plauer03/T3_3200/README.md

# T3_3200
Studienarbeit II - Entwicklung eines BLDC-Motorcontrollers

STRG + SHIFT + P
Settings.json
```json
{
    "workbench.colorTheme": "Ayu Mirage Bordered",
    "vs-kubernetes": {
        "vscode-kubernetes.helm-path-windows": "C:\\Users\\Pascal Lauer\\.vs-kubernetes\\tools\\helm\\windows-amd64\\helm.exe",
        "vscode-kubernetes.kubectl-path-windows": "C:\\Users\\Pascal Lauer\\.vs-kubernetes\\tools\\kubectl\\kubectl.exe",
        "vscode-kubernetes.minikube-path-windows": "C:\\Users\\Pascal Lauer\\.vs-kubernetes\\tools\\minikube\\windows-amd64\\minikube.exe"
    },
    "workbench.editor.enablePreview": false,
    "editor.wordWrap": "on",
    "files.exclude": {
        "**/*.aux": true,
        "**/*.bbl": true,
        "**/*.bcf": true,
        "**/*.blg": true,
        "**/*.fdb_latexmk": true,
        "**/*.fls": true,
        "**/*.gz": true,
        "**/*.lof": true,
        "**/*.log": true,
        "**/*.lot": true,
        "**/*.out": true,
        "**/*.run.xml": true,
        "**/*.toc": true,
        "**/*.synctex.gz": true,
        "**/*.tdo":true,
        "**/*.nlo":true,
        "**/.gitignore":true,
        "**/*.md":true
    }
}
```
