plauer03/T3_3200/chapters/02_grundlagen.tex

\chapter{Theoretische Grundlagen}
\label{chap:grundlagen}

Dieses Kapitel legt das theoretische Fundament für die Dimensionierung des Motorcontrollers. Im Fokus stehen das elektromechanische Modell des BLDC-Motors, die sensorbasierte Kommutierung sowie die leistungselektronischen Verlust- und Temperaturmodelle, welche die hardwareseitigen Grenzen des Systems definieren. Die hier hergeleiteten Zusammenhänge bilden die Basis für die Bauteilauswahl in Kapitel \ref{chap:entwurf_leistung}.

% ============================================================
% 2.1 Der BLDC Motor
% ============================================================
\section{Grundlagen des BLDC-Motors}
\label{sec:bldc_motor}

Der BLDC-Motor stellt eine technologische Weiterentwicklung der konventionellen Gleichstrommaschine dar, bei der die mechanische Kommutierung durch eine elektronische Steuerung ersetzt wird. Im Gegensatz zu bürstenbehafteten Motoren, bei denen Kohlebürsten und ein Kollektor für die Stromwendung sorgen, erfolgt die Ansteuerung der Statorwicklungen hier in Abhängigkeit von der Rotorlage. Dies eliminiert den mechanischen Verschleiß und die Funkenbildung, was zu einer höheren Zuverlässigkeit, geringerem Wartungsaufwand und einer verbesserten thermischen Charakteristik führt, da die Verlustwärme primär im außenliegenden Stator entsteht und effektiv abgeführt werden kann \cite[S.~9]{MPS_BLDC_AN}.

\subsection{Aufbau und physikalisches Wirkprinzip}
Der mechanische Aufbau gliedert sich primär in den feststehenden Stator und den rotierenden Rotor, wie der Querschnitt in Abbildung \ref{fig:bldc_aufbau} schematisch veranschaulicht.

\subsubsection{Stator}
Der Stator besteht aus geschichteten Stahlblechen (Lamellen), um Wirbelstromverluste zu minimieren. In den Nuten des Stators sind die Wicklungen untergebracht, die meist in drei Phasen ($U, V, W$) angeordnet sind. Diese Wicklungen sind im Stern verschaltet, wobei der Sternpunkt im Motor isoliert ist und nicht nach außen herausgeführt wird.

\subsubsection{Rotor}
Der Rotor trägt die Permanentmagnete. Je nach Anordnung unterscheidet man zwischen Innenläufern, bei denen der Rotor innerhalb des Stators dreht, und Außenläufern. Die Anzahl der magnetischen Pole ($N$ und $S$) variiert je nach Applikation, ist jedoch stets geradzahlig. Eine höhere Polpaarzahl führt bei gleicher elektrischer Frequenz zu einer geringeren mechanischen Drehzahl, erhöht jedoch gleichzeitig das verfügbare Drehmoment.

Das Drehmoment entsteht durch die Lorentzkraft, die auf die bestromten Leiter im Magnetfeld wirkt. Damit eine kontinuierliche Rotation gewährleistet ist, muss das magnetische Feld des Stators dem des Rotors stets um $90^\circ$ vorauseilen.

\begin{figure}[htbp]
    \centering
    \begin{tikzpicture}
        % Bild
        \node[inner sep=0] (img) {};
        
    \end{tikzpicture}
    \caption{Querschnitt und prinzipieller Aufbau eines BLDC-Motors \cite[Abb.~5b]{MPS_BLDC_AN}.}
    \label{fig:bldc_aufbau}
\end{figure}

\subsection{Elektrisches Ersatzmodell und BEMF}
Für die steuerungstechnische Betrachtung und die Dimensionierung der Endstufe wird jede Phase des Motors durch ein elektrisches Ersatzschaltbild (ESB) modelliert (siehe Abbildung \ref{fig:bldc_phase}). Dieses besteht aus einer Reihenschaltung des ohmschen Wicklungswiderstands $R$, der Wicklungsinduktivität $L$ und einer induzierten Spannungsquelle, der sogenannten Gegen-Elektromotorischen Kraft (Back Electromotive Force, BEMF).

\begin{figure}[htbp]
    \centering
    \begin{tikzpicture}
        % Paths, nodes and wires:
        \node[ocirc](N1) at (1, 4.941){} node[anchor=west] at (N1.east){$+$};
        \node[ocirc](N2) at (6, 4.941){} node[anchor=east] at (N2.west){$-$};
        \draw (1, 7) to[european resistor, /tikz/circuitikz/bipoles/length=0.840cm, l_={$R$}] (3, 7);
        \draw (2.375, 7) to[american inductor, /tikz/circuitikz/bipoles/length=0.840cm, l_={$L$}, label distance=0.14cm] (4.625, 7);
        \draw (4.5, 7) to[european voltage source, /tikz/circuitikz/bipoles/length=0.700cm, l_={$e_U$}] (5.75, 7);
        \draw (5.5, 7) -- (6, 7) -| (6, 5);
        \draw (1, 5) -| (1, 7);
        \node[shape=rectangle, minimum width=0.965cm, minimum height=0.465cm] at (0.75, 6.5){} node[anchor=north west, align=left, text width=0.577cm, inner sep=6pt] at (0.25, 6.75){\textcolor{rgb,255:red,227;green,36;blue,0}{\small $i_U$}};
        \path[draw={rgb,255:red,227;green,36;blue,0}, line width=1pt, -stealth] (1, 6.436) -| (1, 6.5);
        \node[shape=rectangle, minimum width=1cm, minimum height=0.5cm] at (3.75, 5.25){} node[anchor=north west, align=left, text width=0.647cm, inner sep=5pt] at (3.25, 5.5){\textcolor{rgb,255:red,0;green,97;blue,255}{\small $v_U$}};
        \path[draw={rgb,255:red,0;green,97;blue,255}, line width=1pt, -stealth] (1.743, 4.944) -- (5.243, 4.944);
    \end{tikzpicture}
    \caption{Einphasiges ESB des BLDC-Motors.}
    \label{fig:bldc_phase}
\end{figure}

Unter Anwendung des Maschensatzes ergibt sich die Spannungsgleichung für eine einzelne Phase (z.\,B. Phase $U$) gemäß Gleichung \ref{eq:phase_voltage}:

\begin{equation}
    v_U(t) = R \cdot i_U(t) + L \cdot \frac{d i_U(t)}{dt} + e_U(t)
    \label{eq:phase_voltage}
\end{equation}

Hierbei ist $v_U$ die anliegende Klemmenspannung, $i_U$ der Phasenstrom und $e_U$ die induzierte Gegenspannung. Die motor-spezifischen Parameter definieren dabei maßgeblich das elektrische Verhalten: Der Wicklungswiderstand $R$ determiniert die ohmschen Verluste, während die Induktivität $L$ die Stromanstiegsgeschwindigkeit begrenzt und den hochfrequenten PWM-Ripple glättet. Die BEMF $e_U$ begrenzt hingegen die erreichbare Maximaldrehzahl, da bei einem Erreichen der Versorgungsspannung kein Strom mehr in den Motor eingeprägt werden kann.

Die BEMF entsteht durch die Rotation des magnetischen Rotorfeldes relativ zu den Statorwicklungen (Induktionsgesetz). In Anlehnung an \cite{Pillay1991} kann die Gegenspannung allgemein beschrieben werden durch:

\begin{equation}
    e_U(t) = k_e \cdot \omega_m \cdot f(\theta_e)
    \label{eq:bemf}
\end{equation}

Dabei ist $k_e$ die spezifische BEMF-Konstante des Motors. Charakteristisch für BLDC-Motoren ist der trapezförmige Verlauf der Funktion $f(\theta_e)$, resultierend aus der Form des magnetischen Flusses im Luftspalt. Um ein konstantes Drehmoment zu erzeugen, sollte der Phasenstrom idealerweise als $120^\circ$-Block eingeprägt werden, sodass er exakt mit dem flachen Dach der trapezförmigen BEMF korrespondiert (vgl. Abbildung \ref{fig:bemf_trapez}).

\begin{figure}[htbp]
    \centering
    \begin{tikzpicture}
        % Bild
        \node[inner sep=0] (img) {};
        
        % Entwurf-Banner

    \end{tikzpicture}
    \caption{Verlauf der BEMF und der korrespondierenden Blockströme \cite[Abb.~15]{MPS_BLDC_AN}.}
    \label{fig:bemf_trapez}
\end{figure}

% ============================================================
% 2.2 Kommutierung
% ============================================================
\section{Kommutierung und Ansteuerung}
\label{sec:kommutierung}

Damit der Motor ein kontinuierliches Drehmoment erzeugt, müssen die Statorwicklungen synchron zur aktuellen Rotorposition bestromt werden. Ziel der Kommutierung ist es, den Winkel zwischen dem Erregerfeld des Rotors und dem Statorfeld im Bereich von $90^\circ$ elektrisch zu halten, da hierbei die maximale Lorentzkraft wirkt.

\subsection{Brückentopologie und Bootstrap-Prinzip}
\label{subsec:topologie}
Die leistungselektronische Umsetzung der Kommutierung erfolgt über eine dreiphasige Wechselrichterbrücke (B6-Brücke). Das Prinzipschaltbild ist in Abbildung \ref{fig:three_phase_bridge} dargestellt. Die Schaltung besteht aus drei parallel am Gleichspannungszwischenkreis ($V_{\mathrm{DC}}$) liegenden Halbbrücken, welche die Phasen an die Versorgungsspannung (High-Side) oder an das Bezugspotential (Low-Side) schalten können.

\begin{figure}[htbp]
    \centering
    \begin{tikzpicture}
        % Paths, nodes and wires:
        \node[nigfete, bodydiode] at (3, 7.008){};
        \node[nigfete, bodydiode] at (3, 5){};
        \node[nigfete, bodydiode] at (5, 7.008){};
        \node[nigfete, bodydiode] at (5, 5){};
        \node[nigfete, bodydiode] at (7, 7){};
        \node[nigfete, bodydiode] at (7, 4.992){};

        \draw (3, 7.778) -- (3, 8.25) -- (5, 8.25) -| (5, 7.778);
        \draw (7, 7.75) -| (7, 8.25) -- (5, 8.25);
        \draw (3, 4.25) -| (3, 3.75) -- (5, 3.75) -| (5, 4.23);
        \draw (7, 4.222) -| (7, 3.75) |- (5, 3.75);

        \draw (3, 6.238) -- (3, 5.75);
        \draw (5, 6.238) -| (5, 5.77);
        \draw (7, 6.25) -| (7, 5.75);

        \node[circ](N1) at (3, 6){} node[anchor=west] at ([xshift=0.04cm]N1.east){$U$};
        \node[circ](N2) at (5, 6){} node[anchor=west] at (N2.east){$V$};
        \node[circ](N3) at (7, 6){} node[anchor=west] at (N3.east){$W$};

        \draw (1, 7) to[european voltage source, 
              /tikz/circuitikz/bipoles/length=0.910cm, 
              l={$36\,\mathrm{V}$}] (1, 5);

        \draw (1, 7) -| (1, 8.25) -- (3, 8.25);
        \draw (1, 5) -| (1, 3.75) -- (3, 3.75);
    \end{tikzpicture}
    \caption{Prinzipschaltbild einer B6-Brücke zur Ansteuerung des Motors.}
    \label{fig:three_phase_bridge}
\end{figure}

In der vorliegenden Niederspannungsanwendung werden aus Effizienzgründen ausschließlich N-Kanal-MOSFETs eingesetzt. Da der High-Side-Transistor zum vollständigen Durchsteuern jedoch eine Gate-Spannung oberhalb der Zwischenkreisspannung benötigt, wird eine Bootstrap-Schaltung implementiert. Ein Kondensator lädt sich dabei während der Leitphase des Low-Side-Schalters auf. Schaltet die Halbbrücke um, „schwimmt“ das Potential des Kondensators mit der Source-Spannung nach oben und stellt dem Treiber die notwendige Überspannung bereit \cite[S.~1]{AN6076}.

\subsection{Sensorbasierte Blockkommutierung}
Zur Erfassung der absoluten Rotorlage verfügt der Motor über drei im Stator integrierte Hall-Sensoren, welche räumlich um $120^\circ$ elektrisch versetzt angeordnet sind. Dieser Versatz teilt eine elektrische Umdrehung in sechs eindeutig identifizierbare, $60^\circ$ breite Sektoren.

Die hardwarenahe und robusteste Methode zur Ansteuerung ist die sogenannte Blockkommutierung (Six-Step-Commutation). Hierbei werden dem jeweiligen Hall-Zustand feste Schaltmuster zugeordnet. Zu jedem Zeitpunkt sind exakt zwei Phasen aktiv bestromt, während die dritte Phase hochohmig verbleibt. Die Zustandslogik für das Invertersystem ist in Tabelle \ref{tab:kommutierung} zusammengefasst.

\begin{table}[htbp]
    \centering
    \caption{Zustandstabelle der Blockkommutierungslogik in Abhängigkeit der Hall-Sensoren}
    \label{tab:kommutierung}
    \begin{tabular}{ccc ccc c}
        \toprule
        \multicolumn{3}{c}{\textbf{Hall-Sensoren}} & 
        \multicolumn{3}{c}{\textbf{Phasenzustand}} & 
        \textbf{Sektor} \\
        \cmidrule(lr){1-3} \cmidrule(lr){4-6}
        $\mathbf{H_1}$ & $\mathbf{H_2}$ & $\mathbf{H_3}$ & $\mathbf{U}$ & $\mathbf{V}$ & $\mathbf{W}$ & \\
        \midrule
        1 & 0 & 1 & $\mathrm{V_{DC}}$ & GND & NC & I \\
        1 & 0 & 0 & $\mathrm{V_{DC}}$ & NC & GND & II \\
        1 & 1 & 0 & NC & $\mathrm{V_{DC}}$ & GND & III \\
        0 & 1 & 0 & GND & $\mathrm{V_{DC}}$ & NC & IV \\
        0 & 1 & 1 & GND & NC & $\mathrm{V_{DC}}$ & V \\
        0 & 0 & 1 & NC & GND & $\mathrm{V_{DC}}$ & VI \\
        \bottomrule
    \end{tabular}
\end{table}

In der hier verwendeten Blockkommutierung sind die Phasenströme nicht sinusförmig, sondern werden idealerweise als 120° breite Stromblöcke eingeprägt, die mit den flachen Dächern der trapezförmigen BEMF überlappen. Der Effektivwert \(I\text{RMS}\) eines Stroms ist allgemein über eine elektrische Periode als quadratischer Mittelwert definiert und gilt unabhängig von der Stromform. Für einen idealen 120°-Blockstrom ergibt sich daraus $I_\mathrm{RMS}=\sqrt{2/3}$. In dieser Arbeit wird der Nennstrom des Motors jedoch zunächst als äquivalenter sinusförmiger Phasenstrom angegeben und anschließend in einen zugehörigen Block-Spitzenstrom umgerechnet, der für die elektrische und thermische Auslegung maßgeblich ist. Um das erzeugte Drehmoment regeln zu können, werden die MOSFETs der aktiven Phasen mit einem pulsweitenmodulierten Signal (PWM) hochfrequent getaktet. Das sich ergebende Tastverhältnis $d$ moduliert die anliegende effektive Phasenspannung gemäß der Relation $\bar{v}_{\mathrm{ph}} = d \cdot V_{\mathrm{DC}}$ und bestimmt somit den mittleren Motorstrom.

\subsection{Begründung der Verfahrenswahl}
\label{subsec:verfahrenswahl}
In der modernen Antriebstechnik hat sich neben der Blockkommutierung die Raumzeigermodulation (SVPWM) als Standard etabliert. Dabei wird ein kontinuierlich rotierender Spannungsraumzeiger durch eine präzise Überlagerung aller drei Halbbrücken generiert. Theoretisch bietet die SVPWM eine um den Faktor $2\cdot\sqrt{3}^{-1} \approx 1{,}15$ bessere Ausnutzung der Zwischenkreisspannung sowie eine Reduktion der Drehmomentwelligkeit wie in \cite{Xia2012} beschrieben.

Für den im Rahmen dieser Arbeit konzipierten Motorcontroller wird jedoch bewusst auf eine SVPWM zugunsten der robusten Blockkommutierung verzichtet. Die Ursache liegt in den systembedingten Einschränkungen der Rotorlageerfassung. Die SVPWM erfordert zur exakten Vektorsynthese einen kontinuierlichen und hochaufgelösten Rotorwinkel. Da die vorhandenen Hall-Sensoren jedoch lediglich eine diskrete Auflösung von $60^\circ$ aufweisen, müsste der Winkel zwischen zwei Schaltflanken vom Mikrocontroller zeitbasiert interpoliert werden. 

Während diese lineare Interpolation bei stationären Drehzahlen zufriedenstellend funktioniert, führt sie bei hochdynamischen Lastwechseln unweigerlich zu massiven Schätzfehlern. Die fehlerhaft interpolierte Rotorlage erzwingt das Anlegen falscher Raumzeigervektoren, was im Verlust der Synchronität oder sogar in der Zerstörung der Leistungsendstufe durch parasitäre Fehlströme resultieren kann. Da kein hochauflösender optischer oder magnetischer Encoder vorgesehen ist, stellt die strikt zustandsbasierte Blockkommutierung die deutlich betriebssicherere und technisch überlegene Lösung für dynamische Traktionsantriebe dar.

\subsection{Vierquadrantenbetrieb und Rekuperation}
\label{subsec:rekuperation}
Ein Traktionsantrieb muss neben dem motorischen Betrieb auch das aktive Bremsen beherrschen. Da der BLDC-Motor bei Rotation eine Spannung in den Statorwicklungen induziert, kann er kinetische Energie in elektrische Energie umwandeln.
Da die induzierte Gegenspannung bei niedrigen Drehzahlen oft geringer ist als die Zwischenkreisspannung, wird die B6-Brücke in diesem Zustand leistungselektronisch als aktiver Aufwärtswandler betrieben. Durch geeignetes Takten der Low-Side-Transistoren wird magnetische Energie in den Motorinduktivitäten zwischengespeichert und anschließend auf das höhere Spannungsniveau des Zwischenkreises gepumpt. Qualitativ vertauschen sich beim Übergang vom motorischen in den generatorischen Betrieb lediglich die Rollen der taktenden und freilaufenden Schalter.

\subsection{Prinzip der Phasenstromerfassung}
\label{subsec:stromerfassung}
Für einen sicheren Betrieb ist die Kenntnis des Phasenstroms unerlässlich. Bei hochdynamischen Lastwechseln oder einer mechanischen Blockade des Rotors verschwindet die induzierte Gegenspannung ($e_U \approx 0$). Gemäß der Spannungsgleichung \ref{eq:phase_voltage} würde die anliegende Spannung in diesem Moment nur durch den sehr geringen ohmschen Wicklungswiderstand begrenzt werden, was physikalisch zu zerstörerischen Kurzschlussströmen führt. 
Um diesen Strom in einer B6-Brücke mit Blockkommutierung messtechnisch erfassen zu können, wird eine Single-Shunt-Topologie verwendet. Hierbei wird ein einzelner, niederohmiger Messwiderstand (Shunt) in den gemeinsamen Rückleiterpfad (GND) der drei Low-Side-Halbbrücken platziert. Da bei der Blockkommutierung stets exakt eine Phase den Hin- und eine Phase den Rückstrom führt, entspricht der im Gleichspannungszwischenkreis gemessene Stromwert betragsmäßig dem aktuell fließenden Phasenstrom.

% ============================================================
% 2.5 Verlustmechanismen
% ============================================================
\section{Verlustmechanismen in Leistungshalbleitern}
\label{sec:verluste}

Ein idealer Halbleiter würde verlustfrei arbeiten und Zustandswechsel in unendlich kurzer Zeit vollziehen. Reale Transistoren und Dioden weisen jedoch parasitäre Eigenschaften auf, die unvermeidlich zu einer Verlustleistung führen. Diese elektrische Leistung wird in Wärmeenergie umgewandelt und muss über das thermische Management abgeführt werden, um eine Zerstörung des Bauteils zu verhindern. 
Die Gesamtverluste in einer leistungselektronischen Halbbrücke setzen sich primär aus Leit- und Schaltverlusten der Schalter sowie der zugehörigen Freilaufdioden zusammen. Sperrverluste (Leakage Losses), die durch Leckströme im blockierenden Zustand entstehen, liegen bei Niederspannungsanwendungen im Mikrowatt-Bereich und können für die thermische Dimensionierung vernachlässigt werden \cite[S.~3]{Infineon_MOSFET_Losses}.

% ------------------------------------------------------------
\subsection{Verluste im MOSFET}
\label{subsec:mosfet_verluste}

Die Verluste im MOSFET dominieren die thermische Belastung des Motorcontrollers. Abbildung \ref{fig:id_mosfet} verdeutlicht den Unterschied zwischen dem idealen und dem realen Schaltverhalten am Beispiel einer induktiv belasteten Halbbrücke, wie sie im Motorinverter vorliegt.

\begin{figure}[htbp]
    \centering
    % --- Linker Subplot (a) ---
    \begin{subfigure}[b]{0.48\textwidth}
        \centering
        \begin{tikzpicture}
            \begin{axis}[
                width=\textwidth, height=6cm,
                axis lines=middle, axis on top,
                xmin=-1, xmax=10, ymin=-1, ymax=5,
                xlabel={$t$}, ylabel={$i_\mathrm{S}, v_\mathrm{S}$},
                xtick={0, 4, 8}, xticklabels={0, $\delta T$, $T$},
                ytick={3.5, 1.5, 2.5}, yticklabels={$v_\mathrm{i}$, $i_{L,0}$, $i_{L,\delta T}$},
                ticklabel style={font=\small},
                xticklabel style={fill=white, fill opacity=0.7, text opacity=1, inner sep=1pt},
                enlargelimits=false, clip=false
            ]
                \draw[densely dotted, thick] (axis cs:0,3.5) -- (axis cs:4,3.5);                
                \draw[densely dotted, thick] (axis cs:0,2.5) -- (axis cs:4,2.5);
                \draw[densely dotted, thick] (axis cs:0,1.5) -- (axis cs:8,1.5);
                \addplot[color=red, very thick] coordinates {(0,0) (0,1.5) (4,2.5) (4,0) (8,0) (8,1.5) (10,2)};
                \addplot[color=blue, very thick, densely dashed] coordinates {(0,3.5) (0,0) (4,0) (4,3.5) (8,3.5) (8,0) (10,0)};
            \end{axis}
        \end{tikzpicture}
        \caption{Idealer Schalter}
        \label{fig:ideal}
    \end{subfigure}
    \hfill
    % --- Rechter Subplot (b) ---
    \begin{subfigure}[b]{0.48\textwidth}
        \centering
        \begin{tikzpicture}
            \begin{axis}[
                width=\textwidth, height=6cm,
                axis lines=middle, axis on top,
                xmin=-1, xmax=10, ymin=-1, ymax=5,
                xlabel={$t$}, ylabel={$i_\mathrm{S}, v_\mathrm{S}$},
                xtick={0, 4, 8}, xticklabels={0, $\delta T$, $T$},
                ytick={3.5, 1.5, 2.5}, yticklabels={$v_\mathrm{i}$, $i_{L,0}$, $i_{L,\delta T}$},
                ticklabel style={font=\small},
                xticklabel style={fill=white, fill opacity=0.7, text opacity=1, inner sep=1pt},
                enlargelimits=false, clip=false
            ]
                \draw[densely dotted, thick] (axis cs:0,3.5) -- (axis cs:4.2,3.5);                
                \draw[densely dotted, thick] (axis cs:0,2.5) -- (axis cs:4.2,2.5);
                \draw[densely dotted, thick] (axis cs:0,1.5) -- (axis cs:8.2,1.5);
                \addplot[color=blue, very thick, densely dashed] coordinates {(0,3.5) (0.2,0) (4,0.1) (4.2,3.5) (8,3.5) (8.2,0) (10,0.05)};
                \addplot[color=red, very thick] coordinates {(0,0) (0.2,1.5) (4,2.5) (4.2,0) (8,0) (8.2,1.5) (10,2)};
            \end{axis}
        \end{tikzpicture}
        \caption{Realer Schalter}
        \label{fig:real}
    \end{subfigure}

    \caption{Spannungs- und Stromverlauf in einer induktiv belasteten Halbbrücke.}
    \label{fig:id_mosfet}
\end{figure}

\subsubsection{Leitverluste}
Im statisch eingeschalteten Zustand verhält sich der Drain-Source-Kanal des MOSFETs näherungsweise wie ein ohmscher Widerstand $R_{\mathrm{DS(on)}}$. Die daraus resultierenden Leitverluste lassen sich in Abhängigkeit des Effektivstroms $I_{\mathrm{RMS}}$ berechnen:

\begin{equation}
    P_{\mathrm{MOS,c}} = I_{\mathrm{RMS}}^2 \cdot R_{\mathrm{DS(on)}}(T_\mathrm{J})
    \label{eq:p_cond}
\end{equation}

Kritisch für die Systemstabilität ist hierbei die Temperaturabhängigkeit. Der Kanalwiderstand steigt mit zunehmender Sperrschichttemperatur $T_\mathrm{J}$ signifikant an. Dies führt zu einem positiven thermischen Rückkopplungseffekt, der bei der Auslegung zwingend berücksichtigt werden muss. Der entsprechende Wert für $R_\mathrm{DS(on)}$ kann aus der Datenblattkennlinie des Herstellers bestimmt werden.

\subsubsection{Schaltverluste}
Da MOSFETs bauartbedingt nicht unendlich schnell umschalten können, treten beim Übergang zwischen dem leitenden und sperrenden Zustand Transienten auf. In diesen Phasen überlappen sich Spannung und Strom (vgl. Abb. \ref{fig:id_mosfet} rechts), wodurch Momentanleistung in Wärme umgesetzt wird.

Für die Berechnung der Schaltverluste ist es dabei ausreichend, den Schaltvorgang näherungsweise linear zu betrachten, was zugleich eine konservative Worst-Case-Abschätzung darstellt \cite[S.~6]{Infineon_MOSFET_Losses}. Der idealisierte Verlauf umfasst insbesondere den zeitlichen Anstieg der Gate-Spannung, die Stromübernahme durch den MOSFET sowie die Umladevorgänge der parasitären Kapazitäten und die Effekte der Diodenrückwärtserholung (Reverse Recovery).

Maßgeblich für die Schaltdynamik sind die internen parasitären Kapazitäten des Halbleiters (siehe Abbildung \ref{fig:mosfet_cap}). Von besonderer Bedeutung ist die Gate-Drain-Kapazität $C_{\mathrm{GD}}$ (Miller-Kapazität). Während des Schaltvorgangs führt das Umladen dieser Kapazität zum sogenannten Miller-Plateau, einem Zustand, in dem die Gate-Spannung konstant verharrt, bis die Drain-Source-Spannung vollständig kommutiert ist.

\begin{figure}[htbp]
\centering
\begin{tikzpicture}
% Paths, nodes and wires:
\node[vcc, xscale=0.7, yscale=0.7] at (5, 7.743){};
\draw (5, 7.04) -| (5, 8);
\draw (0, 6) to[european resistor, /tikz/circuitikz/bipoles/length=0.840cm, l_={$R_\mathrm{G}$}] (2, 6);
\node[shape=rectangle, minimum width=0.965cm, minimum height=0.465cm] at (2.093, 6.397){} node[anchor=north west, align=left, text width=0.577cm, inner sep=6pt] at (1.593, 6.647){\textcolor{rgb,255:red,227;green,36;blue,0}{\small $i_G$}};
\path[draw={rgb,255:red,227;green,36;blue,0}, line width=0.6pt, -stealth] (1.936, 6) |- (2, 6);
\draw (0, 6) to[european voltage source, /tikz/circuitikz/bipoles/length=0.840cm, l_={\textcolor{rgb,255:red,0;green,97;blue,255}{$v_\mathrm{dr}$}}, label distance=0.32cm] (0, 4);
\draw (0, 4) -- (3, 4);
\node[nigfetd, bodydiode] at (5, 6.27){};
\draw (2, 6) -- (4.02, 6);
\draw (4, 6) to[capacitor, l={$C_\mathrm{GD}$}] (4, 7.421);
\draw (4, 5) to[capacitor, l={$C_\mathrm{GS}$}] (4, 6);
\draw (4, 5) -- (5, 5);
\draw (5, 5) -- (6, 5);
\draw (6, 5) to[capacitor, l_={$C_\mathrm{DS}$}] (6, 7.421);
\draw (4, 7.421) -- (6, 7.421);
\node[circ] at (4, 6){};
\node[circ] at (5, 5){};
\node[circ] at (4.997, 7.428){};
\node[shape=rectangle, minimum width=0.965cm, minimum height=0.465cm] at (5.5, 7.832){} node[anchor=north west, align=left, text width=0.577cm, inner sep=6pt] at (5, 8.082){\textcolor{rgb,255:red,227;green,36;blue,0}{\small $i_D$}};
\path[draw={rgb,255:red,227;green,36;blue,0}, line width=0.6pt, -stealth] (5.007, 7.742) -- (5.007, 7.678);
\path[draw={rgb,255:red,0;green,97;blue,255}, -stealth] (-0.416, 5.339) -- (-0.416, 4.68);
\draw (5, 5.5) -- (5, 4) -- (3, 4);
\end{tikzpicture}
\caption{Interne parasitäre Kapazitäten eines MOSFETs.}
\label{fig:mosfet_cap}
\end{figure}

Die Schaltverluste setzen sich maßgeblich aus der Summe der Einschalt- ($P_{\mathrm{MOS,on}}$) und Ausschaltverluste ($P_{\mathrm{MOS,off}}$) zusammen, die im Folgenden hergeleitet werden.

\subsubsection*{Einschaltvorgang ($P_{\mathrm{MOS,on}}$)}
Beim Einschalten wird der MOSFET durch die Treiberstufe von $0\,\mathrm{V}$ auf die Treiberspannung $v_\mathrm{dr}$ angesteuert. Zunächst steigt die Gate-Source-Spannung mit einer durch $R_\mathrm{G}$ und die Eingangskapazität $C_{\mathrm{iss}}$ bestimmten Zeitkonstante an, ohne dass sich der Laststrom ändert. Erst beim Erreichen der Schwellspannung $v_{\mathrm{GS,th}}$ beginnt der Drainstrom anzusteigen und übernimmt den Laststrom.
Während dieser Stromanstiegsphase liegt weiterhin nahezu die volle Drain-Source-Spannung an, sodass eine Überlappung von Strom und Spannung entsteht. Zusätzlich muss beim Einschalten die Rückwärtserholung der Freilaufdiode berücksichtigt werden. Die im Halbleiter gespeicherten Ladungsträger führen zu einem zusätzlichen Stromanteil (Reverse-Recovery-Strom), der vom MOSFET aufgenommen werden muss und die Einschaltverluste erhöht \cite[S.~6]{Infineon_MOSFET_Losses}. Die entsprechenden Werte können wiederum aus dem Datenblatt des MOSFETs bestimmt werden. Der Einschaltvorgang ist in Abbildung \ref{fig:mosfet_einschaltvorgang} dargestellt.

\begin{figure}[htbp]
    \centering
    \begin{tikzpicture}
        \begin{axis}[
            width=0.75\textwidth, height=7cm,
            axis lines=middle, axis on top,
            xmin=0, xmax=12.5, ymin=0, ymax=10.5,
            xlabel={$t$}, ylabel={$v, i$},
            every axis x label/.style={at={(current axis.right of origin)},anchor=west, font=\large},
            every axis y label/.style={at={(current axis.above origin)},anchor=west, font=\large},
            xtick={1, 2, 4, 8, 11},
            xticklabels={$t_0$, $t_1$, $t_2$, $t_3$, $t_4$},
            ytick={1, 3, 5, 7, 9},
            yticklabels={$v_\mathrm{GS,th}$, $v_\mathrm{GS,Mi}$, $v_\mathrm{dr}$, $i_\mathrm{L,0}$, $v_\mathrm{i}$},
            ticklabel style={font=\normalsize},
            xticklabel style={fill=white, fill opacity=0.7, text opacity=1, inner sep=1pt},
            legend style={
                at={(1.1,1.1)}, anchor=north east, 
                legend columns=4, 
                column sep=1ex,
                nodes={scale=0.9, transform shape}
            },
            enlargelimits=false, clip=false
        ]
            \draw[densely dotted, thick] (axis cs:0,7) -- (axis cs:4,7);
            \draw[densely dotted, thick] (axis cs:0,3) -- (axis cs:4,3);
            \draw[densely dotted, thick] (axis cs:0,1) -- (axis cs:2,1) -- (axis cs:2,0);

            \addplot[color=blue, line width=2pt, dashed, dash pattern=on 6pt off 4pt] coordinates {
                (0,9) (4,9) (8,0.15) (12.2,0.05)
            };
            \addlegendentry{$v_\mathrm{DS}$}

            \addplot[color=red, line width=2pt] coordinates {
                (0,0) (2,0) (4,7) (12.2,7)
            };
            \addlegendentry{$i_\mathrm{D}$}

            \addplot[color=orange, line width=2pt] coordinates {
                (0,0) (1,0) (1,5) (12.2,5)
            };
            \addlegendentry{$v_\mathrm{dr}$}

            \addplot[color=green!80!black, line width=2pt, dashed, dash pattern=on 6pt off 4pt] coordinates {
                (0,0) (1,0) (2,1) (4,3) (8,3) 
                (8.5, 3.8) (9.0, 4.3) (9.5, 4.6) (10.0, 4.8) (10.5, 4.9) (11.0, 4.95) (12.2, 5.0)
            };
            \addlegendentry{$v_\mathrm{GS}$}
        \end{axis}
    \end{tikzpicture}
    \caption{Einschaltvorgang eines MOSFETs in einer induktiv belasteten Halbbrücke.}
    \label{fig:mosfet_einschaltvorgang}
\end{figure}

Der $v_\mathrm{GS}$-Verlauf zwischen $t_2 \le t \le t_3$ wird als Millerplateau bezeichnet. Aus dem Datenblatt lässt sich anhand von $v_\mathrm{GS,th}$ und der Miller-Spannung $v_\mathrm{GS,Mi}$ die benötigte Umschaltladung $Q_\mathrm{sw}$ ablesen. Diese charakterisiert das für die verlustbehaftete Strom-Spannungs-Überlappung relevante Zeitintervall $t_1 \le t \le t_3$. Der sich in dieser Phase einstellende Gatestrom $i_\mathrm{G}$ lässt sich mittels der Maschenregel ermitteln:

\begin{equation}
    i_\mathrm{G} = \frac{v_\mathrm{dr} - v_\mathrm{GS,Mi}}{R_\mathrm{G}}
    \label{eq:ig_einschaltvorgang}
\end{equation}

Unter Anwendung des physikalischen Zusammenhangs von Ladung und Strom ($Q = I \cdot \Delta t$) kann die Dauer der relevanten Einschaltflanke $(t_3 - t_1)$ berechnet werden. Durch Einsetzen von Gleichung \ref{eq:ig_einschaltvorgang} in diese Beziehung ergibt sich:

\begin{equation}
    (t_3 - t_1) = \frac{Q_\mathrm{sw} \cdot R_\mathrm{G}}{v_\mathrm{dr} - v_\mathrm{GS,Mi}}
    \label{eq:t3t1_einschaltvorgang}
\end{equation}

Mit Kenntnis dieses kritischen Zeitintervalls lässt sich die während eines einzelnen Einschaltvorgangs im MOSFET dissipierte Gesamtenergie berechnen:

\begin{equation}
    E_\mathrm{MOS,on} = \frac{1}{2} i_\mathrm{L,0} \cdot v_\mathrm{i} \cdot (t_3 - t_1) + E_{\mathrm{MOS,on,rr}}
    \label{eq:energie_einschaltvorgang}
\end{equation}

Der zusätzliche Energieanteil $E_{\mathrm{MOS,on,rr}}$ resultiert aus der im pn-Übergang der gegenüberliegenden Freilaufdiode gespeicherten Sperrverzögerungsladung $Q_{\mathrm{rr}}$. Da der Halbleiterschalter diesen transienten Strompuls bei nahezu voller Zwischenkreisspannung $v_\mathrm{i}$ aufnehmen muss, berechnet sich der entsprechende Verlustanteil im MOSFET gemäß \cite[S.~10]{Infineon_MOSFET_Losses} zu:

\begin{equation}
    E_{\mathrm{MOS,on,rr}} = Q_{\mathrm{rr}} \cdot v_\mathrm{i}
    \label{eq:energie_einschaltvorgang_rr}
\end{equation}

\subsubsection*{Ausschaltvorgang ($P_{\mathrm{MOS,off}}$)}

Der Ausschaltvorgang verhält sich prinzipiell invers zum Einschaltvorgang. Abbildung \ref{fig:mosfet_ausschaltvorgang} visualisiert den idealisierten zeitlichen Verlauf der maßgeblichen Größen.

\begin{figure}[htbp]
    \centering
    \begin{tikzpicture}
        \begin{axis}[
            width=0.75\textwidth, height=7cm,
            axis lines=middle, axis on top,
            xmin=0, xmax=12.5, ymin=0, ymax=10.5,
            xlabel={$t$}, ylabel={$v, i$},
            every axis x label/.style={at={(current axis.right of origin)},anchor=west, font=\large},
            every axis y label/.style={at={(current axis.above origin)},anchor=west, font=\large},
            xtick={1, 2, 8, 9.5, 11},
            xticklabels={$t_0$, $t_1$, $t_2$, $t_3$, $t_4$},
            ytick={1, 3, 5, 7, 9},
            yticklabels={$v_\mathrm{GS,th}$, $v_\mathrm{GS,Mi}$, $v_\mathrm{dr}$, $i_\mathrm{L,\delta T}$, $v_\mathrm{i}$},
            ticklabel style={font=\normalsize},
            xticklabel style={fill=white, fill opacity=0.7, text opacity=1, inner sep=1pt},
            legend style={
                at={(1.1,1.1)}, anchor=north east, 
                legend columns=4, 
                column sep=1ex,
                nodes={scale=0.9, transform shape}
            },
            enlargelimits=false, clip=false
        ]
            \draw[densely dotted, thick] (axis cs:0,9) -- (axis cs:8,9);
            \draw[densely dotted, thick] (axis cs:0,3) -- (axis cs:2,3);
            \draw[densely dotted, thick] (axis cs:0,1) -- (axis cs:9.5,1) -- (axis cs:9.5,0);

            \addplot[color=blue, line width=2pt, dashed, dash pattern=on 6pt off 4pt] coordinates {
                (0,0.05) (2,0.15) (8,9) (12.2,9)
            };
            \addlegendentry{$v_\mathrm{DS}$}

            \addplot[color=red, line width=2pt] coordinates {
                (0,7) (8,7) (9.5,0) (12.2,0)
            };
            \addlegendentry{$i_\mathrm{D}$}

            \addplot[color=orange, line width=2pt] coordinates {
                (0,5) (1,5) (1,0) (12.5,0)
            };
            \addlegendentry{$v_\mathrm{dr}$}

            \addplot[color=green!80!black, line width=2pt, dashed, dash pattern=on 6pt off 4pt] coordinates {
                (0,5) (1,5) (2,3) (8,3) 
                (8.5, 2.4) (9.0, 1.7) (9.5, 1.0) (10.0, .4) (10.5, 0.1) (11, 0) (12.2, 0)
            };
            \addlegendentry{$v_\mathrm{GS}$}
        \end{axis}
    \end{tikzpicture}
    \caption{Ausschaltvorgang eines MOSFETs in einer induktiv belasteten Halbbrücke.}
    \label{fig:mosfet_ausschaltvorgang}
\end{figure}

Analog zum Einschaltvorgang bestimmt sich der Gatestrom während der Entladung der Miller-Kapazität. Bei einer treiberseitigen Abschaltschwellenspannung von $v_\mathrm{dr,off}$ lautet die entsprechende Maschengleichung:

\begin{equation}
    i_\mathrm{G} = \frac{v_\mathrm{GS,Mi} - v_\mathrm{dr,off}}{R_\mathrm{G}}
    \label{eq:ig_ausschaltvorgang}
\end{equation}

Mithilfe der Umschaltladung $Q_\mathrm{sw}$ lässt sich die Gleichung nach dem zeitlichen Ausräumintervall der Ladungsträger $(t_3 - t_1)$ umstellen. Eingesetzt ergibt sich die Dauer der Schaltflanke zu:

\begin{equation}
    (t_3 - t_1) = \frac{Q_\mathrm{sw} \cdot R_\mathrm{G}}{v_\mathrm{GS,Mi} - v_\mathrm{dr,off}}
    \label{eq:t3t1_ausschaltvorgang}
\end{equation}

Die während dieser Zeitspanne im MOSFET dissipierte Energie $E_\mathrm{MOS,off}$ berechnet sich zu:

\begin{equation}
    E_\mathrm{MOS,off} = \frac{1}{2} i_\mathrm{L,\delta T} \cdot v_\mathrm{i} \cdot (t_3 - t_1)
    \label{eq:energie_ausschaltvorgang}
\end{equation}

Die dynamischen Umschaltverluste des Transistors hängen folglich maßgeblich von der gewählten Umschaltfrequenz $f_\mathrm{sw}$ ab. Die Gesamtschaltverlustleistung $P_\mathrm{MOS,sw}$ resultiert aus den berechneten Schaltenergien $E_\mathrm{MOS,on}$ und $E_\mathrm{MOS,off}$:

\begin{equation}
    P_\mathrm{MOS,sw} = P_\mathrm{MOS,on} + P_\mathrm{MOS,off} = f_\mathrm{sw} \cdot (E_\mathrm{MOS,on} + E_\mathrm{MOS,off})
    \label{eq:umschaltverluste_mos}
\end{equation}

% ------------------------------------------------------------
\subsection{Verluste in der Freilaufdiode}

In einer B6-Brückentopologie wird die Funktion der Freilaufdiode durch die intrinsische Body-Diode der MOSFETs übernommen (vgl. Abb. \ref{fig:three_phase_bridge}). Da der Strom in der Totzeit des Gate-Treibers über diese Diode fließen muss, trägt sie zur Erwärmung bei. Abbildung \ref{fig:id_diode} stellt das Schaltverhalten einer idealen Diode dem einer realen Body-Diode in einer induktiv belasteten Halbbrücke gegenüber.

\begin{figure}[htbp]
    \centering
    
    % --- Subplot (a): Ideale Diode ---
    \begin{subfigure}[b]{0.48\textwidth}
        \centering
        \begin{tikzpicture}
            \begin{axis}[
                width=\textwidth, height=6.5cm,
                axis lines=middle, axis on top,
                xmin=-1, xmax=10, ymin=-4.5, ymax=6,
                xlabel={$t$}, ylabel={$i_\mathrm{D}, v_\mathrm{D}$},
                xtick={0, 4, 8}, xticklabels={0, $\delta T$, $T$},
                ytick={-3, 2.5, 4.5}, yticklabels={$-v_\mathrm{i}$, $i_{L,0}$, $i_{L,\delta T}$},
                ticklabel style={font=\small},
                xticklabel style={fill=white, fill opacity=0.7, text opacity=1, inner sep=1pt},
                enlargelimits=false, clip=false
            ]
                % Hilfslinien
                \draw[densely dotted, thick] (axis cs:0,4.5) -- (axis cs:4,4.5);
                \draw[densely dotted, thick] (axis cs:0,2.5) -- (axis cs:8,2.5);

                % Strom i_D (rot)
                \addplot[color=red, very thick] coordinates {
                    (0,2.5) (0,0) (4,0) (4,4.5) (8,2.5) (8,0) (9.5,0)
                };
                % Spannung v_D (blau)
                \addplot[color=blue, very thick, densely dashed] coordinates {
                    (0,0) (0,-3) (4,-3) (4,0) (8,0) (8,-3) (9.5,-3)
                };
            \end{axis}
        \end{tikzpicture}
        \caption{Ideale Diode}
        \label{fig:diode_ideal}
    \end{subfigure}
    \hfill
    % --- Subplot (b): Reale Diode ---
    \begin{subfigure}[b]{0.48\textwidth}
        \centering
        \begin{tikzpicture}
            \begin{axis}[
                width=\textwidth, height=6.5cm,
                axis lines=middle, axis on top,
                xmin=-1, xmax=10, ymin=-4.5, ymax=6,
                xlabel={$t$}, ylabel={$i_\mathrm{D}, v_\mathrm{D}$},
                xtick={0, 4, 8}, xticklabels={0, $\delta T$, $T$},
                ytick={-3, 2.5, 4.5}, yticklabels={$-v_\mathrm{i}$, $i_{L,0}$, $i_{L,\delta T}$},
                ticklabel style={font=\small},
                xticklabel style={fill=white, fill opacity=0.7, text opacity=1, inner sep=1pt},
                enlargelimits=false, clip=false
            ]
                % Hilfslinien
                \draw[densely dotted, thick] (axis cs:0,4.5) -- (axis cs:4,4.5);
                \draw[densely dotted, thick] (axis cs:0,2.5) -- (axis cs:8,2.5);

                % Strom i_D (rot)
                \addplot[color=red, very thick] coordinates {
                    (0,2.5) (0,-1) (0.15,-0.3) (0.3,0) (4,0) (4,4.5) (8,2.5) (8,-1) (8.15,-0.3) (8.3,0) (9.5,0)
                };
                % Spannung v_D (blau)
                \addplot[color=blue, very thick, densely dashed] coordinates {
                    (0,0) (0,-3) (4,-3) (4.05,1) (4.15,0.6) (4.3,0.5) (8,0.2) (8,-3) (8.6,-3) (9.5,-3)
                };
            \end{axis}
        \end{tikzpicture}
        \caption{Reale Diode}
        \label{fig:diode_real}
    \end{subfigure}
    
    \caption{Spannungs- und Stromverlauf in einer induktiv belasteten Halbbrücke.}
    \label{fig:id_diode}
\end{figure}
\subsubsection{Durchlassverluste ($P_{\mathrm{D,c}}$)}
Während der Leitphase fällt an der Diode eine nichtlineare Durchlassspannung $v_\mathrm{D}$ ab. Die mittleren Leitverluste berechnen sich über das Integral der Momentanleistung:

\begin{equation}
    P_{\mathrm{D,c}} = \frac{1}{T} \int_{0}^{T} i_\mathrm{D}(t) \cdot v_\mathrm{D}(t) \, \mathrm{d}t
    \label{eq:p_d_con}
\end{equation}

Zur analytischen Berechnung wird die Diodenkennlinie durch eine Reihenschaltung aus einer Schwellenspannung $v_{\mathrm{D,0}}$ und einem differentiellen Widerstand $r_\mathrm{D}$ approximiert (vgl. \cite[Abb.~2]{Infineon_MOSFET_Losses}). Durch diese Annäherung lassen sich die resultierenden Verluste in einen spannungs- und einen widerstandsabhängigen Anteil ($P_\mathrm{U}$ und $P_\mathrm{R}$) unterteilen. Mithilfe dieser Näherung ergibt sich:

\begin{equation}
    P_{\mathrm{D,c}} = P_\mathrm{U} + P_\mathrm{R} = v_{\mathrm{D,0}} \overline{i}_{\mathrm{D}} + r_\mathrm{D}i_{\mathrm{D,RMS}}^2
    \label{eq:p_d_con_vereinfacht}
\end{equation}

\subsubsection{Sperrverzögerungsverluste (Reverse Recovery)}
Beim Übergang der Diode vom leitenden in den sperrenden Zustand (Abschalten) kann der Stromfluss nicht augenblicklich stoppen. Um die im pn-Übergang gespeicherte Ladung $Q_{\mathrm{rr}}$ abzubauen, fließt für kurze Zeit ein negativer Sperrverzögerungsstrom. 

Da in diesem Moment die gegenüberliegende Halbbrücke bereits einschaltet und die volle Zwischenkreisspannung $v_\mathrm{i}$ anliegt, entsteht eine ausgeprägte Verlustleistungsspitze. Theoretisch berechnen sich diese Reverse-Recovery-Verluste ($P_{\mathrm{rr}}$) der Diode näherungsweise zu:

\begin{equation}
    P_{\mathrm{rr}} = \frac{1}{2} v_{\mathrm{i}} \cdot  I_{\mathrm{RM}} \cdot \frac{1}{2}\cdot t_\mathrm{rr} \cdot f_{\mathrm{SW}}
    \label{eq:p_rr}
\end{equation}

In der praktischen Anwendung von Niederspannungsumrichtern wird diese Gleichung jedoch selten angewandt. Obwohl die Ladung $Q_{\mathrm{rr}}$ maßgeblich von der Diode verursacht wird, dissipiert die resultierende Verlustleistung nahezu vollständig in Form der bereits erwähnten Einschaltenergie $E_{\mathrm{MOS,on,rr}}$ im gegenüberliegenden, aktiven MOSFET. Die eigenen, internen Schaltverluste der Diode können daher für die thermische Dimensionierung vernachlässigt werden \cite[S.~10]{Infineon_MOSFET_Losses}.
Sperrverluste durch Leckströme sowie Vorwärtsverzögerungsverluste (Forward Recovery) sind in Niederspannungsanwendungen technisch irrelevant und fließen nicht in die weitere Auslegung ein.
