plauer03/T3_3200/flyleaf/deckblatt.tex

\begin{titlepage}
  \centering

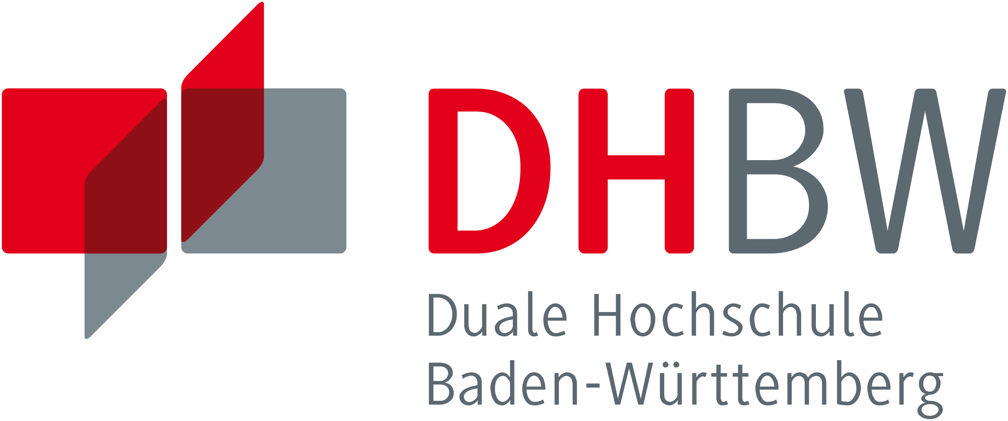
[picture p1: flyleaf/dhbw_logo.png]
  

  \vspace{1.5cm}

  % Titel (zweizeilig möglich)
  {\LARGE\bfseries \titel \par}
  \vspace{0.6cm}
  {\large \projektart \par}

  \vspace{2.0cm}

  % Studiengang und Beschreibung
  {\large des Studiengangs \studiengang \par}
  {\large an der \hochschule \par}

  \vspace{1.5cm}

  % Autor
  {\large von \par}
  {\large \autor \par}

  \vspace{6.5cm}

  % Metadaten in einer Tabelle
  \begin{tabular}{@{}p{0.5\textwidth} p{0.35\textwidth}@{}}
    \textbf{Abgabedatum:} & \abgabedatum \\
    \textbf{Bearbeitungszeitraum:} & \bearbeitungszeitraum \\
    \textbf{Matrikelnummer, Kurs:} & \matrikel, \kurs \\
    \textbf{Dualer Partner:} & \firma \\ & \firmaadresse \\
    %\textbf{Betreuer des Dualen Partners:} & \betreuerfirma \\
    \textbf{Betreuer der Dualen Hochschule:} & \betreuerfirma \\
    %\textbf{Gutachter der Dualen Hochschule:} & \gutachterdh \\
  \end{tabular}
\end{titlepage}
