plauer03/T3_3200/appendix/schaltplan.tex

\section{Gesamtschaltplan}
\label{app:schaltplan_gesamt}

Die folgenden Seiten dokumentieren den vollständigen hardwareseitigen Entwurf des BLDC-Motorcontrollers, erstellt in KiCad 9.0.7.

% --- Seite 1: Direkt unter dem Text ---
\begin{figure}[ht!]
    \centering
    
    \caption{KiCad Schaltplan: Spannungsversorgung und Block-Übersicht}
\end{figure}

\clearpage % Erzwingt neue Seite für den nächsten Plan

% --- Seite 2 ---
\begin{figure}[p]
    \centering
    
    \label{fig:schaltplan-page2}
    \caption{KiCad Schaltplan: STM32 NUCLEO und IR2104 Gate-Treiber}
\end{figure}

\clearpage

% --- Seite 3 ---
\begin{figure}[p]
    \centering
    
    \label{fig:schaltplan-page3}
    \caption{KiCad Schaltplan: B6-Inverterbrücke und INA181 Shunt-Messung}
\end{figure}
