plauer03/T3_3200/chapters/01_einleitung.tex

\chapter{Einleitung}
\label{chap:einleitung}

Die vorliegende Studienarbeit behandelt die methodische Entwicklung eines leistungselektronischen Motorcontrollers zur Ansteuerung eines bürstenlosen Gleichstrommotors (BLDC) im Niederspannungsbereich. Ziel ist die hardwareseitige Realisierung und Validierung einer dreiphasigen Leistungsendstufe für eine nominale Betriebsspannung von $36\,\mathrm{V}$ und einen Dauerstrom von bis zu $30\,\mathrm{A}$. Im Mittelpunkt stehen dabei die Auswahl der Leistungshalbleiter, die Dimensionierung der Treiberstufen sowie die detaillierte Analyse elektrischer Verlustmechanismen und thermischer Randbedingungen. Da hohe Stromanstiege, schnelle Schaltvorgänge und dynamische Lastwechsel zu massiven elektrischen und thermischen Belastungen führen, erfordert die Entwicklung ein fundiertes Verständnis der maschinen- und leistungselektronischen Zusammenhänge. Neben der rein elektrischen Dimensionierung spielen parasitäre Effekte und die Wärmeabfuhr eine zentrale Rolle, um einen robusten und reproduzierbaren Prototyp zu realisieren, der unter realistischen Betriebsbedingungen zuverlässig arbeitet.

\section{Motivation}

Elektrische Antriebssysteme gewinnen sowohl im industriellen Umfeld als auch in mobilen Anwendungen zunehmend an Bedeutung, wobei sich bürstenlose Gleichstrommotoren durch ihre hohe Leistungsdichte, geringe Wartungsanforderungen und gute Regelbarkeit auszeichnen. Mit steigenden Leistungsanforderungen wachsen jedoch auch die Ansprüche an die zugehörige Leistungselektronik, da steile Schaltflanken und hohe Transienten zu elektromagnetischen Störungen und zusätzlichen Schalt- sowie Leitverlusten in den Halbleitern führen. Unzureichend dimensionierte Bauteile oder eine ungünstige Signalführung können hierbei schnell zu Instabilitäten, thermischer Überlastung oder im Extremfall zum Bauteilversagen führen. Zwar sind kommerzielle Motorcontroller am Markt breit verfügbar, diese bieten jedoch häufig nur eingeschränkte Transparenz hinsichtlich ihrer exakten Auslegung oder sind stark auf spezifische Nischenanwendungen optimiert. Eine eigenständige Entwicklung von Grund auf ermöglicht es stattdessen, die leistungselektronischen Zusammenhänge systematisch zu analysieren und alle relevanten Parameter, insbesondere im Hinblick auf hohe Anlaufströme und schnelle Lastwechsel, gezielt auf die vorgegebenen Betriebsbedingungen abzustimmen.

\section{Zielsetzung}

Das primäre Ziel dieser Arbeit ist die ganzheitliche Auslegung und prototypische Inbetriebnahme eines diskreten BLDC-Motorcontrollers. Der Fokus liegt auf dem Aufbau der Leistungselektronik unter Verwendung dedizierter N-Kanal-MOSFETs, robuster Halbbrückentreiber sowie eines 32-Bit-Mikrocontrollers zur Steuerungsebene. Dabei soll die dreiphasige B6-Brückentopologie hinsichtlich ihrer elektrischen Belastbarkeit, der auftretenden Verlustleistungen und der thermischen Stabilität tiefgehend analytisch dimensioniert werden. Im Rahmen der Entwicklung werden das Betriebsverhalten der Leistungshalbleiter bewertet und auf Basis der berechneten Leit- und Schaltverluste ein geeignetes Kühlkonzept erarbeitet. Ziel ist es, die theoretischen Auslegungen abschließend an einem funktionsfähigen Lochraster-Prototyp messtechnisch zu validieren, um das transiente Schaltverhalten sowie die thermische Erwärmung zu evaluieren und daraus konkrete Anforderungen für ein zukünftiges professionelles Leiterplattendesign abzuleiten.

\section{Abgrenzung}

Der wissenschaftliche Schwerpunkt dieser Studienarbeit liegt vollumfänglich auf der hardwareseitigen Auslegung und der thermischen Beherrschung des Motorcontrollers. Die Ansteuerung des BLDC-Motors erfolgt auf Basis einer robusten, sensorgestützten Blockkommutierung unter Verwendung von drei Hall-Sensoren. Auf algorithmisch komplexe Modulationsverfahren wie die Raumzeigermodulation oder eine feldorientierte Regelung wird bewusst verzichtet, da die Aufrechterhaltung der Systemstabilität der diskreten Hardware bei hochdynamischen Schaltvorgängen im Vordergrund steht. Softwareseitige Implementierungen und komplexe Regelkreise zur Drehmoment- oder Drehzahlregelung werden dementsprechend nur insoweit behandelt, wie sie für das grundlegende elektrotechnische Systemverständnis und die Implementierung von Schutzfunktionen (Fail-Safe) zwingend erforderlich sind. Der Fokus ruht stattdessen auf der leistungselektronischen Netzwerktopologie, der physikalischen Auslegung der Schaltelemente, der analytischen Verlustleistungsbilanzierung sowie der thermischen Konzeption.

\section{Aufbau der Arbeit}

Die vorliegende Arbeit gliedert sich in sechs aufeinander aufbauende Hauptkapitel. Nach der Einleitung werden in Kapitel 2 die theoretischen Grundlagen bürstenloser Gleichstrommotoren sowie das Prinzip der sensorgestützten Blockkommutierung erläutert. Kapitel 3 widmet sich der Systemarchitektur und beschreibt das Softwarekonzept des verwendeten STM32-Mikrocontrollers, einschließlich der Phasenansteuerung und der implementierten Schutzmechanismen. In Kapitel 4 erfolgt die Kernarbeit der hardwareseitigen Dimensionierung. Hier werden der Zwischenkreis, die Gate-Treiber sowie die Leistungs-MOSFETs ausgelegt und einer detaillierten Verlustrechnung unterzogen. Auf Basis dieser Leistungsergebnisse wird in Kapitel 5 das thermische Management des Controllers erarbeitet und ein geeignetes aktives Kühlkonzept spezifiziert. Kapitel 6 dokumentiert den prototypischen Hardwareaufbau und evaluiert das System anhand von Oszilloskopmessungen des transienten Schaltverhaltens sowie durch thermische Dauertests im Leerlauf. Die Arbeit schließt in Kapitel 7 mit einem Fazit, welches die gewonnenen Erkenntnisse zusammenfasst und einen Ausblick auf die notwendige Überführung in ein optimiertes Leiterplattendesign gibt.
