plauer03/T3_3200/chapters/03_anforderungen.tex

\chapter{Anforderungen und Systemkonzept}
\label{chap:anforderungen}

Dieses Kapitel definiert die technischen Spezifikationen und beschreibt das übergeordnete Systemkonzept des Motorcontrollers. Aus den Randbedingungen des Antriebsstrangs werden die elektrischen und thermischen Anforderungen abgeleitet. Diese bilden die verbindliche Grundlage für die in Kapitel \ref{chap:entwurf_leistung} folgende Komponentenauswahl und Verlustleistungsberechnung. Abschließend werden die gewählte Hardwarearchitektur sowie das interruptbasierte Softwarekonzept vorgestellt.

% ============================================================
\section{Elektrische und thermische Anforderungen}
\label{sec:anforderungen_spezifikationen}

Das Antriebssystem basiert auf zwei bürstenlosen Gleichstrommotoren mit einer mechanischen Nennleistung von jeweils $400\,\mathrm{W}$. Die Energieversorgung erfolgt über einen Lithium-Ionen-Akkumulator (10S-Konfiguration) mit einer Nominalspannung von $36\,\mathrm{V}$, einer Ladeschlussspannung von $42\,\mathrm{V}$ und einer Kapazität von $4{,}4\,\mathrm{Ah}$. Aus diesen mechanischen und physikalischen Randbedingungen lassen sich die Anforderungen an die Leistungselektronik ableiten.

\subsection{Spannungs- und Stromdimensionierung}
Während des Betriebs können durch induktive Lastwechsel und parasitäre Leitungsinduktivitäten kurzzeitige Überspannungen auftreten. Ein weiterer relevanter Effekt ist der Spannungsanstieg im Zwischenkreis während generatorischer Betriebszustände (rekuperatives Bremsen). Um einen sicheren Betrieb im Vierquadrantenbetrieb zu gewährleisten, müssen alle leistungstragenden Komponenten (MOSFETs, Kondensatoren) für eine Spannungsfestigkeit von mindestens $60\,\mathrm{V}$ ausgelegt werden. Aus Gründen der Bauteilzuverlässigkeit wird eine Auslegungsreserve auf $80\,\mathrm{V}$ angestrebt.
Bei einer Nennleistung von $400\,\mathrm{W}$ und $36\,\mathrm{V}$ ergibt sich im stationären Betrieb ein mittlerer Strom von etwa $11{,}1\,\mathrm{A}$ pro Motor. Um einen kraftvollen Anlauf aus dem Stillstand zu garantieren, wird die Endstufe für einen transienten, äquivalent sinusförmigen Phasen-Effektivstrom von $30\,\mathrm{A_{RMS}}$ dimensioniert, woraus für die verwendete Blockkommutierung konservativ ein zulässiger Block-Spitzenstrom von $42{,}4\,\mathrm{A}$ entspricht. Um das System vor den in Abschnitt \ref{subsec:stromerfassung} beschriebenen Überströmen zu schützen, ist eine hardwarenahe Strombegrenzung (Cycle-by-Cycle Current Limiting) zwingend erforderlich, welche den Maximalstrom strikt auf diese $42{,}4\,\mathrm{A}$ limitiert und die Obergrenze für die Safe Operating Area (SOA) bildet.

\subsection{Thermische Randbedingungen}
Die thermische Dimensionierung stellt eine der größten Herausforderungen beim Entwurf kompakter Motorcontroller dar. Das System muss in der Lage sein, die bei $42{,}4\,\mathrm{A}$ entstehenden Halbleiterverluste zuverlässig abzuführen. Als Randbedingung wird ein passives Kühlkonzept (Aluminium-Kühlkörper ohne erzwungene Konvektion) bei einer maximalen Umgebungstemperatur von $40\,^\circ\mathrm{C}$ definiert. 
Obwohl moderne Silizium-Leistungs-MOSFETs Sperrschichttemperaturen von bis zu $175\,^\circ\mathrm{C}$ tolerieren, wird die maximale Arbeitstemperatur der Halbleiter ($T_\mathrm{J}$) für die theoretischen Berechnungen konservativ auf $100\,^\circ\mathrm{C}$ limitiert. Diese thermische Reserve begrenzt den temperaturbedingten Anstieg des Einschaltwiderstands $R_{\mathrm{DS(on)}}$ und schwächt die positive thermische Rückkopplung, wodurch das Risiko eines thermischen Durchgehens (Thermal Runaway) ausgeschlossen wird.

\subsection{Schaltfrequenz}
Zur Vermeidung wahrnehmbarer akustischer Emissionen des Motors sowie zur Reduktion der Stromwelligkeit wird die PWM-Schaltfrequenz knapp oberhalb der menschlichen Hörschwelle auf $20\,\mathrm{kHz}$ festgelegt. Eine höhere Frequenz würde zwar den Stromrippel in den Motorinduktivitäten weiter glätten, gleichzeitig aber die dynamischen Schaltverluste in der Endstufe massiv erhöhen.
Zur besseren Übersicht sind alle abgeleiteten Systemanforderungen in Tabelle \ref{tab:anforderungen} zusammengefasst.

\begin{table}[htbp]
\centering
\caption{Zusammenfassung der elektrischen und thermischen Systemanforderungen.}
\label{tab:anforderungen}
\begin{tabular}{llll}
\toprule
\textbf{Parameter} & \textbf{Symbol} & \textbf{Wert} & \textbf{Einheit} \\
\midrule
Nominale Akkumulatorspannung & $V_{\mathrm{bat,nom}}$ & 36 & V \\
Maximale Ladeschlussspannung & $V_{\mathrm{bat,max}}$ & 42 & V \\
Geforderte Spannungsfestigkeit & $V_{\mathrm{DS,max}}$ & $\ge 60$ & V \\
Maximales aktives Stromlimit & $I_{\mathrm{Block,max}}$ & 42,4 & A) \\
PWM-Schaltfrequenz & $f_{\mathrm{sw}}$ & 20 & kHz \\
Logikpegel des Mikrocontrollers & $V_{\mathrm{logic}}$ & 3,3 & V \\
Max. zulässige Umgebungstemperatur & $T_{\mathrm{A}}$ & 40 & $^\circ$C \\
Thermische Auslegungsgrenze & $T_{\mathrm{J,design}}$ & 100 & $^\circ$C \\
\bottomrule
\end{tabular}
\end{table}

% ============================================================
\section{Systemarchitektur und Signalfluss}
\label{sec:systemarchitektur}

Um die abgeleiteten Anforderungen umzusetzen, wird der Motorcontroller in eine modulare Hardwarearchitektur gegliedert. Das Gesamtsystem besteht aus drei funktionalen Hauptblöcken: der digitalen Steuerungseinheit, der analogen Treiberstufe und dem Leistungsteil mit integrierter Strommessung. Abbildung \ref{fig:blockschaltbild} veranschaulicht das Blockdiagramm sowie den Signalfluss des Motorcontrollers.

\begin{figure}[htbp]
    \centering
    \resizebox{\textwidth}{!}{
    \begin{tikzpicture}[
        >=stealth,
        font=\sffamily\small,
        mainblock/.style={draw=black!80, fill=black!4, thick, rectangle, minimum height=3.2cm, minimum width=2.4cm, align=center, rounded corners=2pt},
        smallblock/.style={draw=black!80, fill=white, thick, rectangle, minimum height=1.0cm, minimum width=2.2cm, align=center, rounded corners=2pt},
        motorblock/.style={draw=black!80, fill=black!10, thick, circle, minimum size=2.0cm, align=center},
        signal/.style={->, thick, draw=black!70},
        power/.style={->, very thick, draw=black}
    ]

    % Eingänge (Links)
    \node[smallblock] (throttle) at (0, 0) {\textbf{Gaspedal}};
    \node[smallblock] (battery)  at (0, 3.2) {\textbf{Akkumulator} \\ 36 V};
    
    % DC/DC Versorgung
    \node[smallblock] (dcdc) at (3.2, 3.2) {\textbf{DC/DC} \\ 12 V \& 3,3 V};

    % Hauptblöcke (Mitte bis Rechts)
    \node[mainblock] (mcu) at (3.2, 0) {\textbf{STM32} \\[0.8em] 6-Step Logik \\ PWM \& ADC};
    
    \node[mainblock] (driver) at (7.0, 0) {\textbf{3x IR2104} \\[0.8em] Treiber \\ Totzeit};
    
    \node[mainblock] (inverter) at (11.0, 0) {\textbf{B6-Brücke} \\[0.8em] IPP034N08N5};

    % Strommessung (Shunt)
    \node[smallblock] (shunt) at (7.0, -2.5) {\textbf{Shunt \& OpAmp}};

    % Aktor (Ganz rechts)
    \node[motorblock] (motor) at (14.5, 0) {\textbf{BLDC}};

    % --- Leistungs- und Versorgungsleitungen ---
    \draw[power] (battery.east) -- (dcdc.west);
    \draw[power] (battery.north) |- (0, 4.2) -| (inverter.north) node[pos=0.25, above, font=\scriptsize] {Zwischenkreis ($V_{\mathrm{DC}} = 36\,\mathrm{V}$)};
    
    % Phasen zum Motor
    \draw[power] ([yshift=0.4cm]inverter.east) -- ([yshift=0.4cm]motor.west) node[midway, above, yshift=-2pt, font=\scriptsize] {U};
    \draw[power] ([yshift=0cm]inverter.east) -- ([yshift=0cm]motor.west) node[midway, above, yshift=-2pt, font=\scriptsize] {V};
    \draw[power] ([yshift=-0.4cm]inverter.east) -- ([yshift=-0.4cm]motor.west) node[midway, above, yshift=-2pt, font=\scriptsize] {W};

    % GND Pfad über Shunt
    \draw[power] (inverter.south) |- (shunt.east) node[near start, right, font=\scriptsize] {Rückstrom};

    % --- Signalleitungen ---
    \draw[signal] (dcdc.south) -- (mcu.north) node[midway, right, font=\scriptsize] {3,3 V};
    \draw[signal] (dcdc.east) -| (driver.north) node[near start, above, font=\scriptsize] {12 V ($V_{\mathrm{CC}}$)};
    \draw[signal] (throttle.east) -- (mcu.west) node[midway, above, font=\scriptsize] {Soll};

    % MCU zu Driver
    \draw[signal] ([yshift=0.8cm]mcu.east) -- ([yshift=0.8cm]driver.west) node[midway, above, font=\scriptsize] {PWM (IN)};
    \draw[signal] ([yshift=-0.8cm]mcu.east) -- ([yshift=-0.8cm]driver.west) node[midway, above, font=\scriptsize] {EN ($\overline{\mathrm{SD}}$)};

    % Driver zu Inverter
    \draw[signal] ([yshift=1.0cm]driver.east) -- ([yshift=1.0cm]inverter.west) node[midway, above, font=\scriptsize] {HO};
    \draw[signal] ([yshift=0cm]driver.east) -- ([yshift=0cm]inverter.west) node[midway, above, font=\scriptsize] {LO};
    \draw[signal, dashed] ([yshift=-1.0cm]inverter.west) -- ([yshift=-1.0cm]driver.east) node[midway, below, font=\scriptsize] {VS};

    % Shunt zu MCU (ADC)
    \draw[signal] (shunt.west) -| ([xshift=0.5cm]mcu.south) node[near end, right, font=\scriptsize] {ADC};

    % --- Feedback ---
    \draw[signal] (motor.south) |- (14.5, -3.8) -| ([xshift=-0.5cm]mcu.south) node[pos=0.25, above, font=\scriptsize] {Hall-Sensoren ($\mathrm{H_1}, \mathrm{H_2}, \mathrm{H_3}$)};

    \end{tikzpicture}
    }
    \caption{Systemarchitektur und Signalfluss des Motorcontrollers.}
    \label{fig:blockschaltbild}
\end{figure}

Die Steuerungsebene wird durch einen STM32-Mikrocontroller abgebildet. Die Firmware wertet die diskreten Signale der Hall-Sensoren aus und generiert die hochfrequenten PWM-Signale. Gleichzeitig überwacht der integrierte Analog-Digital-Wandler (ADC) den Spannungsabfall an einem Low-Side-Shunt, welcher über einen Operationsverstärker aufbereitet wird, um den Phasenstrom zu regeln.
Der Gleichspannungszwischenkreis wird durch Elektrolytkondensatoren realisiert und puffert die hochfrequenten Rippleströme des Inverters, um den Akkumulator vor transienten Stromspitzen zu schützen.

% ============================================================
\section{Softwarearchitektur und Zustandsautomat}
\label{sec:softwarekonzept}

Während die Hardware die physikalischen Leistungsgrenzen definiert, bestimmt die Architektur der Firmware die dynamische Reaktionsfähigkeit des Antriebs. Zur echtzeitfähigen Umsetzung der Blockkommutierung und der Systemüberwachung ist die Steuerungssoftware als deterministischer, strikt ereignisgesteuerter Zustandsautomat ausgeführt. Der Fokus liegt dabei auf minimalen Latenzen, hoher zeitlicher Deterministik sowie einem definierten Fail-Safe-Verhalten.
Die Architektur gliedert sich primär in zwei parallel ablaufende, hochpriorisierte Hardware-Interrupts: die asynchrone Rotorlageerfassung (Position Control) und die synchrone Stromüberwachung (Current Control). Beide Routinen sind so ausgelegt, dass sie unabhängig voneinander arbeiten, jedoch über gemeinsam genutzte Zustandsgrößen implizit gekoppelt sind. Die Priorisierung der Interrupts stellt sicher, dass zeitkritische Kommutierungsvorgänge stets deterministisch ausgeführt werden, während die Strombegrenzung als überlagerte Schutzfunktion wirkt.
Das funktionale Zusammenspiel dieser beiden Kernprozesse ist im Flussdiagramm in Abbildung \ref{fig:software_flowchart} detailliert dargestellt und wird im Folgenden erläutert.

\begin{figure}[htbp]
    \centering
    
    % --- Linker Subplot: Kommutierung ---
    \begin{subfigure}[t]{0.48\textwidth}
        \centering
        \begin{tikzpicture}[
            >=stealth,
            font=\sffamily\scriptsize,
            node distance=1.3cm,
            block/.style={draw=black!80, rectangle, fill=white, thick, minimum width=3.8cm, minimum height=0.7cm, align=center, rounded corners=1pt},
            decision/.style={draw=black!80, diamond, fill=white, thick, aspect=2, align=center, inner sep=2pt},
            terminator/.style={draw=black!80, rounded corners=6pt, fill=black!10, thick, minimum width=3.8cm, minimum height=0.7cm, align=center},
            line/.style={->, thick, draw=black!80}
        ]

        \node[terminator] (start) {EXTI Interrupt (Hall)};
        \node[block, below of=start] (read) {Read Hall Sensors};
        \node[block, below of=read] (state) {Compute Hall State (3-bit)};
        \node[decision, below of=state, yshift=-0.2cm] (valid) {Valid\\State?};

        \node[block, below of=valid, yshift=-0.4cm] (dir) {Apply Direction\\(Forward / Reverse)};
        \node[block, below of=dir] (lut) {LUT Mapping\\(Sector)};
        \node[block, below of=lut] (pwm) {Update CCR Registers\\(PWM Output)};
        \node[terminator, below of=pwm] (end) {Exit ISR};
        
        \node[block, right of=valid, xshift=2.4cm, text width=1.6cm] (error) {Emergency\\Stop};

        \draw[line] (start) -- (read);
        \draw[line] (read) -- (state);
        \draw[line] (state) -- (valid);
        \draw[line] (valid) -- node[left]{Yes} (dir);
        \draw[line] (valid) -- node[above]{No} (error);
        \draw[line] (error) |- (end);
        \draw[line] (dir) -- (lut);
        \draw[line] (lut) -- (pwm);
        \draw[line] (pwm) -- (end);

        \end{tikzpicture}
        \caption{Position Control (Asynchron)}
        \label{fig:flowchart_exti}
    \end{subfigure}
    \hfill
    % --- Rechter Subplot: Strombegrenzung ---
    \begin{subfigure}[t]{0.48\textwidth}
        \centering
        \begin{tikzpicture}[
            >=stealth,
            font=\sffamily\scriptsize,
            node distance=1.3cm,
            block/.style={draw=black!80, rectangle, fill=white, thick, minimum width=3.8cm, minimum height=0.7cm, align=center, rounded corners=1pt},
            decision/.style={draw=black!80, diamond, fill=white, thick, aspect=2, align=center, inner sep=2pt},
            terminator/.style={draw=black!80, rounded corners=6pt, fill=black!10, thick, minimum width=3.8cm, minimum height=0.7cm, align=center},
            line/.style={->, thick, draw=black!80},
            dashedline/.style={->, thick, dashed, draw=black!60}
        ]

        \node[terminator] (start) {ADC Watchdog Interrupt};
        \node[block, below of=start] (read) {Read Current (Shunt)};
        \node[decision, below of=read, yshift=-0.5cm] (check) {$I_{\mathrm{phase}} > I_{\mathrm{max}}$?};
        \node[block, below of=check, yshift=-0.5cm] (limit) {Limit PWM Duty Cycle\\(Override CCR)};
        \node[terminator, below of=limit, yshift=-0.2cm] (end) {Exit ISR};

        \draw[line] (start) -- (read);
        \draw[line] (read) -- (check);
        \draw[line] (check) -- node[left]{Yes} (limit);
        \draw[line] (limit) -- (end);
        
        % No path
        \draw[line] (check) -- node[above]{No} (2.8, -3.1) |- (end);

        \end{tikzpicture}
        \caption{Current Control (Synchron)}
        \label{fig:flowchart_adc}
    \end{subfigure}

    \caption{Architektur der ISR mit Kommutierungslogik und Strombegrenzung.}
    \label{fig:software_flowchart}
\end{figure}

\subsection{Ereignisgesteuerte Kommutierung}
Die Erfassung der absoluten Rotorlage sowie die physikalische Umschaltung der Phasen erfolgen ausnahmslos innerhalb der Interrupt-Service-Routine (ISR) der externen Interrupts (Abbildung \ref{fig:flowchart_exti}). Die drei Hall-Sensoren sind an dedizierte GPIO-Pins angebunden, die bei jeder detektierten Signalflanke den Mikrocontroller unterbrechen. Dadurch ergibt sich eine strikt ereignisgetriebene Verarbeitung ohne zyklisches Polling, was die Reaktionszeit minimiert und die CPU-Last reduziert.
Innerhalb dieser ISR werden die Signalzustände eingelesen und mittels bitweiser Kodierung zu einem Zustandsvektor zusammengefasst. Dieser Vektor korrespondiert über eine zeiteffiziente Lookup Table (LUT) eindeutig mit dem aktuellen physikalischen Sektor des Motors. Die Verwendung einer LUT ermöglicht einen Zugriff in konstanter Zeit ohne zusätzliche Berechnungen und trägt somit wesentlich zur deterministischen Laufzeit der ISR bei.
Unmittelbar im Anschluss aktualisiert die Software die Timer-Capture-Compare-Register (CCR), welche die hardwareseitige PWM-Ausgabe an die Gate-Treiber modulieren. Die gesamte ISR ist auf minimale Ausführungszeit optimiert und bewegt sich typischerweise im Mikrosekundenbereich, wodurch auch bei hohen Drehzahlen und entsprechend hoher Interruptfrequenz eine zuverlässige Kommutierung gewährleistet ist.

\subsection{Nebenläufigkeit und Interrupt-Priorisierung}
Da sowohl die Positions- als auch die Stromregelung interruptbasiert realisiert sind, ist das Verhalten bei konkurrierenden Ereignissen von zentraler Bedeutung. Die EXTI-Interrupts zur Kommutierung sind höher priorisiert als der ADC-Interrupt, um sicherzustellen, dass die korrekte Phasenumschaltung niemals durch die Stromüberwachung verzögert wird.
Im Falle simultaner Interrupt-Ereignisse wird die laufende ADC-ISR durch die EXTI-ISR unterbrochen (Preemption). Durch diese Priorisierung wird garantiert, dass keine inkonsistenten Schaltzustände entstehen. Gemeinsame Variablen, insbesondere das PWM-Tastverhältnis, sind so ausgelegt, dass sie atomar aktualisiert werden oder nur in definierten Kontexten beschrieben werden, wodurch Race Conditions vermieden werden.

\subsection{Sicherheitslogik und Notabschaltung}
Wie im Kommutierungspfad ersichtlich, beinhaltet die Softwarearchitektur eine essenzielle Plausibilitätsprüfung. Sollte durch Störeinflüsse (EMV), Sensorfehler oder einen Kabelbruch ein physikalisch unmöglicher Hall-Zustand (wie \texttt{0b000} oder \texttt{0b111}) auftreten, wird unmittelbar der Default-Case aktiviert.
In diesem Notfall werden ausnahmslos alle Gate-Treiber deaktiviert (Emergency Stop), um gefährliche Brückenkurzschlüsse im Inverter zu verhindern. Der Fehlerzustand wird dabei persistent gehalten, sodass ein automatischer Wiederanlauf ausgeschlossen ist. Eine Wiederinbetriebnahme erfordert eine explizite Rücksetzung durch die übergeordnete Steuerlogik. Dieses Fail-Safe-Konzept stellt sicher, dass auch bei transienten Fehlern kein unkontrollierter Betrieb möglich ist.

\subsection{Aktive Strombegrenzung und Rekuperation}
Zusätzlich zur reinen Kommutierung regelt ein synchroner Steuerungspfad den Phasenstrom (vgl. Abbildung \ref{fig:flowchart_adc}). Um den thermischen Worst-Case abzusichern, ist im Mikrocontroller ein an den Analog Watchdog gekoppelter ADC-Interrupt konfiguriert. Dieser überwacht kontinuierlich den Spannungsabfall über einen Shunt-Widerstand und ermöglicht so eine indirekte Strommessung.
Übersteigt der gemessene Strom den Grenzwert von $42{,}4\,\mathrm{A}$, erzwingt die Firmware in Echtzeit eine Reduktion des PWM-Tastverhältnisses. Dies führt zu einer unmittelbaren Verringerung der angelegten Phasenspannung und somit zu einer Begrenzung des Stromanstiegs. Das System verhält sich dabei wie ein nichtlinearer Stromregler, der den Phasenstrom dynamisch am Grenzwert stabilisiert.
Diese Systemarchitektur bildet gleichzeitig die Grundlage für die Rekuperation. Wird ein negatives Drehmoment gefordert, invertiert die Hauptschleife das Kommutierungsmuster. Der Motor arbeitet in diesem Betriebszustand als Generator, wobei die mechanische Energie in elektrische Energie umgewandelt und in den Zwischenkreis zurückgespeist wird. Der Inverter verhält sich dabei funktional wie ein Boost-Converter, da die induzierte Gegenspannung des Motors über die Schaltzustände angehoben und dem Versorgungssystem zugeführt wird.
Die Strombegrenzung bleibt auch im Rekuperationsbetrieb aktiv und stellt sicher, dass der Rückspeisestrom das definierte Hardware-Limit nicht überschreitet. Dadurch wird sowohl die Leistungselektronik als auch die Energiequelle vor Überlast geschützt.
