plauer03/T3_3200/flyleaf/abkuerzungen.tex

\chapter*{Abkürzungsverzeichnis}

\begin{tabular}{lp{12cm}}
\textbf{Abkürzung} & \textbf{Bedeutung} \\[1ex]
ADC & Analog-to-Digital Converter (Analog-Digital-Wandler) \\
BEMF & Back Electromotive Force (Gegen-EMK / induzierte Gegenspannung) \\
BLDC & Brushless Direct Current (bürstenloser Gleichstrommotor) \\
CCR & Capture-Compare-Register \\
CPU & Central Processing Unit (Zentrale Recheneinheit) \\
EMV & Elektromagnetische Verträglichkeit \\
ESB & Ersatzschaltbild \\
ESL & Equivalent Series Inductance (Ersatzreiheninduktivität) \\
ESR & Equivalent Series Resistance (Ersatzreihenwiderstand) \\
EXTI & External Interrupt \\
FOC & Field-Oriented Control (Feldorientierte Regelung) \\
GPIO & General Purpose Input/Output \\
GND & Ground (Massepotenzial) \\
HAL & Hardware Abstraction Layer \\
ISR & Interrupt Service Routine \\
LS / HS & Low-Side / High-Side \\
LUT & Lookup Table \\
MCU & Microcontroller Unit \\
MOSFET & Metal-Oxide-Semiconductor Field-Effect Transistor \\
PCB & Printed Circuit Board (Leiterplatte) \\
PWM & Pulse Width Modulation (Pulsweitenmodulation) \\
RMS & Root Mean Square (Effektivwert) \\
SMD & Surface-Mounted Device (Oberflächenmontiertes Bauelement) \\
SNR & Signal-to-Noise Ratio (Signal-Rausch-Verhältnis) \\
SOA & Safe Operating Area \\
SVPWM & Space Vector Pulse Width Modulation (Raumzeigermodulation) \\
\end{tabular}
