plauer03/T3_3200/flyleaf/symbol_formel.tex

\chapter*{Symbolverzeichnis}

\begin{longtable}{@{\hskip-35pt}lp{12.5cm}}
\textbf{Symbol} & \textbf{Bedeutung} \\[1ex]
\endfirsthead
\textbf{Symbol} & \textbf{Bedeutung} (Fortsetzung) \\[1ex]
\endhead
$A$ & Fläche (z.\,B. Kühlkörperoberfläche) \\
$C_{\mathrm{Boot}}$ & Kapazität des Bootstrap-Kondensators \\
$d$ & Tastverhältnis (Duty Cycle) \\
$e_{U,V,W}$ & Induzierte Gegenspannung (BEMF) der jeweiligen Phase \\
$f_{\mathrm{PWM}}$ & Schaltfrequenz der Pulsweitenmodulation \\
$G$ & Verstärkungsfaktor des Strommessverstärkers \\
$I_{\mathrm{DC}}$ & Gleichstrom im Zwischenkreis \\
$I_{\mathrm{RMS}}$ & Effektivwert des Phasenstroms \\
$k_{e}$ & Spezifische BEMF-Konstante des Motors \\
$L$ & Wicklungsinduktivität \\
$Q_{\mathrm{G}}$ & Total Gate Charge (Gesamt-Gateladung) \\
$Q_{\mathrm{rr}}$ & Sperrverzögerungsladung (Reverse Recovery) \\
$Q_{\mathrm{sw}}$ & Umschaltladung (Switching Charge) \\
$R$ & Ohmscher Wicklungswiderstand \\
$R_{\mathrm{DS(on)}}$ & Einschaltwiderstand des MOSFETs \\
$R_{\mathrm{G}}$ & Gate-Vorwiderstand \\
$r_{D}$ & Differentieller Widerstand der Diode \\
$R_{\mathrm{th,CS}}$ & Thermischer Widerstand Gehäuse zu Kühlkörper (Case-to-Sink) \\
$R_{\mathrm{th,JC}}$ & Thermischer Widerstand Sperrschicht zu Gehäuse (Junction-to-Case) \\
$R_{\mathrm{th,SA}}$ & Thermischer Widerstand Kühlkörper zu Umgebung (Sink-to-Ambient) \\
$T_{\mathrm{A}}$ & Umgebungstemperatur (Ambient) \\
$T_{\mathrm{J}}$ & Sperrschichttemperatur (Junction) \\
$T_{\mathrm{S}}$ & Kühlkörpertemperatur (Sink) \\
$t_{\mathrm{dt}}$ & Totzeit des Gate-Treibers (Deadtime) \\
$V_{\mathrm{DC}}$ & Zwischenkreis- bzw. Versorgungsspannung \\
$v_{\mathrm{GS}}$ & Gate-Source-Spannung \\
$v_{\mathrm{GS,Mi}}$ & Miller-Plateau-Spannung \\
$v_{\mathrm{GS,th}}$ & Schwellspannung (Threshold Voltage) \\
\end{longtable}
