plauer03/T3_3200/main.pdf

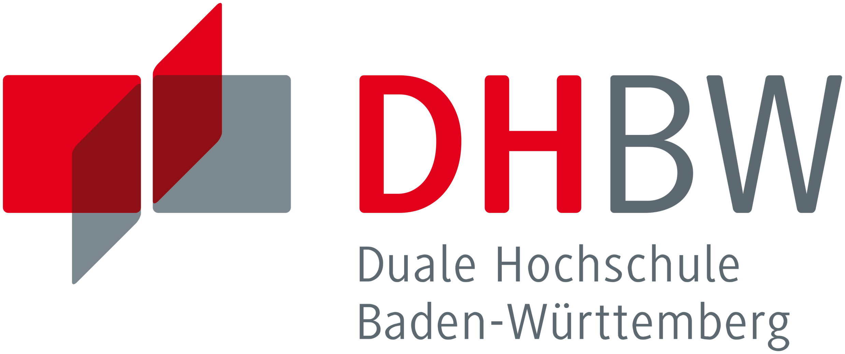
[picture p2: figure]

# Entwicklung eines BLDC-Motorcontrollers

# Studienarbeit II (T3_3200)

### des Studiengangs Elektrotechnik

### an der Dualen Hochschule Baden-Württemberg Karlsruhe

### von

### Pascal Lauer

Abgabedatum: | 09.04.2026
Bearbeitungszeitraum: | 12 Wochen
Matrikelnummer, Kurs: | 5558179, TEL23AT
Dualer Partner: | ARKU Maschinenbau GmbH
| 76532 Baden-Baden
Betreuer der Dualen Hochschule: | Prof. Dr. Markus Bell

# Eidesstattliche Erklärung

Ich versichere hiermit, dass ich meine Studienarbeit mit dem Thema: „Entwicklung eines BLDC-

Motorcontrollers“ selbstständig verfasst und keine anderen als die angegebenen Quellen und

Hilfsmittel benutzt habe.

Baden-Baden, 9. April 2026

Ort, Datum | Unterschrift

# Gender-Disclaimer

Die in der vorliegenden Arbeit verwendeten Personenbezeichnungen beziehen sich gleicherma-

ßen auf weibliche, männliche und diverse Personen. Auf eine Doppelnennung und gegenderte

Bezeichnung wird zugunsten einer besseren Lesbarkeit verzichtet.1

# KI-Disclaimer

Zur sprachlichen Überarbeitung einzelner Abschnitte wurde das Sprachmodell Gemini von

Google verwendet. Die inhaltliche Verantwortung liegt vollständig beim Verfasser. Es wurden

ausschließlich vorhandene, selbst verfasste Inhalte überarbeitet, nicht generiert.

ii

# Inhaltsverzeichnis

1 Einleitung | 1
2 Theoretische Grundlagen | 4
3 Anforderungen und Systemkonzept | 16

## iii

4 Entwurf der Leistungselektronik | 22
5 Thermische Auslegung | 34
6 Aufbau und Messungen | 38
7 Fazit und Ausblick | 46
Literatur | xi

iv

A Anhang | xii

v

# Abbildungsverzeichnis

2.1 | Querschnitt und prinzipieller Aufbau eines BLDC-Motors [1, Abb. 5b]. | . . . . | 5
2.2 | Einphasiges ESB des BLDC-Motors | | 5
2.3 | Verlauf der BEMF und der korrespondierenden Blockströme [1, Abb. 15]. . . . | 6
2.4 | Prinzipschaltbild einer B6-Brücke zur Ansteuerung des Motors. | | | 7
2.5 | Spannungs- und Stromverlauf in einer induktiv belasteten Halbbrücke | | 10
2.6 | Interne parasitäre Kapazitäten eines MOSFETs. | | | 11
2.7 | Einschaltvorgang eines MOSFETs in einer induktiv belasteten Halbbrücke. . . | 12
2.8 | Ausschaltvorgang eines MOSFETs in einer induktiv belasteten Halbbrücke. . . | 13
2.9 | Spannungs- und Stromverlauf in einer induktiv belasteten Halbbrücke | | 14
3.1 | Systemarchitektur und Signalfluss des Motorcontrollers. | | | 18
3.2 | Architektur der ISR mit Kommutierungslogik und Strombegrenzung. | | | 19
4.1 | Schaltplan der Strommessung mit Shunt, INA181 und RC-Tiefpass. | | | 25
4.2 | Temperaturabhängigkeit des maximalen Einschaltwiderstands. Digitalisierte
Kennlinie nach [6, Diagramm 9] | | 27
4.3 | Analytische Auswertung der Body-Dioden-Kennlinie. Digitalisierte Kennlinie
nach [6, Diagramm 12] | | 28
4.4 | Beschaltung des IR2104 mit der dimensionierten Bootstrap-Schaltung. | . . . . | 31
4.5 | Hochfrequente Entkopplung der Logik- und Treiberspannungen. | | | 33
5.1 | Stationäres thermisches ESB eines gekühlten MOSFETs. | | | 35
5.2 | Technische Darstellung des Aluminium-Rippenkühlkörpers. | | | 36
6.1 | Steckbrett-Prototyp zur softwareseitigen Validierung des BLDC-Controllers. . | 38
6.2 | Der finale Leistungsprototyp auf Basis einer Lochrasterplatine. | | | 40
6.3 | Darstellung der steigenden Schaltflanke am LS-Gate | | 41
6.4 | Gegenüberstellung der drei Kommutierungszustände am LS-Gate | | 42
6.5 | Erwärmung des Kühlkörpers beim stationären Leerlaufstrom von 450 mA. | . . | 44
A.1 | KiCad Schaltplan: Spannungsversorgung und Block-Übersicht | | xvi
A.2 | KiCad Schaltplan: STM32 NUCLEO und IR2104 Gate-Treiber | | xvii
A.3 | KiCad Schaltplan: B6-Inverterbrücke und INA181 Shunt-Messung | | xviii

vi

A.4 | Schaltflanke des LS-Gates (Phase U) zur Validierung des Miller-Plateaus und
A.5 | Aktiver Sektor (PWM mit 20 kHz) mit Synchrongleichrichtung am LS-Gate.
A.6 | Rückleiter-Betrieb mit statisch voll durchgesteuertem LS-Gate. Zeitbasis: 10 μs/div.xxiv
A.7 | Floating-Betrieb mit hardwareseitig abgeschaltetem Gate. Zeitbasis: 10 μs/div. xxv

## vii

# Tabellenverzeichnis

2.1 | Zustandstabelle der Blockkommutierungslogik in Abhängigkeit der Hall-Sensoren | 8
3.1 | Zusammenfassung der elektrischen und thermischen Systemanforderungen. . | 17
4.1 | Datenblattparameter des ausgewählten Leistungs-MOSFETs [6] | | 23
4.2 | Zusammenfassung der Verlustleistungen pro Halbbrücke | | 29
4.3 | Parameter zur Dimensionierung des Bootstrap-Kondensators | | | 31

## viii

# Abkürzungsverzeichnis

# Abkürzung Bedeutung

ADC | Analog-to-Digital Converter (Analog-Digital-Wandler)
BEMF | Back Electromotive Force (Gegen-EMK / induzierte Gegenspannung)
BLDC | Brushless Direct Current (bürstenloser Gleichstrommotor)
CCR | Capture-Compare-Register
CPU | Central Processing Unit (Zentrale Recheneinheit)
EMV | Elektromagnetische Verträglichkeit
ESB | Ersatzschaltbild
ESL | Equivalent Series Inductance (Ersatzreiheninduktivität)
ESR | Equivalent Series Resistance (Ersatzreihenwiderstand)
EXTI | External Interrupt
FOC | Field-Oriented Control (Feldorientierte Regelung)
GPIO | General Purpose Input/Output
GND | Ground (Massepotenzial)
HAL | Hardware Abstraction Layer
ISR | Interrupt Service Routine
LS / HS | Low-Side / High-Side
LUT | Lookup Table
MCU | Microcontroller Unit
MOSFET | Metal-Oxide-Semiconductor Field-Effect Transistor
PCB | Printed Circuit Board (Leiterplatte)
PWM | Pulse Width Modulation (Pulsweitenmodulation)
RMS | Root Mean Square (Effektivwert)
SMD | Surface-Mounted Device (Oberflächenmontiertes Bauelement)
SNR | Signal-to-Noise Ratio (Signal-Rausch-Verhältnis)
SOA | Safe Operating Area
SVPWM | Space Vector Pulse Width Modulation (Raumzeigermodulation)

ix

# Symbolverzeichnis

# Symbol Bedeutung

A | Fläche (z. B. Kühlkörperoberfläche)
CBoot | Kapazität des Bootstrap-Kondensators
d | Tastverhältnis (Duty Cycle)
eU ,V ,W | Induzierte Gegenspannung (BEMF) der jeweiligen Phase
fPWM | Schaltfrequenz der Pulsweitenmodulation
G | Verstärkungsfaktor des Strommessverstärkers
IDC | Gleichstrom im Zwischenkreis
IRMS | Effektivwert des Phasenstroms
ke | Spezifische BEMF-Konstante des Motors
L | Wicklungsinduktivität
QG | Total Gate Charge (Gesamt-Gateladung)
Qrr | Sperrverzögerungsladung (Reverse Recovery)
Qsw | Umschaltladung (Switching Charge)
R | Ohmscher Wicklungswiderstand
RDS(on) | Einschaltwiderstand des MOSFETs
RG | Gate-Vorwiderstand
rD | Differentieller Widerstand der Diode
Rth,CS | Thermischer Widerstand Gehäuse zu Kühlkörper (Case-to-Sink)
Rth,JC | Thermischer Widerstand Sperrschicht zu Gehäuse (Junction-to-Case)
Rth,SA | Thermischer Widerstand Kühlkörper zu Umgebung (Sink-to-Ambient)
TA | Umgebungstemperatur (Ambient)
TJ | Sperrschichttemperatur (Junction)
TS | Kühlkörpertemperatur (Sink)
tdt | Totzeit des Gate-Treibers (Deadtime)
VDC | Zwischenkreis- bzw. Versorgungsspannung
vGS | Gate-Source-Spannung
vGS,Mi | Miller-Plateau-Spannung
vGS,th | Schwellspannung (Threshold Voltage)

x

# 1 Einleitung

Die vorliegende Studienarbeit behandelt die methodische Entwicklung eines leistungselek-

tronischen Motorcontrollers zur Ansteuerung eines bürstenlosen Gleichstrommotors (BLDC)

im Niederspannungsbereich. Ziel ist die hardwareseitige Realisierung und Validierung einer

dreiphasigen Leistungsendstufe für eine nominale Betriebsspannung von 36 V und einen Dau-

erstrom von bis zu 30 A. Im Mittelpunkt stehen dabei die Auswahl der Leistungshalbleiter, die

Dimensionierung der Treiberstufen sowie die detaillierte Analyse elektrischer Verlustmecha-

nismen und thermischer Randbedingungen. Da hohe Stromanstiege, schnelle Schaltvorgänge

und dynamische Lastwechsel zu massiven elektrischen und thermischen Belastungen führen,

erfordert die Entwicklung ein fundiertes Verständnis der maschinen- und leistungselektro-

nischen Zusammenhänge. Neben der rein elektrischen Dimensionierung spielen parasitäre

Effekte und die Wärmeabfuhr eine zentrale Rolle, um einen robusten und reproduzierbaren

Prototyp zu realisieren, der unter realistischen Betriebsbedingungen zuverlässig arbeitet.

# 1.1 Motivation

Elektrische Antriebssysteme gewinnen sowohl im industriellen Umfeld als auch in mobilen

Anwendungen zunehmend an Bedeutung, wobei sich bürstenlose Gleichstrommotoren durch

ihre hohe Leistungsdichte, geringe Wartungsanforderungen und gute Regelbarkeit auszeich-

nen. Mit steigenden Leistungsanforderungen wachsen jedoch auch die Ansprüche an die

zugehörige Leistungselektronik, da steile Schaltflanken und hohe Transienten zu elektroma-

gnetischen Störungen und zusätzlichen Schalt- sowie Leitverlusten in den Halbleitern führen.

Unzureichend dimensionierte Bauteile oder eine ungünstige Signalführung können hierbei

schnell zu Instabilitäten, thermischer Überlastung oder im Extremfall zum Bauteilversagen

führen. Zwar sind kommerzielle Motorcontroller am Markt breit verfügbar, diese bieten jedoch

häufig nur eingeschränkte Transparenz hinsichtlich ihrer exakten Auslegung oder sind stark

auf spezifische Nischenanwendungen optimiert. Eine eigenständige Entwicklung von Grund

auf ermöglicht es stattdessen, die leistungselektronischen Zusammenhänge systematisch zu

analysieren und alle relevanten Parameter, insbesondere im Hinblick auf hohe Anlaufströme

und schnelle Lastwechsel, gezielt auf die vorgegebenen Betriebsbedingungen abzustimmen.

T3_3200 | Pascal Lauer | 1 Einleitung

# 1.2 Zielsetzung

Das primäre Ziel dieser Arbeit ist die ganzheitliche Auslegung und prototypische Inbetrieb-

nahme eines diskreten BLDC-Motorcontrollers. Der Fokus liegt auf dem Aufbau der Leis-

tungselektronik unter Verwendung dedizierter N-Kanal-MOSFETs, robuster Halbbrücken-

treiber sowie eines 32-Bit-Mikrocontrollers zur Steuerungsebene. Dabei soll die dreiphasige

B6-Brückentopologie hinsichtlich ihrer elektrischen Belastbarkeit, der auftretenden Verlustleis-

tungen und der thermischen Stabilität tiefgehend analytisch dimensioniert werden. Im Rahmen

der Entwicklung werden das Betriebsverhalten der Leistungshalbleiter bewertet und auf Basis

der berechneten Leit- und Schaltverluste ein geeignetes Kühlkonzept erarbeitet. Ziel ist es,

die theoretischen Auslegungen abschließend an einem funktionsfähigen Lochraster-Prototyp

messtechnisch zu validieren, um das transiente Schaltverhalten sowie die thermische Erwär-

mung zu evaluieren und daraus konkrete Anforderungen für ein zukünftiges professionelles

Leiterplattendesign abzuleiten.

# 1.3 Abgrenzung

Der wissenschaftliche Schwerpunkt dieser Studienarbeit liegt vollumfänglich auf der hardware-

seitigen Auslegung und der thermischen Beherrschung des Motorcontrollers. Die Ansteuerung

des BLDC-Motors erfolgt auf Basis einer robusten, sensorgestützten Blockkommutierung

unter Verwendung von drei Hall-Sensoren. Auf algorithmisch komplexe Modulationsverfahren

wie die Raumzeigermodulation oder eine feldorientierte Regelung wird bewusst verzichtet,

da die Aufrechterhaltung der Systemstabilität der diskreten Hardware bei hochdynamischen

Schaltvorgängen im Vordergrund steht. Softwareseitige Implementierungen und komplexe

Regelkreise zur Drehmoment- oder Drehzahlregelung werden dementsprechend nur insoweit

behandelt, wie sie für das grundlegende elektrotechnische Systemverständnis und die Im-

plementierung von Schutzfunktionen (Fail-Safe) zwingend erforderlich sind. Der Fokus ruht

stattdessen auf der leistungselektronischen Netzwerktopologie, der physikalischen Auslegung

der Schaltelemente, der analytischen Verlustleistungsbilanzierung sowie der thermischen

Konzeption.

# 1.4 Aufbau der Arbeit

Die vorliegende Arbeit gliedert sich in sechs aufeinander aufbauende Hauptkapitel. Nach

der Einleitung werden in Kapitel 2 die theoretischen Grundlagen bürstenloser Gleichstrom-

motoren sowie das Prinzip der sensorgestützten Blockkommutierung erläutert. Kapitel 3

widmet sich der Systemarchitektur und beschreibt das Softwarekonzept des verwendeten

T3_3200 | Pascal Lauer | 1 Einleitung

STM32-Mikrocontrollers, einschließlich der Phasenansteuerung und der implementierten

Schutzmechanismen. In Kapitel 4 erfolgt die Kernarbeit der hardwareseitigen Dimensionie-

rung. Hier werden der Zwischenkreis, die Gate-Treiber sowie die Leistungs-MOSFETs ausgelegt

und einer detaillierten Verlustrechnung unterzogen. Auf Basis dieser Leistungsergebnisse wird

in Kapitel 5 das thermische Management des Controllers erarbeitet und ein geeignetes aktives

Kühlkonzept spezifiziert. Kapitel 6 dokumentiert den prototypischen Hardwareaufbau und

evaluiert das System anhand von Oszilloskopmessungen des transienten Schaltverhaltens

sowie durch thermische Dauertests im Leerlauf. Die Arbeit schließt in Kapitel 7 mit einem Fazit,

welches die gewonnenen Erkenntnisse zusammenfasst und einen Ausblick auf die notwendige

Überführung in ein optimiertes Leiterplattendesign gibt.

# 2 Theoretische Grundlagen

Dieses Kapitel legt das theoretische Fundament für die Dimensionierung des Motorcontrol-

lers. Im Fokus stehen das elektromechanische Modell des BLDC-Motors, die sensorbasierte

Kommutierung sowie die leistungselektronischen Verlust- und Temperaturmodelle, welche die

hardwareseitigen Grenzen des Systems definieren. Die hier hergeleiteten Zusammenhänge

bilden die Basis für die Bauteilauswahl in Kapitel 4.

# 2.1 Grundlagen des BLDC-Motors

Der BLDC-Motor stellt eine technologische Weiterentwicklung der konventionellen Gleich-

strommaschine dar, bei der die mechanische Kommutierung durch eine elektronische Steue-

rung ersetzt wird. Im Gegensatz zu bürstenbehafteten Motoren, bei denen Kohlebürsten und

ein Kollektor für die Stromwendung sorgen, erfolgt die Ansteuerung der Statorwicklungen

hier in Abhängigkeit von der Rotorlage. Dies eliminiert den mechanischen Verschleiß und die

Funkenbildung, was zu einer höheren Zuverlässigkeit, geringerem Wartungsaufwand und einer

verbesserten thermischen Charakteristik führt, da die Verlustwärme primär im außenliegenden

Stator entsteht und effektiv abgeführt werden kann [1, S. 9].

# 2.1.1 Aufbau und physikalisches Wirkprinzip

Der mechanische Aufbau gliedert sich primär in den feststehenden Stator und den rotierenden

Rotor, wie der Querschnitt in Abbildung 2.1 schematisch veranschaulicht.

# Stator

Der Stator besteht aus geschichteten Stahlblechen (Lamellen), um Wirbelstromverluste zu

minimieren. In den Nuten des Stators sind die Wicklungen untergebracht, die meist in drei

Phasen (U , V , W) angeordnet sind. Diese Wicklungen sind im Stern verschaltet, wobei der

Sternpunkt im Motor isoliert ist und nicht nach außen herausgeführt wird.

T3_3200 | Pascal Lauer | 2 Theoretische Grundlagen

# Rotor

Der Rotor trägt die Permanentmagnete. Je nach Anordnung unterscheidet man zwischen

Innenläufern, bei denen der Rotor innerhalb des Stators dreht, und Außenläufern. Die Anzahl

der magnetischen Pole (N und S) variiert je nach Applikation, ist jedoch stets geradzahlig. Eine

höhere Polpaarzahl führt bei gleicher elektrischer Frequenz zu einer geringeren mechanischen

Drehzahl, erhöht jedoch gleichzeitig das verfügbare Drehmoment.

Das Drehmoment entsteht durch die Lorentzkraft, die auf die bestromten Leiter im Magnetfeld

wirkt. Damit eine kontinuierliche Rotation gewährleistet ist, muss das magnetische Feld des

Stators dem des Rotors stets um 90◦

vorauseilen.

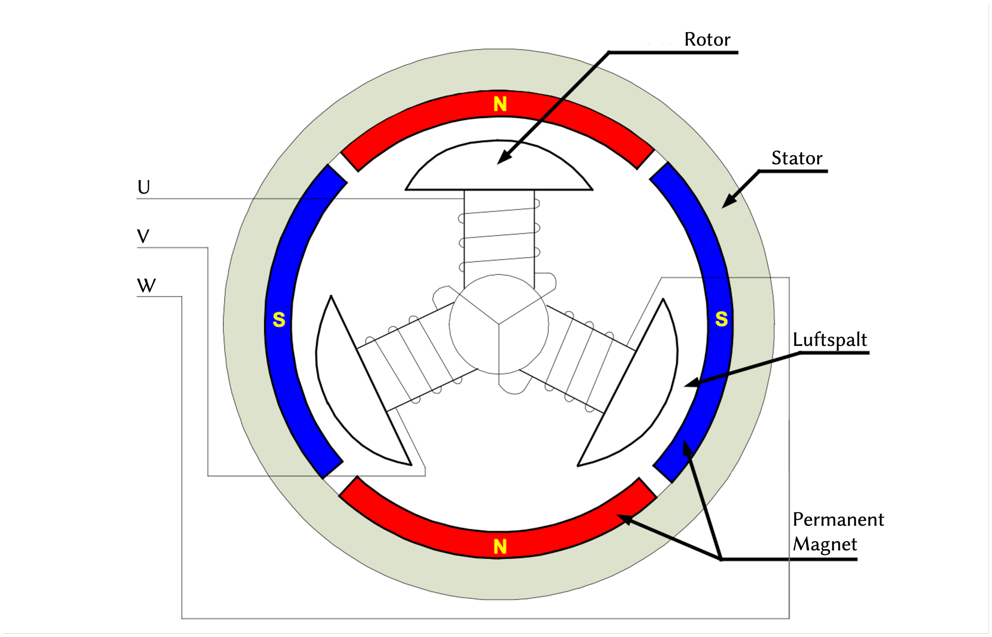
[picture p3: figure]

Abbildung 2.1: Querschnitt und prinzipieller Aufbau eines BLDC-Motors [1, Abb. 5b].

# 2.1.2 Elektrisches Ersatzmodell und BEMF

Für die steuerungstechnische Betrachtung und die Dimensionierung der Endstufe wird jede

Phase des Motors durch ein elektrisches Ersatzschaltbild (ESB) modelliert (siehe Abbildung

2.2). Dieses besteht aus einer Reihenschaltung des ohmschen Wicklungswiderstands R, der

Wicklungsinduktivität L und einer induzierten Spannungsquelle, der sogenannten Gegen-

Elektromotorischen Kraft (Back Electromotive Force, BEMF).

+ | −
R | L iU
eU

vU

Abbildung 2.2: Einphasiges ESB des BLDC-Motors.

T3_3200 | Pascal Lauer | 2 Theoretische Grundlagen

Unter Anwendung des Maschensatzes ergibt sich die Spannungsgleichung für eine einzelne

Phase (z. B. Phase U) gemäß Gleichung 2.1:

vU (t) = R ⋅ iU (t) + L ⋅

## diU (t)

dt | + eU (t) | (2.1)

Hierbei ist vU die anliegende Klemmenspannung, iU der Phasenstrom und eU die induzierte

Gegenspannung. Die motor-spezifischen Parameter definieren dabei maßgeblich das elektri-

sche Verhalten: Der Wicklungswiderstand R determiniert die ohmschen Verluste, während

die Induktivität L die Stromanstiegsgeschwindigkeit begrenzt und den hochfrequenten PWM-

Ripple glättet. Die BEMF eU begrenzt hingegen die erreichbare Maximaldrehzahl, da bei einem

Erreichen der Versorgungsspannung kein Strom mehr in den Motor eingeprägt werden kann.

Die BEMF entsteht durch die Rotation des magnetischen Rotorfeldes relativ zu den Stator-

wicklungen (Induktionsgesetz). In Anlehnung an [2] kann die Gegenspannung allgemein

beschrieben werden durch:

eU (t) = ke

⋅ ωm ⋅ f (θe) | (2.2)

Dabei ist ke die spezifische BEMF-Konstante des Motors. Charakteristisch für BLDC-Motoren

ist der trapezförmige Verlauf der Funktion f (θe), resultierend aus der Form des magnetischen

Flusses im Luftspalt. Um ein konstantes Drehmoment zu erzeugen, sollte der Phasenstrom

idealerweise als 120◦

-Block eingeprägt werden, sodass er exakt mit dem flachen Dach der

trapezförmigen BEMF korrespondiert (vgl. Abbildung 2.3).

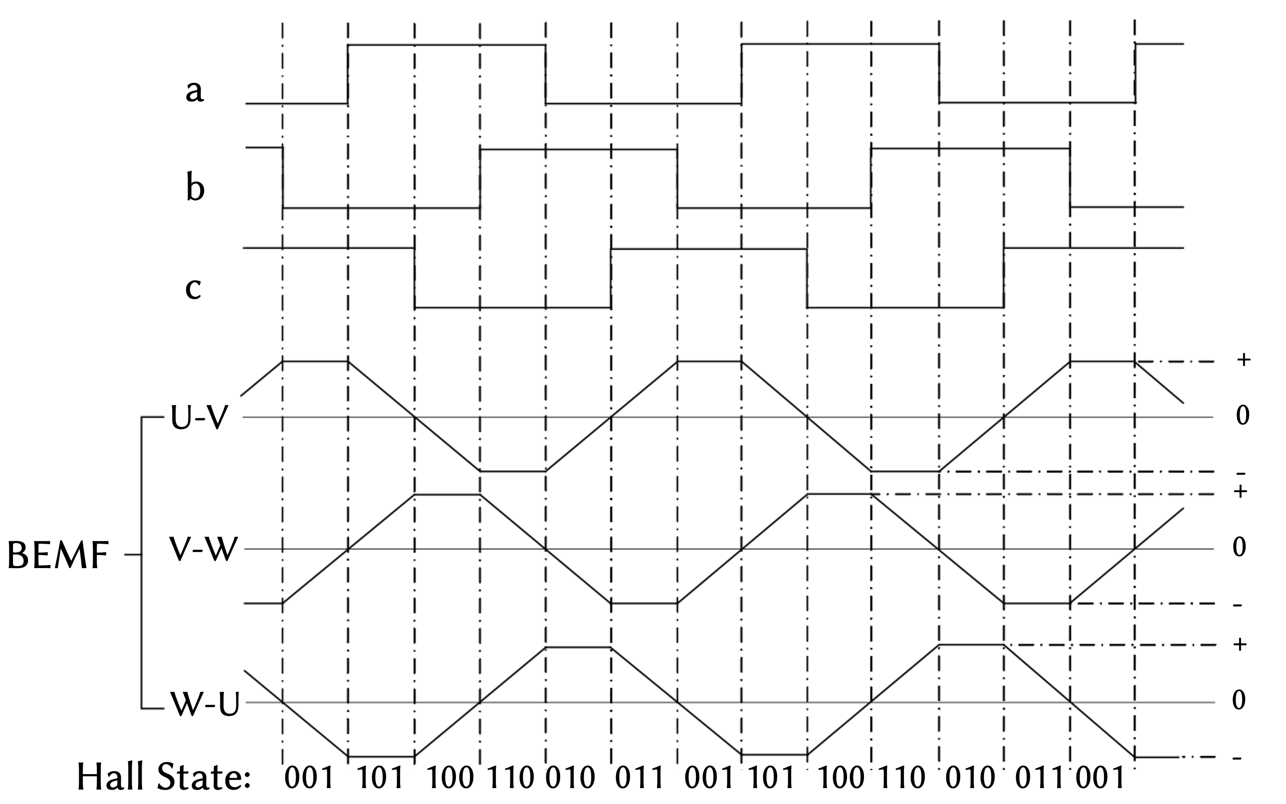
[picture p4: figure]

Abbildung 2.3: Verlauf der BEMF und der korrespondierenden Blockströme [1, Abb. 15].

T3_3200 | Pascal Lauer | 2 Theoretische Grundlagen

# 2.2 Kommutierung und Ansteuerung

Damit der Motor ein kontinuierliches Drehmoment erzeugt, müssen die Statorwicklungen

synchron zur aktuellen Rotorposition bestromt werden. Ziel der Kommutierung ist es, den

Winkel zwischen dem Erregerfeld des Rotors und dem Statorfeld im Bereich von 90◦

elektrisch

zu halten, da hierbei die maximale Lorentzkraft wirkt.

# 2.2.1 Brückentopologie und Bootstrap-Prinzip

Die leistungselektronische Umsetzung der Kommutierung erfolgt über eine dreiphasige Wech-

selrichterbrücke (B6-Brücke). Das Prinzipschaltbild ist in Abbildung 2.4 dargestellt. Die Schal-

tung besteht aus drei parallel am Gleichspannungszwischenkreis (VDC) liegenden Halbbrücken,

welche die Phasen an die Versorgungsspannung (High-Side) oder an das Bezugspotential

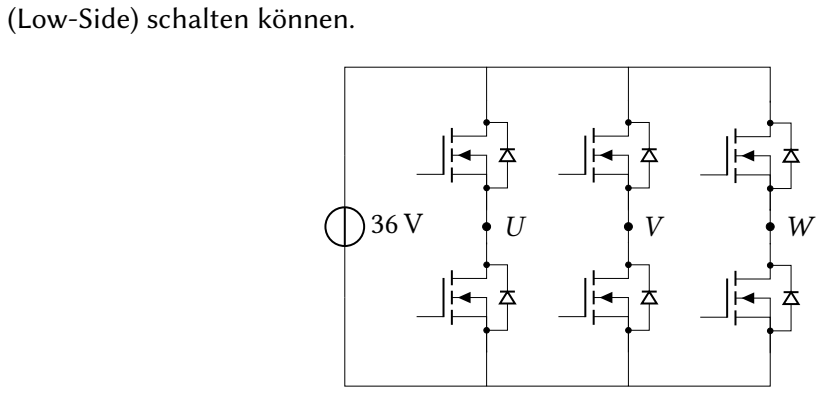
[picture p5: figure]
(Low-Side) schalten können.

Abbildung 2.4: Prinzipschaltbild einer B6-Brücke zur Ansteuerung des Motors.

In der vorliegenden Niederspannungsanwendung werden aus Effizienzgründen ausschließlich

N-Kanal-MOSFETs eingesetzt. Da der High-Side-Transistor zum vollständigen Durchsteu-

ern jedoch eine Gate-Spannung oberhalb der Zwischenkreisspannung benötigt, wird eine

Bootstrap-Schaltung implementiert. Ein Kondensator lädt sich dabei während der Leitpha-

se des Low-Side-Schalters auf. Schaltet die Halbbrücke um, „schwimmt“ das Potential des

Kondensators mit der Source-Spannung nach oben und stellt dem Treiber die notwendige

Überspannung bereit [3, S. 1].

# 2.2.2 Sensorbasierte Blockkommutierung

Zur Erfassung der absoluten Rotorlage verfügt der Motor über drei im Stator integrierte Hall-

Sensoren, welche räumlich um 120◦

elektrisch versetzt angeordnet sind. Dieser Versatz teilt

eine elektrische Umdrehung in sechs eindeutig identifizierbare, 60◦ breite Sektoren.

Die hardwarenahe und robusteste Methode zur Ansteuerung ist die sogenannte Blockkommu-

tierung (Six-Step-Commutation). Hierbei werden dem jeweiligen Hall-Zustand feste Schalt-

T3_3200 | Pascal Lauer | 2 Theoretische Grundlagen

muster zugeordnet. Zu jedem Zeitpunkt sind exakt zwei Phasen aktiv bestromt, während die

dritte Phase hochohmig verbleibt. Die Zustandslogik für das Invertersystem ist in Tabelle 2.1

zusammengefasst.

Tabelle 2.1: Zustandstabelle der Blockkommutierungslogik in Abhängigkeit der Hall-Sensoren

Hall-Sensoren | Phasenzustand | Sektor
H1 | H2 | H3 | U | V | W
1 | 0 | 1 | VDC | GND | NC | I
1 | 0 | 0 | VDC | NC | GND | II
1 | 1 | 0 | NC | VDC | GND | III
0 | 1 | 0 | GND | VDC | NC | IV
0 | 1 | 1 | GND | NC | VDC | V
0 | 0 | 1 | NC | GND | VDC | VI

In der hier verwendeten Blockkommutierung sind die Phasenströme nicht sinusförmig, sondern

werden idealerweise als 120° breite Stromblöcke eingeprägt, die mit den flachen Dächern der

trapezförmigen BEMF überlappen. Der Effektivwert IRMS eines Stroms ist allgemein über

eine elektrische Periode als quadratischer Mittelwert definiert und gilt unabhängig von der

Stromform. Für einen idealen 120°-Blockstrom ergibt sich daraus IRMS =

√
2/3. In dieser Arbeit

wird der Nennstrom des Motors jedoch zunächst als äquivalenter sinusförmiger Phasenstrom

angegeben und anschließend in einen zugehörigen Block-Spitzenstrom umgerechnet, der für

die elektrische und thermische Auslegung maßgeblich ist. Um das erzeugte Drehmoment

regeln zu können, werden die MOSFETs der aktiven Phasen mit einem pulsweitenmodulierten

Signal (PWM) hochfrequent getaktet. Das sich ergebende Tastverhältnis d moduliert die

anliegende effektive Phasenspannung gemäß der Relation ̄vph = d ⋅ VDC und bestimmt somit

den mittleren Motorstrom.

# 2.2.3 Begründung der Verfahrenswahl

In der modernen Antriebstechnik hat sich neben der Blockkommutierung die Raumzeigermo-

dulation (SVPWM) als Standard etabliert. Dabei wird ein kontinuierlich rotierender Spannungs-

raumzeiger durch eine präzise Überlagerung aller drei Halbbrücken generiert. Theoretisch

bietet die SVPWM eine um den Faktor 2 ⋅

√
3

−1 ≈ 1,15 bessere Ausnutzung der Zwischenkreiss-

pannung sowie eine Reduktion der Drehmomentwelligkeit wie in [4] beschrieben.

Für den im Rahmen dieser Arbeit konzipierten Motorcontroller wird jedoch bewusst auf eine

SVPWM zugunsten der robusten Blockkommutierung verzichtet. Die Ursache liegt in den

systembedingten Einschränkungen der Rotorlageerfassung. Die SVPWM erfordert zur exakten

Vektorsynthese einen kontinuierlichen und hochaufgelösten Rotorwinkel. Da die vorhandenen

T3_3200 | Pascal Lauer | 2 Theoretische Grundlagen

Hall-Sensoren jedoch lediglich eine diskrete Auflösung von 60◦

aufweisen, müsste der Winkel

zwischen zwei Schaltflanken vom Mikrocontroller zeitbasiert interpoliert werden.

Während diese lineare Interpolation bei stationären Drehzahlen zufriedenstellend funktioniert,

führt sie bei hochdynamischen Lastwechseln unweigerlich zu massiven Schätzfehlern. Die

fehlerhaft interpolierte Rotorlage erzwingt das Anlegen falscher Raumzeigervektoren, was

im Verlust der Synchronität oder sogar in der Zerstörung der Leistungsendstufe durch pa-

rasitäre Fehlströme resultieren kann. Da kein hochauflösender optischer oder magnetischer

Encoder vorgesehen ist, stellt die strikt zustandsbasierte Blockkommutierung die deutlich

betriebssicherere und technisch überlegene Lösung für dynamische Traktionsantriebe dar.

# 2.2.4 Vierquadrantenbetrieb und Rekuperation

Ein Traktionsantrieb muss neben dem motorischen Betrieb auch das aktive Bremsen beherr-

schen. Da der BLDC-Motor bei Rotation eine Spannung in den Statorwicklungen induziert,

kann er kinetische Energie in elektrische Energie umwandeln. Da die induzierte Gegenspan-

nung bei niedrigen Drehzahlen oft geringer ist als die Zwischenkreisspannung, wird die

B6-Brücke in diesem Zustand leistungselektronisch als aktiver Aufwärtswandler betrieben.

Durch geeignetes Takten der Low-Side-Transistoren wird magnetische Energie in den Moto-

rinduktivitäten zwischengespeichert und anschließend auf das höhere Spannungsniveau des

Zwischenkreises gepumpt. Qualitativ vertauschen sich beim Übergang vom motorischen in

den generatorischen Betrieb lediglich die Rollen der taktenden und freilaufenden Schalter.

# 2.2.5 Prinzip der Phasenstromerfassung

Für einen sicheren Betrieb ist die Kenntnis des Phasenstroms unerlässlich. Bei hochdynami-

schen Lastwechseln oder einer mechanischen Blockade des Rotors verschwindet die induzierte

Gegenspannung (eU ≈ 0). Gemäß der Spannungsgleichung 2.1 würde die anliegende Spannung

in diesem Moment nur durch den sehr geringen ohmschen Wicklungswiderstand begrenzt

werden, was physikalisch zu zerstörerischen Kurzschlussströmen führt. Um diesen Strom

in einer B6-Brücke mit Blockkommutierung messtechnisch erfassen zu können, wird eine

Single-Shunt-Topologie verwendet. Hierbei wird ein einzelner, niederohmiger Messwiderstand

(Shunt) in den gemeinsamen Rückleiterpfad (GND) der drei Low-Side-Halbbrücken platziert.

Da bei der Blockkommutierung stets exakt eine Phase den Hin- und eine Phase den Rückstrom

führt, entspricht der im Gleichspannungszwischenkreis gemessene Stromwert betragsmäßig

dem aktuell fließenden Phasenstrom.

T3_3200 | Pascal Lauer | 2 Theoretische Grundlagen

# 2.3 Verlustmechanismen in Leistungshalbleitern

Ein idealer Halbleiter würde verlustfrei arbeiten und Zustandswechsel in unendlich kurzer

Zeit vollziehen. Reale Transistoren und Dioden weisen jedoch parasitäre Eigenschaften auf,

die unvermeidlich zu einer Verlustleistung führen. Diese elektrische Leistung wird in Wärme-

energie umgewandelt und muss über das thermische Management abgeführt werden, um eine

Zerstörung des Bauteils zu verhindern. Die Gesamtverluste in einer leistungselektronischen

Halbbrücke setzen sich primär aus Leit- und Schaltverlusten der Schalter sowie der zugehörigen

Freilaufdioden zusammen. Sperrverluste (Leakage Losses), die durch Leckströme im blockie-

renden Zustand entstehen, liegen bei Niederspannungsanwendungen im Mikrowatt-Bereich

und können für die thermische Dimensionierung vernachlässigt werden [5, S. 3].

# 2.3.1 Verluste im MOSFET

Die Verluste im MOSFET dominieren die thermische Belastung des Motorcontrollers. Abbildung

2.5 verdeutlicht den Unterschied zwischen dem idealen und dem realen Schaltverhalten am

Beispiel einer induktiv belasteten Halbbrücke, wie sie im Motorinverter vorliegt.

δT | T

vi

iL,0

iL,δT

t

iS, vS

(a) Idealer Schalter
δT | T

vi

iL,0

iL,δT

t

iS, vS

(b) Realer Schalter

Abbildung 2.5: Spannungs- und Stromverlauf in einer induktiv belasteten Halbbrücke.

# Leitverluste

Im statisch eingeschalteten Zustand verhält sich der Drain-Source-Kanal des MOSFETs nä-

herungsweise wie ein ohmscher Widerstand RDS(on). Die daraus resultierenden Leitverluste

lassen sich in Abhängigkeit des Effektivstroms IRMS berechnen:

## PMOS,c = I

2
RMS ⋅ RDS(on)(TJ) | (2.3)

Kritisch für die Systemstabilität ist hierbei die Temperaturabhängigkeit. Der Kanalwiderstand

steigt mit zunehmender Sperrschichttemperatur TJ signifikant an. Dies führt zu einem positiven

T3_3200 | Pascal Lauer | 2 Theoretische Grundlagen

thermischen Rückkopplungseffekt, der bei der Auslegung zwingend berücksichtigt werden

muss. Der entsprechende Wert für RDS(on) kann aus der Datenblattkennlinie des Herstellers

bestimmt werden.

# Schaltverluste

Da MOSFETs bauartbedingt nicht unendlich schnell umschalten können, treten beim Über-

gang zwischen dem leitenden und sperrenden Zustand Transienten auf. In diesen Phasen

überlappen sich Spannung und Strom (vgl. Abb. 2.5 rechts), wodurch Momentanleistung in

Wärme umgesetzt wird.

Für die Berechnung der Schaltverluste ist es dabei ausreichend, den Schaltvorgang nähe-

rungsweise linear zu betrachten, was zugleich eine konservative Worst-Case-Abschätzung

darstellt [5, S. 6]. Der idealisierte Verlauf umfasst insbesondere den zeitlichen Anstieg der

Gate-Spannung, die Stromübernahme durch den MOSFET sowie die Umladevorgänge der

parasitären Kapazitäten und die Effekte der Diodenrückwärtserholung (Reverse Recovery).

Maßgeblich für die Schaltdynamik sind die internen parasitären Kapazitäten des Halbleiters

(siehe Abbildung 2.6). Von besonderer Bedeutung ist die Gate-Drain-Kapazität CGD (Miller-

Kapazität). Während des Schaltvorgangs führt das Umladen dieser Kapazität zum sogenannten

Miller-Plateau, einem Zustand, in dem die Gate-Spannung konstant verharrt, bis die Drain-

Source-Spannung vollständig kommutiert ist.

## CDS

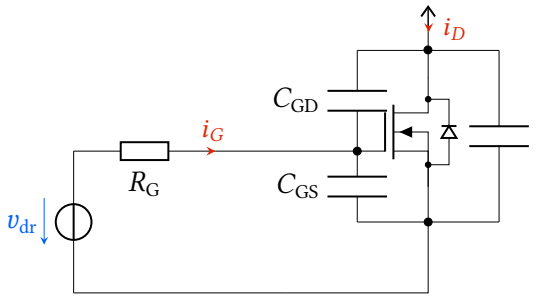
[picture p6: figure]
vdr; CGD; CGS

Abbildung 2.6: Interne parasitäre Kapazitäten eines MOSFETs.

Die Schaltverluste setzen sich maßgeblich aus der Summe der Einschalt- (PMOS,on) und Aus-

schaltverluste (PMOS,off) zusammen, die im Folgenden hergeleitet werden.

# Einschaltvorgang (PMOS,on)

Beim Einschalten wird der MOSFET durch die Treiberstufe von 0 V auf die Treiberspannung vdr

angesteuert. Zunächst steigt die Gate-Source-Spannung mit einer durch RG und die Eingangs-

kapazität Ciss bestimmten Zeitkonstante an, ohne dass sich der Laststrom ändert. Erst beim

Erreichen der Schwellspannung vGS,th beginnt der Drainstrom anzusteigen und übernimmt

T3_3200 | Pascal Lauer | 2 Theoretische Grundlagen

den Laststrom. Während dieser Stromanstiegsphase liegt weiterhin nahezu die volle Drain-

Source-Spannung an, sodass eine Überlappung von Strom und Spannung entsteht. Zusätzlich

muss beim Einschalten die Rückwärtserholung der Freilaufdiode berücksichtigt werden. Die

im Halbleiter gespeicherten Ladungsträger führen zu einem zusätzlichen Stromanteil (Reverse-

Recovery-Strom), der vom MOSFET aufgenommen werden muss und die Einschaltverluste

erhöht [5, S. 6]. Die entsprechenden Werte können wiederum aus dem Datenblatt des MOSFETs

bestimmt werden. Der Einschaltvorgang ist in Abbildung 2.7 dargestellt.

t0 | t1 | t2 | t3 | t4

vGS,th

vGS,Mi

vdr

iL,0

vi

t

v, i

vDS | iD
vdr | vGS

Abbildung 2.7: Einschaltvorgang eines MOSFETs in einer induktiv belasteten Halbbrücke.

Der vGS-Verlauf zwischen t2 ≤ t ≤ t3 wird als Millerplateau bezeichnet. Aus dem Datenblatt

lässt sich anhand von vGS,th und der Miller-Spannung vGS,Mi die benötigte Umschaltladung Qsw

ablesen. Diese charakterisiert das für die verlustbehaftete Strom-Spannungs-Überlappung

relevante Zeitintervall t1 ≤ t ≤ t3. Der sich in dieser Phase einstellende Gatestrom iG lässt sich

mittels der Maschenregel ermitteln:

iG =

vdr − vGS,Mi
RG

(2.4)

Unter Anwendung des physikalischen Zusammenhangs von Ladung und Strom (Q = I ⋅ Δt)

kann die Dauer der relevanten Einschaltflanke (t3 − t1) berechnet werden. Durch Einsetzen

von Gleichung 2.4 in diese Beziehung ergibt sich:

(t3 − t1) = | Qsw ⋅ RG
| vdr − vGS,Mi

(2.5)

Mit Kenntnis dieses kritischen Zeitintervalls lässt sich die während eines einzelnen Einschalt-

vorgangs im MOSFET dissipierte Gesamtenergie berechnen:

EMOS,on =

1

2

iL,0 ⋅ vi

⋅ (t3 − t1) + EMOS,on,rr | (2.6)

T3_3200 | Pascal Lauer | 2 Theoretische Grundlagen

Der zusätzliche Energieanteil EMOS,on,rr resultiert aus der im pn-Übergang der gegenüberlie-

genden Freilaufdiode gespeicherten Sperrverzögerungsladung Qrr. Da der Halbleiterschalter

diesen transienten Strompuls bei nahezu voller Zwischenkreisspannung vi aufnehmen muss,

berechnet sich der entsprechende Verlustanteil im MOSFET gemäß [5, S. 10] zu:

EMOS,on,rr = Qrr ⋅ vi | (2.7)

# Ausschaltvorgang (PMOS,off)

Der Ausschaltvorgang verhält sich prinzipiell invers zum Einschaltvorgang. Abbildung 2.8

visualisiert den idealisierten zeitlichen Verlauf der maßgeblichen Größen.

t0 | t1 | t2 | t3 | t4

vGS,th

vGS,Mi

vdr

iL,δT

vi

t

v, i

vDS | iD
vdr | vGS

Abbildung 2.8: Ausschaltvorgang eines MOSFETs in einer induktiv belasteten Halbbrücke.

Analog zum Einschaltvorgang bestimmt sich der Gatestrom während der Entladung der

Miller-Kapazität. Bei einer treiberseitigen Abschaltschwellenspannung von vdr,off lautet die

entsprechende Maschengleichung:

iG =

vGS,Mi − vdr,off
RG

(2.8)

Mithilfe der Umschaltladung Qsw lässt sich die Gleichung nach dem zeitlichen Ausräumintervall

der Ladungsträger (t3 − t1) umstellen. Eingesetzt ergibt sich die Dauer der Schaltflanke zu:

(t3 − t1) = | Qsw ⋅ RG
| vGS,Mi − vdr,off

(2.9)

Die während dieser Zeitspanne im MOSFET dissipierte Energie EMOS,off berechnet sich zu:

EMOS,off =

1

2

iL,δT ⋅ vi

⋅ (t3 − t1) | (2.10)

T3_3200 | Pascal Lauer | 2 Theoretische Grundlagen

Die dynamischen Umschaltverluste des Transistors hängen folglich maßgeblich von der ge-

wählten Umschaltfrequenz fsw ab. Die Gesamtschaltverlustleistung PMOS,sw resultiert aus den

berechneten Schaltenergien EMOS,on und EMOS,off:

PMOS,sw = PMOS,on + PMOS,off = fsw ⋅ (EMOS,on + EMOS,off) | (2.11)

# 2.3.2 Verluste in der Freilaufdiode

In einer B6-Brückentopologie wird die Funktion der Freilaufdiode durch die intrinsische

Body-Diode der MOSFETs übernommen (vgl. Abb. 2.4). Da der Strom in der Totzeit des Gate-

Treibers über diese Diode fließen muss, trägt sie zur Erwärmung bei. Abbildung 2.9 stellt das

Schaltverhalten einer idealen Diode dem einer realen Body-Diode in einer induktiv belasteten

Halbbrücke gegenüber.

δT | T

−vi

iL,0

iL,δT

t

## iD, vD

(a) Ideale Diode
δT | T

−vi

iL,0

iL,δT

t

## iD, vD

(b) Reale Diode

Abbildung 2.9: Spannungs- und Stromverlauf in einer induktiv belasteten Halbbrücke.

# Durchlassverluste (PD,c)

Während der Leitphase fällt an der Diode eine nichtlineare Durchlassspannung vD ab. Die

mittleren Leitverluste berechnen sich über das Integral der Momentanleistung:

## PD,c =

1

T

∫

T

0

iD(t) ⋅ vD(t) dt | (2.12)

Zur analytischen Berechnung wird die Diodenkennlinie durch eine Reihenschaltung aus einer

Schwellenspannung vD,0 und einem differentiellen Widerstand rD approximiert (vgl. [5, Abb. 2]).

Durch diese Annäherung lassen sich die resultierenden Verluste in einen spannungs- und einen

widerstandsabhängigen Anteil (PU und PR) unterteilen. Mithilfe dieser Näherung ergibt sich:

PD,c = PU + PR = vD,0iD + rDi

2
D,RMS | (2.13)

T3_3200 | Pascal Lauer | 2 Theoretische Grundlagen

# Sperrverzögerungsverluste (Reverse Recovery)

Beim Übergang der Diode vom leitenden in den sperrenden Zustand (Abschalten) kann der

Stromfluss nicht augenblicklich stoppen. Um die im pn-Übergang gespeicherte Ladung Qrr

abzubauen, fließt für kurze Zeit ein negativer Sperrverzögerungsstrom.

Da in diesem Moment die gegenüberliegende Halbbrücke bereits einschaltet und die volle Zwi-

schenkreisspannung vi anliegt, entsteht eine ausgeprägte Verlustleistungsspitze. Theoretisch

berechnen sich diese Reverse-Recovery-Verluste (Prr) der Diode näherungsweise zu:

## Prr =

1

2

vi

⋅ IRM ⋅

1

2

⋅ trr ⋅ fSW | (2.14)

In der praktischen Anwendung von Niederspannungsumrichtern wird diese Gleichung jedoch

selten angewandt. Obwohl die Ladung Qrr maßgeblich von der Diode verursacht wird, dis-

sipiert die resultierende Verlustleistung nahezu vollständig in Form der bereits erwähnten

Einschaltenergie EMOS,on,rr im gegenüberliegenden, aktiven MOSFET. Die eigenen, internen

Schaltverluste der Diode können daher für die thermische Dimensionierung vernachlässigt

werden [5, S. 10]. Sperrverluste durch Leckströme sowie Vorwärtsverzögerungsverluste (For-

ward Recovery) sind in Niederspannungsanwendungen technisch irrelevant und fließen nicht

in die weitere Auslegung ein.

# 3 Anforderungen und Systemkonzept

Dieses Kapitel definiert die technischen Spezifikationen und beschreibt das übergeordnete

Systemkonzept des Motorcontrollers. Aus den Randbedingungen des Antriebsstrangs werden

die elektrischen und thermischen Anforderungen abgeleitet. Diese bilden die verbindliche

Grundlage für die in Kapitel 4 folgende Komponentenauswahl und Verlustleistungsberech-

nung. Abschließend werden die gewählte Hardwarearchitektur sowie das interruptbasierte

Softwarekonzept vorgestellt.

# 3.1 Elektrische und thermische Anforderungen

Das Antriebssystem basiert auf zwei bürstenlosen Gleichstrommotoren mit einer mechanischen

Nennleistung von jeweils 400 W. Die Energieversorgung erfolgt über einen Lithium-Ionen-

Akkumulator (10S-Konfiguration) mit einer Nominalspannung von 36 V, einer Ladeschlussspan-

nung von 42 V und einer Kapazität von 4,4 Ah. Aus diesen mechanischen und physikalischen

Randbedingungen lassen sich die Anforderungen an die Leistungselektronik ableiten.

# 3.1.1 Spannungs- und Stromdimensionierung

Während des Betriebs können durch induktive Lastwechsel und parasitäre Leitungsinduk-

tivitäten kurzzeitige Überspannungen auftreten. Ein weiterer relevanter Effekt ist der Span-

nungsanstieg im Zwischenkreis während generatorischer Betriebszustände (rekuperatives

Bremsen). Um einen sicheren Betrieb im Vierquadrantenbetrieb zu gewährleisten, müssen alle

leistungstragenden Komponenten (MOSFETs, Kondensatoren) für eine Spannungsfestigkeit

von mindestens 60 V ausgelegt werden. Aus Gründen der Bauteilzuverlässigkeit wird eine

Auslegungsreserve auf 80 V angestrebt. Bei einer Nennleistung von 400 W und 36 V ergibt sich

im stationären Betrieb ein mittlerer Strom von etwa 11,1 A pro Motor. Um einen kraftvollen

Anlauf aus dem Stillstand zu garantieren, wird die Endstufe für einen transienten, äquivalent

sinusförmigen Phasen-Effektivstrom von 30 ARMS dimensioniert, woraus für die verwendete

Blockkommutierung konservativ ein zulässiger Block-Spitzenstrom von 42,4 A entspricht. Um

das System vor den in Abschnitt 2.2.5 beschriebenen Überströmen zu schützen, ist eine hard-

warenahe Strombegrenzung (Cycle-by-Cycle Current Limiting) zwingend erforderlich, welche

T3_3200 | Pascal Lauer | 3 Anforderungen und Systemkonzept

den Maximalstrom strikt auf diese 42,4 A limitiert und die Obergrenze für die Safe Operating

Area (SOA) bildet.

# 3.1.2 Thermische Randbedingungen

Die thermische Dimensionierung stellt eine der größten Herausforderungen beim Entwurf

kompakter Motorcontroller dar. Das System muss in der Lage sein, die bei 42,4 A entstehenden

Halbleiterverluste zuverlässig abzuführen. Als Randbedingung wird ein passives Kühlkonzept

(Aluminium-Kühlkörper ohne erzwungene Konvektion) bei einer maximalen Umgebungstem-

peratur von 40 ◦C definiert. Obwohl moderne Silizium-Leistungs-MOSFETs Sperrschichttempe-

raturen von bis zu 175 ◦C tolerieren, wird die maximale Arbeitstemperatur der Halbleiter (TJ)

für die theoretischen Berechnungen konservativ auf 100 ◦C limitiert. Diese thermische Reserve

begrenzt den temperaturbedingten Anstieg des Einschaltwiderstands RDS(on) und schwächt

die positive thermische Rückkopplung, wodurch das Risiko eines thermischen Durchgehens

(Thermal Runaway) ausgeschlossen wird.

# 3.1.3 Schaltfrequenz

Zur Vermeidung wahrnehmbarer akustischer Emissionen des Motors sowie zur Reduktion der

Stromwelligkeit wird die PWM-Schaltfrequenz knapp oberhalb der menschlichen Hörschwelle

auf 20 kHz festgelegt. Eine höhere Frequenz würde zwar den Stromrippel in den Motorindukti-

vitäten weiter glätten, gleichzeitig aber die dynamischen Schaltverluste in der Endstufe massiv

erhöhen. Zur besseren Übersicht sind alle abgeleiteten Systemanforderungen in Tabelle 3.1

zusammengefasst.

Tabelle 3.1: Zusammenfassung der elektrischen und thermischen Systemanforderungen.

Parameter | Symbol Wert Einheit
Nominale Akkumulatorspannung | Vbat,nom | 36 | V
Maximale Ladeschlussspannung | Vbat,max | 42 | V
Geforderte Spannungsfestigkeit | VDS,max | ≥ 60 | V
Maximales aktives Stromlimit | IBlock,max | 42,4 | A)
PWM-Schaltfrequenz | fsw | 20 | kHz
Logikpegel des Mikrocontrollers | Vlogic | 3,3 | V
Max. zulässige Umgebungstemperatur | TA | 40 | ◦C
Thermische Auslegungsgrenze | TJ,design | 100 | ◦C

T3_3200 | Pascal Lauer | 3 Anforderungen und Systemkonzept

# 3.2 Systemarchitektur und Signalfluss

Um die abgeleiteten Anforderungen umzusetzen, wird der Motorcontroller in eine modulare

Hardwarearchitektur gegliedert. Das Gesamtsystem besteht aus drei funktionalen Haupt-

blöcken: der digitalen Steuerungseinheit, der analogen Treiberstufe und dem Leistungsteil

mit integrierter Strommessung. Abbildung 3.1 veranschaulicht das Blockdiagramm sowie den

Signalfluss des Motorcontrollers.

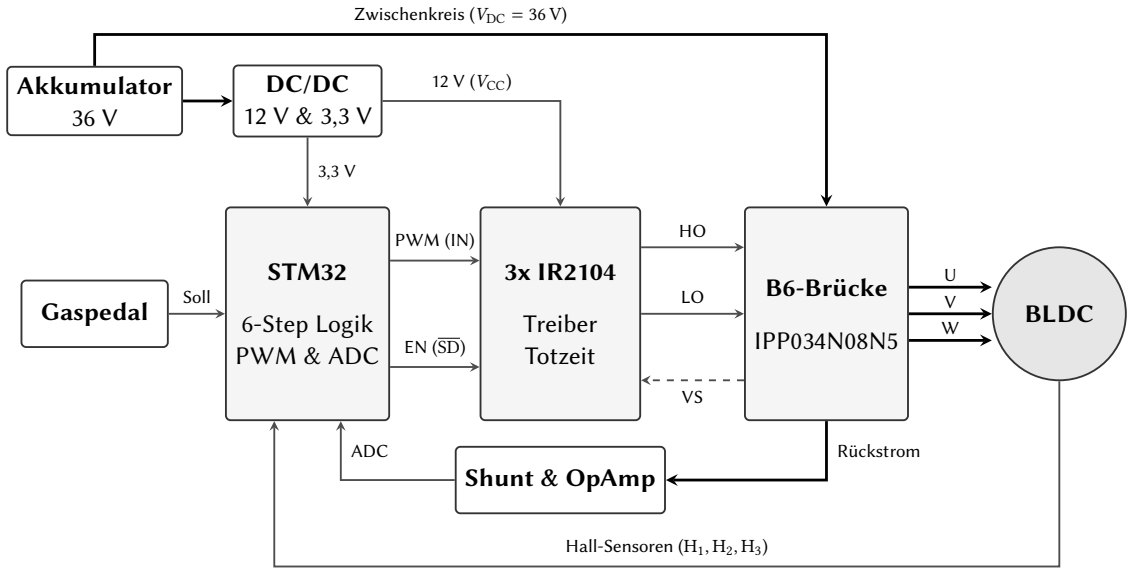
[picture p7: figure]
Gaspedal; Akkumulator; STM32; 6-Step Logik; PWM & ADC; Treiber; Totzeit; B6-Brücke; IPP034N08N5; Shunt & OpAmp; BLDC; Zwischenkreis (VDC = 36 V); Rückstrom; 12 V (VCC); Soll; PWM (IN); ADC; Hall-Sensoren (H1, H2, H3)

Abbildung 3.1: Systemarchitektur und Signalfluss des Motorcontrollers.

Die Steuerungsebene wird durch einen STM32-Mikrocontroller abgebildet. Die Firmware wer-

tet die diskreten Signale der Hall-Sensoren aus und generiert die hochfrequenten PWM-Signale.

Gleichzeitig überwacht der integrierte Analog-Digital-Wandler (ADC) den Spannungsabfall an

einem Low-Side-Shunt, welcher über einen Operationsverstärker aufbereitet wird, um den

Phasenstrom zu regeln. Der Gleichspannungszwischenkreis wird durch Elektrolytkondensato-

ren realisiert und puffert die hochfrequenten Rippleströme des Inverters, um den Akkumulator

vor transienten Stromspitzen zu schützen.

# 3.3 Softwarearchitektur und Zustandsautomat

Während die Hardware die physikalischen Leistungsgrenzen definiert, bestimmt die Archi-

tektur der Firmware die dynamische Reaktionsfähigkeit des Antriebs. Zur echtzeitfähigen

Umsetzung der Blockkommutierung und der Systemüberwachung ist die Steuerungssoftwa-

re als deterministischer, strikt ereignisgesteuerter Zustandsautomat ausgeführt. Der Fokus

liegt dabei auf minimalen Latenzen, hoher zeitlicher Deterministik sowie einem definierten

T3_3200 | Pascal Lauer | 3 Anforderungen und Systemkonzept

Fail-Safe-Verhalten. Die Architektur gliedert sich primär in zwei parallel ablaufende, hochprio-

risierte Hardware-Interrupts: die asynchrone Rotorlageerfassung (Position Control) und die

synchrone Stromüberwachung (Current Control). Beide Routinen sind so ausgelegt, dass sie

unabhängig voneinander arbeiten, jedoch über gemeinsam genutzte Zustandsgrößen implizit

gekoppelt sind. Die Priorisierung der Interrupts stellt sicher, dass zeitkritische Kommutie-

rungsvorgänge stets deterministisch ausgeführt werden, während die Strombegrenzung als

überlagerte Schutzfunktion wirkt. Das funktionale Zusammenspiel dieser beiden Kernprozesse

ist im Flussdiagramm in Abbildung 3.2 detailliert dargestellt und wird im Folgenden erläutert.

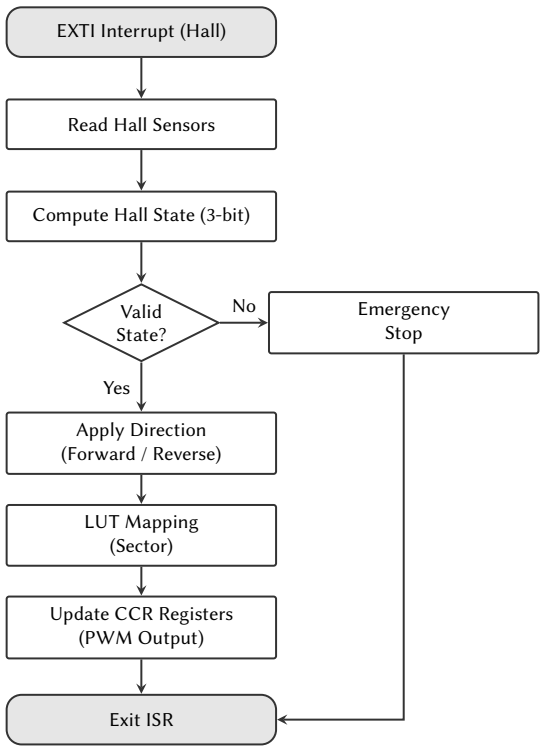
[picture p8: figure]
EXTI Interrupt (Hall); Read Hall Sensors; Compute Hall State (3-bit); Valid; State?; Apply Direction; (Forward / Reverse); LUT Mapping; (Sector); Update CCR Registers; (PWM Output); Exit ISR; Emergency; Stop; Yes

(a) Position Control (Asynchron)

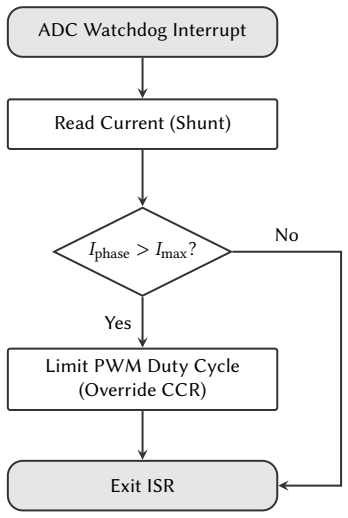
[picture p9: figure]
ADC Watchdog Interrupt; Read Current (Shunt); Iphase > Imax?; Limit PWM Duty Cycle; (Override CCR); Exit ISR; Yes

(b) Current Control (Synchron)

Abbildung 3.2: Architektur der ISR mit Kommutierungslogik und Strombegrenzung.

# 3.3.1 Ereignisgesteuerte Kommutierung

Die Erfassung der absoluten Rotorlage sowie die physikalische Umschaltung der Phasen

erfolgen ausnahmslos innerhalb der Interrupt-Service-Routine (ISR) der externen Interrupts

(Abbildung 3.2a). Die drei Hall-Sensoren sind an dedizierte GPIO-Pins angebunden, die bei jeder

detektierten Signalflanke den Mikrocontroller unterbrechen. Dadurch ergibt sich eine strikt

ereignisgetriebene Verarbeitung ohne zyklisches Polling, was die Reaktionszeit minimiert und

die CPU-Last reduziert. Innerhalb dieser ISR werden die Signalzustände eingelesen und mittels

bitweiser Kodierung zu einem Zustandsvektor zusammengefasst. Dieser Vektor korrespondiert

T3_3200 | Pascal Lauer | 3 Anforderungen und Systemkonzept

über eine zeiteffiziente Lookup Table (LUT) eindeutig mit dem aktuellen physikalischen Sektor

des Motors. Die Verwendung einer LUT ermöglicht einen Zugriff in konstanter Zeit ohne

zusätzliche Berechnungen und trägt somit wesentlich zur deterministischen Laufzeit der

ISR bei. Unmittelbar im Anschluss aktualisiert die Software die Timer-Capture-Compare-

Register (CCR), welche die hardwareseitige PWM-Ausgabe an die Gate-Treiber modulieren.

Die gesamte ISR ist auf minimale Ausführungszeit optimiert und bewegt sich typischerweise

im Mikrosekundenbereich, wodurch auch bei hohen Drehzahlen und entsprechend hoher

Interruptfrequenz eine zuverlässige Kommutierung gewährleistet ist.

# 3.3.2 Nebenläufigkeit und Interrupt-Priorisierung

Da sowohl die Positions- als auch die Stromregelung interruptbasiert realisiert sind, ist das

Verhalten bei konkurrierenden Ereignissen von zentraler Bedeutung. Die EXTI-Interrupts zur

Kommutierung sind höher priorisiert als der ADC-Interrupt, um sicherzustellen, dass die

korrekte Phasenumschaltung niemals durch die Stromüberwachung verzögert wird. Im Falle

simultaner Interrupt-Ereignisse wird die laufende ADC-ISR durch die EXTI-ISR unterbrochen

(Preemption). Durch diese Priorisierung wird garantiert, dass keine inkonsistenten Schalt-

zustände entstehen. Gemeinsame Variablen, insbesondere das PWM-Tastverhältnis, sind so

ausgelegt, dass sie atomar aktualisiert werden oder nur in definierten Kontexten beschrieben

werden, wodurch Race Conditions vermieden werden.

# 3.3.3 Sicherheitslogik und Notabschaltung

Wie im Kommutierungspfad ersichtlich, beinhaltet die Softwarearchitektur eine essenzielle

Plausibilitätsprüfung. Sollte durch Störeinflüsse (EMV), Sensorfehler oder einen Kabelbruch

ein physikalisch unmöglicher Hall-Zustand (wie 0b000 oder 0b111) auftreten, wird unmit-

telbar der Default-Case aktiviert. In diesem Notfall werden ausnahmslos alle Gate-Treiber

deaktiviert (Emergency Stop), um gefährliche Brückenkurzschlüsse im Inverter zu verhindern.

Der Fehlerzustand wird dabei persistent gehalten, sodass ein automatischer Wiederanlauf

ausgeschlossen ist. Eine Wiederinbetriebnahme erfordert eine explizite Rücksetzung durch die

übergeordnete Steuerlogik. Dieses Fail-Safe-Konzept stellt sicher, dass auch bei transienten

Fehlern kein unkontrollierter Betrieb möglich ist.

# 3.3.4 Aktive Strombegrenzung und Rekuperation

Zusätzlich zur reinen Kommutierung regelt ein synchroner Steuerungspfad den Phasenstrom

(vgl. Abbildung 3.2b). Um den thermischen Worst-Case abzusichern, ist im Mikrocontrol-

ler ein an den Analog Watchdog gekoppelter ADC-Interrupt konfiguriert. Dieser überwacht

kontinuierlich den Spannungsabfall über einen Shunt-Widerstand und ermöglicht so eine

T3_3200 | Pascal Lauer | 3 Anforderungen und Systemkonzept

indirekte Strommessung. Übersteigt der gemessene Strom den Grenzwert von 42,4 A, erzwingt

die Firmware in Echtzeit eine Reduktion des PWM-Tastverhältnisses. Dies führt zu einer

unmittelbaren Verringerung der angelegten Phasenspannung und somit zu einer Begrenzung

des Stromanstiegs. Das System verhält sich dabei wie ein nichtlinearer Stromregler, der den

Phasenstrom dynamisch am Grenzwert stabilisiert. Diese Systemarchitektur bildet gleichzeitig

die Grundlage für die Rekuperation. Wird ein negatives Drehmoment gefordert, invertiert die

Hauptschleife das Kommutierungsmuster. Der Motor arbeitet in diesem Betriebszustand als

Generator, wobei die mechanische Energie in elektrische Energie umgewandelt und in den

Zwischenkreis zurückgespeist wird. Der Inverter verhält sich dabei funktional wie ein Boost-

Converter, da die induzierte Gegenspannung des Motors über die Schaltzustände angehoben

und dem Versorgungssystem zugeführt wird. Die Strombegrenzung bleibt auch im Rekuperati-

onsbetrieb aktiv und stellt sicher, dass der Rückspeisestrom das definierte Hardware-Limit

nicht überschreitet. Dadurch wird sowohl die Leistungselektronik als auch die Energiequelle

vor Überlast geschützt.

# 4 Entwurf der Leistungselektronik

Basierend auf den in Kapitel 3 definierten Systemanforderungen erfolgt in diesem Kapitel die

konkrete Dimensionierung der leistungselektronischen Komponenten. Der Fokus liegt dabei

auf der Auswahl der Leistungshalbleiter, der Berechnung der zugehörigen Verlustleistungen

sowie der Auslegung der Treiber- und Zwischenkreisstrukturen. Der vollständige Schaltplan

des Gesamtsystems, aus dem die nachfolgend diskutierten Teilschaltungen entnommen sind,

ist zur detaillierten Übersicht in Anhang A.3 dokumentiert.

# 4.1 Auswahl der Leistungshalbleiter

Die Auswahl der Leistungshalbleiter stellt einen zentralen Entwurfsschritt im Motorcontroller

dar, da diese Bauelemente den Wirkungsgrad, das Schaltverhalten sowie die thermische Zuver-

lässigkeit des Gesamtsystems maßgeblich bestimmen. Für die Realisierung der dreiphasigen

B6-Brückentopologie wurde der N-Kanal-Leistungs-MOSFET IPP034N08N5 aus der OptiMOS™-

5-Serie von Infineon Technologies ausgewählt [6]. Die nachfolgend diskutierten elektrischen

und thermischen Kennwerte basieren auf den im Datenblatt spezifizierten Parametern. Ein we-

sentliches Auswahlkriterium ist die Spannungsfestigkeit des Transistors. Bei einer maximalen

Ladeschlussspannung des verwendeten Akkumulators von 42 V muss der MOSFET sowohl

diese Gleichspannung sicher sperren als auch transiente Überspannungen tolerieren, die in-

folge schneller Schaltvorgänge an den induktiven Motorwicklungen sowie durch parasitäre

Streuinduktivitäten entstehen. Der gewählte MOSFET besitzt eine spezifizierte Drain-Source-

Durchbruchspannung von VDS = 80 V. Gegenüber der maximalen Zwischenkreisspannung

ergibt sich somit eine großzügige Sicherheitsreserve. Neben der Spannungsfestigkeit stellt die

Stromtragfähigkeit ein weiteres kritisches Kriterium dar. Der Motorcontroller ist für einen

äquivalent sinusförmigen Phasenstrom von 30 ARMS ausgelegt. Der ausgewählte MOSFET ist

für einen maximalen kontinuierlichen Drainstrom von ID = 120 A (bei einer Gehäusetempera-

tur von TC = 25◦C) spezifiziert und erlaubt Pulsströme bis zu 480 A. Damit liegt der anvisierte

Worst-Case-Betriebspunkt thermisch und elektrisch sicher innerhalb der Betriebsgrenzen

(SOA) des Bauelements. Zur Minimierung der statischen Leitverluste ist ein möglichst geringer

Durchlasswiderstand erforderlich. Der IPP034N08N5 weist bei einer Gate-Source-Spannung

von VGS = 10 V einen maximalen Einschaltwiderstand von RDS(on),max = 3,4 mΩ auf. Dieser

T3_3200 | Pascal Lauer | 4 Entwurf der Leistungselektronik

niedrige ohmsche Widerstand reduziert die im Silizium dissipierte Verlustleistung signifikant.

Für den dynamischen Betrieb mit einer PWM-Schaltfrequenz von fsw = 20 kHz sind zusätzlich

die parasitären Kapazitäten relevant. Eine Reduktion des RDS(on) geht physikalisch bedingt häu-

fig mit einer Vergrößerung der Chipfläche und folglich mit erhöhten Kapazitäten einher. Der

gewählte MOSFET bietet hier ein sehr günstiges Verhältnis. Die typische Gesamtgateladung

beträgt QG = 69 nC (max. 87 nC), und die für die Schaltverluste maßgebliche Umschaltladung

liegt bei lediglich Qsw = 26 nC. Dies ermöglicht eine schnelle Umladung durch den Gate-Treiber.

Ein weiterer relevanter Parameter für die Brückentopologie ist die Reverse-Recovery-Ladung

der integrierten Body-Diode, welche beim Umschalten der Halbbrücke abgebaut werden muss.

Diese ist mit Qrr = 166 nC (typisch) bzw. 332 nC (maximal) spezifiziert. Hinsichtlich der me-

chanischen Integration wird der MOSFET im standardisierten TO-220-3-Gehäuse eingesetzt.

Dieses verfügt über eine metallische Kühlfahne mit einem geringen thermischen Übergangswi-

derstand von maximal Rth,JC = 0,9 K/W zwischen Sperrschicht (Junction) und Gehäuse (Case).

Die maximal zulässige Sperrschichttemperatur beträgt TJ,max = 175◦C. Da die Kühlfahne des

Gehäuses elektrisch mit dem Drain-Anschluss verbunden ist, im Inverterbetrieb jedoch un-

terschiedliche Drain-Potenziale auftreten, muss eine elektrische Isolation der Bauelemente

gegenüber einem gemeinsamen Kühlkörper durch wärmeleitfähige Silikonpads sichergestellt

werden. Tabelle 4.1 fasst die wesentlichen Datenblattparameter zusammen.

Tabelle 4.1: Datenblattparameter des ausgewählten Leistungs-MOSFETs [6]

Parameter | Symbol | Wert Einheit
Drain-Source-Durchbruchspannung | VDS | 80 | V
Maximaler Dauerstrom (TC = 25◦C) | ID | 120 | A
Maximaler Einschaltwiderstand (VGS = 10 V) RDS(on),max | 3,4 | mΩ
Typische Umschaltladung | Qsw | 26 | nC
Maximale Gesamtgateladung | QG,max | 87 | nC
Maximale Reverse-Recovery-Ladung | Qrr,max | 332 | nC
Thermischer Widerstand (Junction-to-Case) | Rth,JC,max | 0,9 | K/W
Maximale Sperrschichttemperatur | TJ,max | 175 | ◦C

# 4.2 Phasenstromerfassung und Signalaufbereitung

Wie in den theoretischen Grundlagen (vgl. Kapitel 2.2.5) hergeleitet, ist für die Implementierung

einer aktiven Strombegrenzung eine hochauflösende Erfassung des Stroms erforderlich. Diese

Messung wird topologisch als Low-Side-Single-Shunt-Messung ausgeführt. Hierbei wird ein

niederohmiger Messwiderstand zwischen die zusammengeführten Source-Anschlüsse der drei

Low-Side-MOSFETs und das Massepotenzial (GND) geschaltet.

T3_3200 | Pascal Lauer | 4 Entwurf der Leistungselektronik

# 4.2.1 Dimensionierung des Shunt-Widerstands

Die Dimensionierung des Shunts erfordert einen Kompromiss. Ein hoher Widerstandswert

maximiert das zu messende Spannungssignal und verbessert das Signal-Rausch-Verhältnis

(SNR), führt jedoch quadratisch zu höheren ohmschen Verlustleistungen (P = I

2

## ⋅ R), die abge-

führt werden müssen. Für den vorliegenden Motorcontroller wurde der WSLP25121L000FEA

von Vishay [7] verwendet. Dieser besitzt einen Widerstandswert von Rshunt = 1 mΩ bei einer

Toleranz von 1 %. Die WSLP-Serie zeichnet sich durch eine sehr geringe Induktivität und einen

niedrigen Temperaturkoeffizienten aus, was parasitäre Spannungsspitzen bei den steilen PWM-

Schaltflanken minimiert. Bei dem definierten Worst-Case-Blockstrom von IBlock = 42,4 A fällt

über dem Widerstand eine proportionale Messspannung ab:

Vshunt = IBlock ⋅ Rshunt = 42,4 A ⋅ 0,001 Ω = 42,4 mV | (4.1)

Die dabei im Bauteil dissipierte Verlustleistung berechnet sich zu:

## Pshunt = I

2

Block ⋅ Rshunt = (42,4 A)²
⋅ 0,001 Ω ≈ 1,80 W | (4.2)

Da der ausgewählte Widerstand in der Bauform 2512 für eine maximale Dauerleistung von

3,0 W spezifiziert ist, wird das thermische Derating auch im Volllastbetrieb zuverlässig einge-

halten [7].

# 4.2.2 Signalverstärkung für den Mikrocontroller

Die anliegende Messspannung von maximal 42,4 mV ist zu gering, um vom Analog-Digital-

Wandler (ADC) des STM32-Mikrocontrollers mit ausreichender Auflösung quantisiert zu

werden. Eine Vorverstärkung des Signals ist daher zwingend erforderlich. Zur Umsetzung wird

der dedizierte Current-Sense-Amplifier INA181A2IDBVR von Texas Instruments eingesetzt

[8]. Im Gegensatz zu standardmäßigen Operationsverstärkern verfügt diese Baureihe über ein

werksseitig integriertes und hochpräzise gelasertes Widerstandsnetzwerk, welches eine exakte

Verstärkung garantiert und externe Bauteiltoleranzen eliminiert. Die verwendete Variante

besitzt einen festen Verstärkungsfaktor von G = 50 V/V. Die aufbereitete Ausgangsspannung

VADC, welche direkt an den Mikrocontroller geführt wird, ergibt sich zu:

VADC = Vshunt ⋅ G = 42,4 mV ⋅ 50 = 2,12 V | (4.3)

Der STM32-Mikrocontroller arbeitet mit einer Logik- und Referenzspannung von 3,3 V. Die

maximale Messspannung von 2,12 V liegt somit im optimalen linearen Erfassungsbereich des

12-Bit-ADCs. Es verbleibt eine dynamische Messreserve von rund 1,18 V, wodurch auch transi-

T3_3200 | Pascal Lauer | 4 Entwurf der Leistungselektronik

ente Stromspitzen (bis ca. 66 A) sicher detektiert werden können, bevor Schutzmechanismen

eingreifen und das Tastverhältnis reduzieren. Zur zusätzlichen Signalaufbereitung ist am Aus-

gang des Verstärkers ein RC-Tiefpass mit R = 1 kΩ und C = 10 nF vorgesehen. Dieser dient der

Unterdrückung hochfrequenter Störanteile, insbesondere von Schaltflanken des Leistungsteils,

und verhindert gleichzeitig Aliasing-Effekte im ADC. Der vollständige Signalpfad von der

Strommessung über den Shunt bis hin zur ADC ist in Abbildung 4.1 dargestellt. Dies ermög-

licht der Software eine hochauflösende Auswertung des Motorstroms, welche die zwingende

Voraussetzung für das in Kapitel 4.3 vorausgesetzte Cycle-by-Cycle Current Limiting bildet.

C11

# 10nF GND

# GND GND GND +

3
- 4 V⁺

# 6 GND

### 2 REF 5

1

# INA181

# RSHUNT 1-milli-ohm/3W

+3.3V | R23

1k

# V_SENS

R23

1k +3.3V

# INA181 +

3
- 4 V⁺

# 6 GND

### 2 REF 5

1 GND GND | GND

C11
10nF

Abbildung 4.1: Schaltplan der Strommessung mit Shunt, INA181 und RC-Tiefpass.

# 4.3 Verlustanalyse

Die Dimensionierung des thermischen Managements erfordert eine präzise Quantifizierung

der Halbleiterverluste. Die nachfolgenden Berechnungen basieren auf dem geforderten Phasen-

Effektivstrom von Iphase,RMS = 30 A. Die Zwischenkreisspannung wird mit vi = 42 V angesetzt,

die Schaltfrequenz beträgt fsw = 20 kHz. Wie in der Systemarchitektur (vgl. Kapitel 3.1) de-

finiert, greift bei höheren transienten Strömen die aktive Cycle-by-Cycle-Strombegrenzung

ein. Eine thermische Überdimensionierung für theoretische Kurzschluss- oder Blockierfälle

ist daher nicht erforderlich, da der gemessene Motorstrom von der Firmware exakt auf diese

42,4 A limitiert wird. Da diese Begrenzung symmetrisch für den motorischen und den rekupe-

rativen Betrieb gilt, stellt dieser Arbeitspunkt den globalen thermischen Worst-Case für das

Gesamtsystem dar. Die analytische Herleitung folgt einem strukturierten Vorgehen. Zunächst

wird die physikalische Stromaufteilung in der Topologie analysiert, woraufhin die in Kapitel

2 definierten Verlustmodelle mit den Spezifikationen der ausgewählten Bauteile verknüpft

werden. Alle ausführlichen mathematischen Zwischenschritte sind in Anhang A.1 hinterlegt.

T3_3200 | Pascal Lauer | 4 Entwurf der Leistungselektronik

# 4.3.1 Statische Leitverluste der MOSFETs

Bei der sensorbasierten Blockkommutierung durchläuft jede Motorphase pro elektrischer

360◦

-Periode kontinuierlich drei Zustände: Sie leitet für 120◦

einen positiven Strom, ist für

120◦ hochohmig und dient für weitere 120◦

als Rückleiter für den negativen Strom. In der

vorliegenden Brückentopologie wird der Freilaufstrom während der PWM-Ausschaltphasen

jedoch nicht passiv der verlustbehafteten Body-Diode überlassen. Der gewählte Gate-Treiber

IR2104 verfügt über eine komplementäre Ansteuerlogik. Wird der High-Side-MOSFET (HS)

in der PWM-Logik abgeschaltet, steuert der Treiber nach einer kurzen Totzeit automatisch

den korrespondierenden Low-Side-MOSFET (LS) durch. Diese aktive Synchrongleichrichtung

führt zusammen mit der Blockkommutierung zu stark asymmetrischen Belastungsprofilen

der Transistoren. Im positiven 120◦

-Sektor taktet der HS-MOSFET mit dem Tastverhältnis

d und treibt die Energie in den Motor, während der komplementäre LS-MOSFET in der

Ausschaltphase für die Zeit (1 − d) den Freilaufstrom übernimmt. Im negativen 120◦
-Sektor ist

der HS-MOSFET hingegen permanent gesperrt, während der LS-MOSFET statisch zu 100 %

durchgeschaltet bleibt und den vollen Blockstrom als Rückleiter führt. Daraus lassen sich die

effektiven Quadratströme für den Dauerbetrieb ableiten:

I

2
HS,RMS = I

2
Block ⋅

1

3

⋅ d | (4.4)

I

2
LS,RMS = I

2
Block ⋅

1

3

⋅ (1 − d) + I

2
Block ⋅

1

3

⋅ 1 = I

2
Block ⋅

1

3

⋅ (2 − d) | (4.5)

Es wird ersichtlich, dass der LS-MOSFET thermisch deutlich stärker belastet wird als der

HS-MOSFET, da er sowohl Rückleiter- als auch Freilauffunktionen übernimmt. Dies gilt insbe-

sondere bei minimalen Tastverhältnissen unter Hochlast, beispielsweise bei einem schweren

Motoranlauf. Zur Bestimmung der Verlustleistung gemäß Gleichung 2.3 muss der tempera-

turabhängige Einschaltwiderstand RDS(on) ermittelt werden. Für eine konservative Auslegung

wird eine Worst-Case-Sperrschichttemperatur von TJ,design = 100◦C angenommen. Da der

Gate-Treiber eine Steuerspannung von vdr = 12 V bereitstellt, operieren die Transistoren si-

cher im tiefen Sättigungsbereich. Zur Ermittlung des exakten Widerstandswertes wurde die

Datenblattkennlinie grafisch ausgewertet. Wie in Abbildung 4.2 ersichtlich, beläuft sich der

Widerstand bei der Zieltemperatur auf RDS(on)(100◦C) ≈ 4,8 mΩ. Werden diese Werte in die

entsprechende Verlustgleichung (vgl. Kapitel 2.3.1) eingesetzt, ergibt sich für den HS-MOSFET

bei maximaler Aussteuerung (d = 1) eine statische Verlustleistung von PHS,c ≈ 2,88 W. Der

thermische Worst-Case des LS-MOSFETs tritt hingegen bei geringer Aussteuerung (d = 0) und

gleichzeitigem Anlauf-Blockstrom auf, was zu einer Verlustleistung von PLS,c ≈ 5,75 W führt.

Diese Analyse belegt analytisch, dass das thermische Design zwingend auf die signifikant

höhere Abwärme der LS-MOSFETs dimensioniert werden muss.

T3_3200 | Pascal Lauer | 4 Entwurf der Leistungselektronik

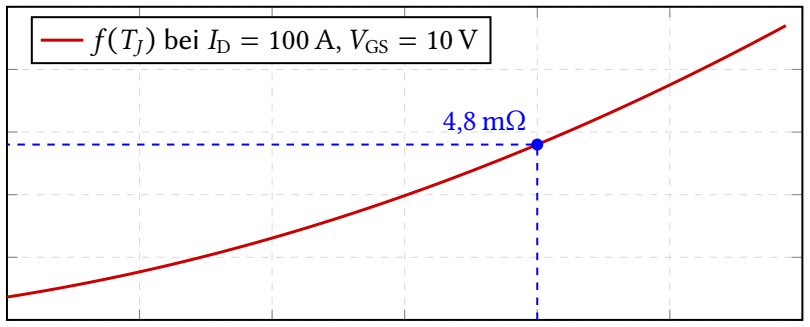
[picture p10: figure]
f (TJ) bei ID = 100 A, VGS = 10 V

−60 | −20 | 20 | 60 | 100 | 140 | 180

2

3

4

5

6

7

Sperrschichttemperatur TJ [

◦C]

# RDS(on),max [m

Ω]

Abbildung 4.2: Temperaturabhängigkeit des maximalen Einschaltwiderstands. Digitalisierte

Kennlinie nach [6, Diagramm 9].

# 4.3.2 Dynamische Schaltverluste der MOSFETs

Infolge der implementierten Kommutierungslogik entstehen signifikante Umschaltverluste

ausschließlich im HS-MOSFET. Der LS-MOSFET schaltet den Phasenstrom lediglich mit der

sehr niedrigen elektrischen Grundfrequenz des Motors, weshalb seine dynamischen Verluste

energetisch zu vernachlässigen sind. Der HS-MOSFET taktet hingegen mit der PWM-Frequenz

von fsw = 20 kHz, dies jedoch periodisch nur während seines aktiven 120◦

-Sektors. Im zeit-

lichen Mittel fallen folglich effektiv 1/3 ⋅ fsw harte Schaltvorgänge an. Die Berechnung der

Schaltverluste erfolgt über das in den theoretischen Grundlagen hergeleitete ladungsbasierte

Modell. Die Parameter zur Ermittlung der Schaltzeiten können dem Datenblatt [6] entnommen

werden. Die Millerspannung beträgt vGS,Mi = 5,0 V und die für die Schaltflanke maßgebliche

Umschaltladung liegt bei Qsw = 26 nC. Bei einer Treiberspannung von vdr = 12 V und einem

gewählten Gate-Vorwiderstand von RG = 10 Ω resultieren aus den Gleichungen 2.6 und 2.10

eine reine Einschaltenergie des MOSFETs von EMOS,on ≈ 33,1 μJ sowie eine Ausschaltenergie

von EMOS,off ≈ 46,3 μJ. Zusätzlich muss die Sperrverzögerungsladung der gegenüberliegenden

Body-Diode berücksichtigt werden. Die in der LS-Diode gespeicherte Ladung verursacht beim

Einschalten der Halbbrücke einen transienten Strompuls, der physikalisch im aktiven HS-

MOSFET dissipiert wird. Mit der maximalen Reverse-Recovery-Ladung von Qrr,max = 332 nC

addiert sich gemäß Gleichung 2.7 eine zusätzliche Einschaltenergie von Eon,rr ≈ 13,9 μJ. Die

gesamte transiente Einschaltenergie summiert sich somit auf Eon,total ≈ 47,0 μJ. Die gemittelten

dynamischen Schaltverluste pro HS-MOSFET berechnen sich folglich zu:

PMOS,sw = (Eon,total + EMOS,off) ⋅ fsw ⋅

1

3

≈ 0,62 W | (4.6)

T3_3200 | Pascal Lauer | 4 Entwurf der Leistungselektronik

Es ist anzumerken, dass die eigenen, internen Abschaltverluste der Diode (Prr), die häufig auf

1/4 ⋅Qrr ⋅vi
⋅ fsw geschätzt werden [5, S. 10], in dieser Auslegung im zeitlichen Mittel bei lediglich

rund 23 mW liegen. Verglichen mit den Leitverlusten fällt dieser Wert nicht ins Gewicht und

wird in der thermischen Dimensionierung vernachlässigt.

# 4.3.3 Leitverluste der Freilaufdiode

Dank der hardwareseitigen Synchrongleichrichtung übernimmt der niederohmige Kanal des

LS-MOSFETs nahezu den gesamten Freilaufstrom. Die intrinsische Body-Diode wird aus-

schließlich während der vom Gate-Treiber zwingend vorgegebenen Totzeit tdt leitend. Dieser

Mechanismus ist essenziell, um einen gleichzeitigen Leitzustand beider Transistoren und damit

einen Brückenkurzschluss (Shoot-Through) zu verhindern. Der Treiber IR2104 spezifiziert eine

interne Totzeit von tdt = 520 ns. Da dieser transiente Dioden-Stromfluss bei jedem PWM-

Umschaltvorgang auftritt, durchläuft die Diode exakt zwei Totzeit-Intervalle pro PWM-Periode.

Das effektive Tastverhältnis dD der Diode beträgt folglich lediglich dD ≈ 0,0208. Da der Strom

zudem nur im aktiven 120◦

-Sektor fließt, reduzieren sich der arithmetische Mittelwert auf

iD ≈ 0,294 A und der quadratische Effektivstrom auf i

2

## D,RMS ≈ 12,47 A²

. Zur Bestimmung der

in Gleichung 2.13 definierten Verlustleistung müssen die linearisierten Diodenparameter vD,0

und rD hergeleitet werden. Da die Durchlassspannung einen negativen Temperaturkoeffizi-

enten aufweist, wird die Datenblattkennlinie zur Worst-Case-Betrachtung bei 175◦C grafisch

ausgewertet. Um den realen Arbeitsbereich abzubilden, wird eine Sekante durch die typi-

sche Knickspannung (vD,0 = 0,58 V) und den Nenn-Arbeitspunkt des Blockstroms (42,4 A bei

vD ≈ 0,92 V) gelegt.

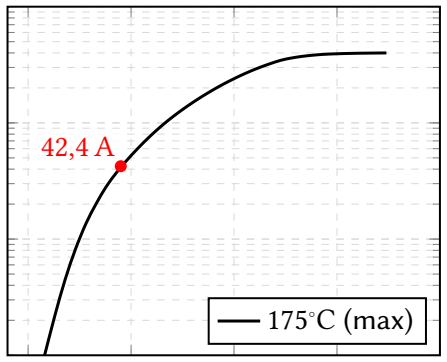
[picture p11: figure]
(max)

0.5 | 1 | 1.5 | 2 | 2.5

10⁰

10¹

10²

10³

Durchlassspannung vD [V]

# Durchlassstrom iD [A]

(a) Logarithmische Gesamtkennlinie
0.5 | 0.6 | 0.7 | 0.8 | 0.9 | 1

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
## ΔiD

rD =

ΔvD
ΔiD

42,4 A

vD,0 = 0,58 V

Durchlassspannung vD [V]

# Durchlassstrom iD [A]

Linearisierung

(b) Linearisierung am Arbeitspunkt

Abbildung 4.3: Analytische Auswertung der Body-Dioden-Kennlinie. Digitalisierte Kennlinie

nach [6, Diagramm 12].

T3_3200 | Pascal Lauer | 4 Entwurf der Leistungselektronik

Die grafische Herleitung in Abbildung 4.3 liefert über das Steigungsdreieck einen differentiellen

Widerstand von rD ≈ 8,0 mΩ. Werden diese Kennwerte eingesetzt, berechnen sich die statischen

Durchlassverluste der Body-Diode PD,c pro Halbbrücke zu:

PD,c = vD,0 ⋅ iD + rD ⋅ i

2

D,RMS = 0,58 V ⋅ 0,294 A + 0,008 Ω ⋅ 12,47 A² ≈ 0,27 W | (4.7)

Dieses Ergebnis zeigt, dass die Synchrongleichrichtung die thermische Belastung erheblich

reduziert. Die Verluste der Body-Diode fallen auf lediglich ca. 0,27 W und haben daher nur

einen geringen Einfluss auf die thermische Auslegung.

# 4.3.4 Zusammenfassung und thermische Anforderungen

Wie in Abschnitt 4.2 dargelegt, basiert die gesamte thermische Auslegung auf einem abgere-

gelten, maximalen Phasenstrom von 42,4 A. Um dieses Limit in der Praxis zu garantieren, ist

die dort beschriebene Signalaufbereitung in Kombination mit einem softwareseitigen Cycle-

by-Cycle Current Limiting zwingend erforderlich. Diese aktive Regelung schützt die MOSFETs

vor thermischer Zerstörung, indem sie das Tastverhältnis rechtzeitig reduziert. Tabelle 4.2

fasst die unter diesen Worst-Case-Bedingungen ermittelten Verlustleistungen für eine einzelne

Halbbrücke zusammen.

Tabelle 4.2: Zusammenfassung der Verlustleistungen pro Halbbrücke

Verlustart | Komponente | Leistung [W]
Statische Leitverluste | HS MOSFET (PHS,c) | 2,88
Dynamische Schaltverluste | HS MOSFET (PMOS,sw) | 0,62
Statische Leitverluste | LS MOSFET (PLS,c) | 5,75
Totzeit-Leitverluste | LS Body-Diode (PD,c) | 0,27
Gesamtverlustleistung | Pro Halbbrücke (PHB,total) | 9,52

Da der Motorcontroller aus drei identisch belasteten Halbbrücken besteht, resultiert bei

anhaltender Volllast (z. B. Schweranlauf oder Dauerblockade) eine kumulierte transiente Ge-

samtabwärme von annähernd 28,56 W. Die Abführung einer derart hohen Verlustleistung

auf einer stark begrenzten Leiterplattenfläche stellt höchste physikalische Anforderungen an

das Hardware-Design. Eine rein passive Entwärmung über Kupferflächen der Platine reicht

hierbei nicht mehr aus. Diese physikalischen Grenzen motivieren die in Kapitel 5 folgende

Dimensionierung eines dedizierten Kühlkörpers, welcher die Wärme zuverlässig aus dem

kompakten System abführt.

T3_3200 | Pascal Lauer | 4 Entwurf der Leistungselektronik

# 4.4 Gate-Treiber

Zur Ansteuerung der N-Kanal-MOSFETs in der B6-Brücke wird der Halbbrücken-Treiber

IR2104 eingesetzt [9]. Seine primäre Aufgabe besteht darin, die 3,3 V-Logiksignale des STM32-

Mikrocontrollers auf das benötigte Spannungsniveau von 12 V anzuheben, um die Transistoren

sicher in den tiefen Sättigungsbereich zu steuern. Der IR2104 zeichnet sich durch eine kom-

plementäre Ansteuerlogik aus [9]. Mit nur einem einzigen PWM-Eingangssignal (IN) steuert

der Baustein sowohl den HS- als auch den inversen LS-Ausgang (HO und LO). Diese interne

Logik erzwingt hardwareseitig die Umsetzung der aktiven Synchrongleichrichtung, bei der der

LS-MOSFET während der PWM-Ausschaltphase den Freilaufstrom übernimmt und so die ther-

mische Belastung der Systemarchitektur im Vergleich zur passiven Freilaufdiode maßgeblich

reduziert. Ein kritischer Aspekt bei der Verwendung einer komplementären Ansteuerung ist die

Vermeidung eines gleichzeitigen Leitzustands beider Transistoren einer Halbbrücke, was unwei-

gerlich zu einem zerstörerischen Kurzschluss (Shoot-Through) im Zwischenkreis führen würde.

Um dies abzusichern, verfügt der IR2104 über eine fest integrierte Totzeit (Deadtime) von typi-

scherweise tdt = 520 ns [9]. Während dieses transienten Intervalls bei jedem Umschaltvorgang

bleiben zwingend beide Gate-Ausgänge auf einem niedrigen Pegel, sodass der Phasenstrom

in dieser Zeitspanne sicher über die Body-Diode des LS-MOSFETs abfließt. Darüber hinaus

integriert der Treiber wesentliche Schutzfunktionen für den zuverlässigen Betrieb der Leistungs-

endstufe. Eine Unterspannungsabschaltung überwacht kontinuierlich die Versorgungs- und

Bootstrap-Spannung. Fällt das Potenzial unter einen definierten Schwellenwert, sperrt der Trei-

ber die Ausgänge [9]. Dies verhindert, dass die MOSFETs mit unzureichender Gate-Spannung

betrieben werden, was andernfalls zu einem drastischen Anstieg des Einschaltwiderstands

und folglich zur thermischen Zerstörung durch erhöhte Leitverluste führen würde.

Zusätzlich verfügt der IR2104 über einen invertierten Shutdown-Eingang (SD), der direkt an

die Hardware-Enable-Logik des STM32 angebunden ist [9]. Diese Schnittstelle ermöglicht es

der Firmware, im Falle eines erkannten Systemfehlers, wie beispielsweise einem physikalisch

unplausiblen Hall-Sensor-Zustand, alle Gate-Treiber verzögerungsfrei zu deaktivieren und die

vorgesehene Notabschaltung (Emergency Stop) durchzusetzen.

# 4.5 Bootstrap-Schaltung

Für die Ansteuerung der HS-MOSFETs in der Halbbrücke wird ein Bootstrap-Konzept ver-

wendet, bei dem ein Kondensator als kurzzeitige, schwimmende Spannungsquelle fungiert.

Dieser Bootstrap-Kondensator wird während der Leitphase des LS-MOSFETs aufgeladen und

liefert die notwendige Energie, um das Gate des HS-MOSFETs vollständig durchzusteuern. Ist

die Bootstrap-Schaltung unzureichend dimensioniert, fällt die Gate-Spannung während der

Einschaltzeit des HS-MOSFETs unter den Schwellenwert. Dies würde zu einem drastischen

T3_3200 | Pascal Lauer | 4 Entwurf der Leistungselektronik

Anstieg der Leitverluste oder zum Auslösen der Unterspannungsabschaltung des Treibers

führen. Die Dimensionierung des Bootstrap-Kondensators basiert auf der Gesamtladung, die

während einer Schaltperiode bereitgestellt werden muss. Diese setzt sich aus der Gate-Ladung

des MOSFETs, dem Energiebedarf des Level-Shifters im Treiber sowie den Verlusten durch

transiente Leckströme zusammen. Für die vorliegende Schaltung mit dem MOSFET und dem

Treiber wurde die Berechnung auf Basis der Datenblätter sowie der Applikationsschrift AN-

6076 [3] durchgeführt. Hierbei wurden alle relevanten Parameter, wie extrapoliertem QGate,

parasitäre Leckströme und die maximale Einschaltdauer im Worst-Case berücksichtigt. Die

detaillierte Berechnung des Bootstrap-Netzwerks inklusive aller Zwischenwerte ist in Anhang

A.2 dokumentiert. In Tabelle 4.3 sind die Größen der Dimensionierung zusammengefasst:

Tabelle 4.3: Parameter zur Dimensionierung des Bootstrap-Kondensators

Größe | Symbol | Wert
Gesamt-Gateladung (extrapoliert auf 15 V) | QGate | 111 nC
Level-Shifter-Ladung (Treiber) | QLS | 3 nC
Leckstromladung während ton,max | QLeak | 5,8 nC
Benötigte Gesamtladung | QTotal | ≈ 120 nC
Zulässiger Spannungsabfall am Kondensator | ΔVBOOT | 1,0 V
Errechnete Minimalkapazität | CBOOT,min | 120 nF

Auf Basis dieser Analyse wurde für die praktische Umsetzung ein Keramikkondensator mit

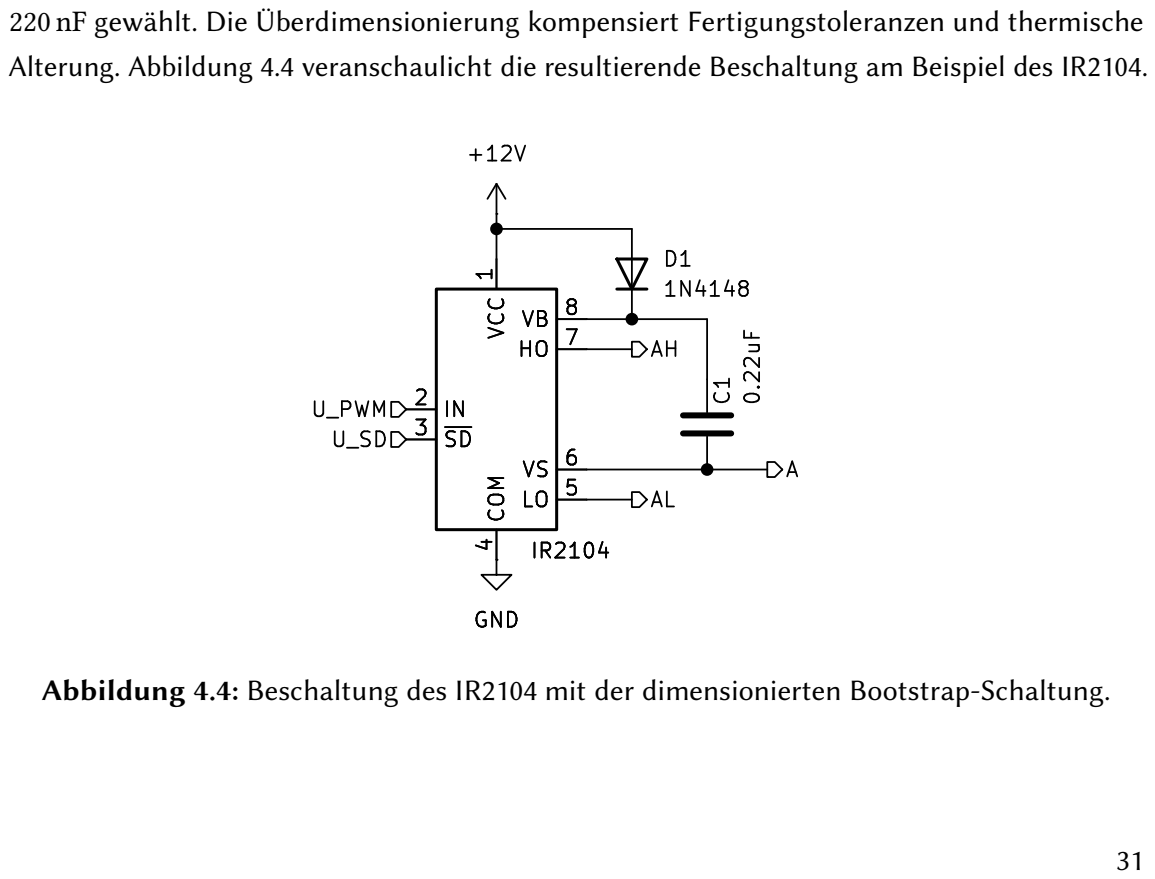
[picture p12: figure]
VCC; 1 COM 4 VB 8 HO 7 VS 6; GND; U_PWM U_SD; LO 5 GND

220 nF gewählt. Die Überdimensionierung kompensiert Fertigungstoleranzen und thermische

Alterung. Abbildung 4.4 veranschaulicht die resultierende Beschaltung am Beispiel des IR2104.

Abbildung 4.4: Beschaltung des IR2104 mit der dimensionierten Bootstrap-Schaltung.

T3_3200 | Pascal Lauer | 4 Entwurf der Leistungselektronik

# 4.6 Auslegung des Zwischenkreises

Der Gleichspannungszwischenkreis verbindet die Akkumulator-Stromversorgung mit der

B6-Brücke, die hochfrequent getaktet wird. Da die parasitären Leitungsinduktivitäten des

36 V-Akkumulators eine verzögerungsfreie Bereitstellung der steilflankigen Motorströme phy-

sikalisch verhindern, muss die Energie lokal auf der Leiterplatte gepuffert werden. Andernfalls

käme es zu massiven Spannungseinbrüchen im Takt der Schaltfrequenz. Die Dimensionierung

des Zwischenkreises gliedert sich primär in die Auslegung der Kapazitäten zur Ripple-Strom-

Pufferung sowie die hochfrequente Entkopplung der Leistungstransistoren.

# 4.6.1 Spannungsreserve und Kapazität

Wie in den Systemanforderungen (vgl. Abschnitt 3.1) definiert, beträgt die maximale Lade-

schlussspannung des Akkumulators 42 V. Zur Gewährleistung eines sicheren Betriebs auch

im rekuperativen Modus, in dem die Spannung im Zwischenkreis dynamisch ansteigen kann,

werden ausnahmslos Elektrolytkondensatoren (Elkos) mit einer Nennspannungsfestigkeit

von 63 V eingesetzt. Dies erfüllt die geforderte Spannungsreserve von mindestens 60 V. Bei

der Auslegung der Elkos für Motorinverter ist weniger der absolute Kapazitätswert entschei-

dend als vielmehr die zulässige Ripple-Strom-Belastbarkeit (Ripple Current Rating) sowie ein

minimaler äquivalenter Serienwiderstand (ESR). Die taktenden Halbbrücken generieren bei

einem Blockstrom von IBlock = 42,4 A erhebliche Wechselstromanteile im Zwischenkreis. Ein

zu hoher ESR würde quadratisch (PESR = I

2
Ripple ⋅ RESR) zu einer massiven Eigenerwärmung

und langfristig zur Austrocknung oder Zerstörung der Kondensatoren führen. Um den gefor-

derten Effektivstrom aufzuteilen und den parasitären Gesamtwiderstand der Anordnung zu

minimieren, wird statt eines einzelnen großen Kondensators eine Parallelschaltung mehrerer

impedanzarmer Aluminium-Elektrolytkondensatoren realisiert.

# 4.6.2 Kapazitive Entkopplung und Transientenbegrenzung

Trotz eines niedrigen ESR weisen Elkos bauartbedingt eine parasitäre Serieninduktivität (ESL)

auf, weshalb sie hochfrequente Schalttransienten im Megahertz-Bereich nur unzureichend

filtern. Bei der Kommutierung der hohen Phasenströme (di/dt) erzeugen bereits kleinste

Streuinduktivitäten im Leiterplattenlayout signifikante Überspannungsspitzen. Um die MOS-

FETs vor dem Überschreiten ihrer 80 V-Durchbruchspannung zu schützen, ist eine konsequente

kapazitive Entkopplung unerlässlich. Hierfür werden X7R-Keramikkondensatoren mit typi-

schen Werten von 1 μF und 100 nF möglichst nahe an den Drain- und Source-Anschlüssen der

jeweiligen Halbbrücken platziert. Durch ihre extrem geringe Impedanz bei hohen Frequenzen

schließen sie die transienten Spannungsspitzen lokal kurz, stabilisieren das Schaltverhalten

T3_3200 | Pascal Lauer | 4 Entwurf der Leistungselektronik

der MOSFETs und reduzieren parallel leitungsgebundene EMV-Störaussendungen des Gesamt-

systems. Darüber hinaus ist auch die Versorgungsspannung der Gate-Treiber (IR2104) direkt

am VCC-Pin mit Keramikkondensatoren von 100 nF und 1 μF zu entkoppeln. Dies reduziert die

VCC-Impedanz bei schnellen Schaltflanken und gewährleistet ein sauberes und störungsfreies

Umschaltverhalten der Treiber, was wiederum den Gesamtwirkungsgrad und die Zuverlässig-

keit der Halbbrücken verbessert. Die praktische Umsetzung der hochfrequenten Entkopplung

auf der Leiterplatte ist in Abbildung 4.5 zusammengefasst.

+12V

C6
10uF
+3.3V | +12V GND

C12
100nF | GND | GND

C2

# 10uF GND

# GND

C3
10uF

+12V

## AGND GND

# Impedanzkopplung

In die | þÿNähevom OPV | In die | þÿNähevom Gate | Treiber
AGND GND | GND

Abbildung 4.5: Hochfrequente Entkopplung der Logik- und Treiberspannungen.

# 5 Thermische Auslegung

Um die Betriebssicherheit der Endstufe zu gewährleisten, ist es notwendig, die thermische

Auslegung systematisch zu betrachten. Dies beinhaltet die Abschätzung der maximalen Sperr-

schichttemperatur der Halbleiter und die Dimensionierung des Kühlkörpers, sodass die Ver-

lustleistung zuverlässig abgeführt wird.

# 5.1 Wärmewiderstandsmodell

Um die Betriebssicherheit der Endstufe zu gewährleisten, muss sichergestellt werden, dass

die maximal zulässige Sperrschichttemperatur TJ,max der Halbleiter unter keinen Umständen

überschritten wird. Hierzu wird ein stationäres thermisches Widerstandsmodell herange-

zogen. Es wird angenommen, dass die in der Sperrschicht entstehende Verlustleistung Ptot

als Wärmestrom von der innersten Wärmequelle (Junction) über verschiedene thermische

Widerstände Rth bis zur Umgebungsluft (Ambient) abgeführt wird. Im eingeschwungenen, sta-

tionären Zustand lässt sich die resultierende Sperrschichttemperatur nach folgender Gleichung

berechnen:

TJ = TA + Ptot ⋅ (Rth,JC + Rth,CS + Rth,SA) | (5.1)

Die partiellen Wärmewiderstände beschreiben dabei folgende physikalische Übergänge:

- Rth,JC (Junction-to-Case): Innerer Wärmewiderstand des MOSFET-Gehäuses (zwischen

Sperrschicht und Gehäuse), im Datenblatt des IPP034N08N5 mit maximal Rth,JC =

0,9 K/W angegeben.

- Rth,CS (Case-to-Sink): Thermischer Übergangswiderstand zwischen Gehäuse und Kühl-

körper, bestimmt durch das Montagematerial. Für die verwendeten Silikon-Isolierpads

ist ein Wert von Rth,CS = 0,45 K/W angegeben.

- Rth,SA (Sink-to-Ambient): Thermischer Widerstand des Kühlkörpers zur umgebenden

Luft, abhängig von Oberfläche, Geometrie und Luftstrom.

Dieses thermische System kann analog zu einem elektrischen Netzwerk in einem thermischen

ESB abgebildet werden (siehe Abbildung 5.1). Die Temperaturdifferenzen ergeben sich dabei

analog zur Ohmschen Beziehung als Produkt aus Wärmestrom und Wärmewiderstand.

T3_3200 | Pascal Lauer | 5 Thermische Auslegung

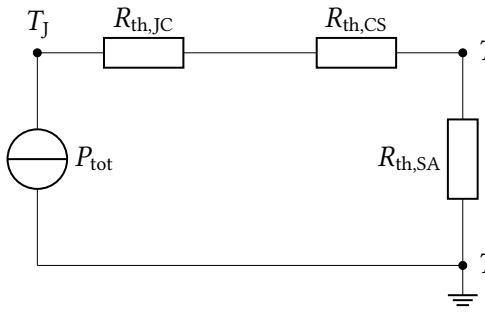
[picture p13: figure]
Ptot; Rth,JC; Rth,CS; Rth,SA

TS

TA

Abbildung 5.1: Stationäres thermisches ESB eines gekühlten MOSFETs.

# 5.2 Bestimmung des thermischen Anforderungsprofils

Auf Basis der Verlustanalyse aus Abschnitt 4.3 wird für die thermische Dimensionierung die

kumulierte Verlustleistung der drei Halbbrücken im Worst-Case-Betriebspunkt herangezo-

gen. Die Gesamtabwärme des Inverters beträgt Ptot = 28,56 W. Ziel der Auslegung ist es,

die Sperrschichttemperatur des thermisch kritischsten LS-MOSFETs (PLS = 6,02 W) bei ei-

ner maximalen Umgebungstemperatur von TA,max = 40 ◦C unterhalb der Designgrenze von

TJ,design = 100 ◦C zu halten. Durch Umformung von Gleichung (5.1) ergibt sich der maximal

zulässige Wärmewiderstand des Kühlkörpers Rth,SA,max zu:

Rth,SA,max =

TJ,design − TA,max − PLS ⋅ (Rth,JC + Rth,CS)

## Ptot

(5.2)

Eingesetzt ergibt sich:

Rth,SA,max =

## 100 ◦C − 40 ◦C − 6,02 W ⋅ (0,9 K/W + 0,45 K/W)

28,56 W

≈ 1,82 K/W | (5.3)

Diese Berechnung belegt, dass für einen dauerhaften Betrieb unter theoretischen Volllast-

Bedingungen ein leistungsfähiger Kühlkörper mit einem Wärmewiderstand von ≤ 1,82 K/W

erforderlich ist.

# 5.3 Kritische Bewertung des Hardwareaufbaus

Die Gegenüberstellung der theoretischen Anforderungen mit der physischen Umsetzung des

Prototyps zeigt, dass die angestrebte rein passive Kühlung nicht ausreicht. Für einen sicheren

Dauerbetrieb im Worst-Case-Betriebspunkt ist ein maximal zulässiger Wärmewiderstand

des Kühlkörpers von Rth,SA,max ≈ 1,82 K/W erforderlich, wie in Abschnitt 5.2 berechnet. Der

eingesetzte Aluminium-Rippenkühlkörper, dessen Konstruktion in Abbildung 5.2 maßstäblich

dargestellt ist, erreicht bei seinen kompakten Abmessungen von 78 × 20 × 10 mm unter rein

passiver Konvektion jedoch nur einen geschätzten Wert von Rth,SA,passiv ≈ 12 K/W.

T3_3200 | Pascal Lauer | 5 Thermische Auslegung

Daraus folgt unmittelbar, dass die in Kapitel 3 als Ziel gesetzte rein passive Entwärmung bei

einer dauerhaften Verlustleistung von 28,56 W physikalisch nicht in der Lage ist, die Sperr-

schichttemperaturen unterhalb der Designgrenze von 100 ◦C zu stabilisieren. Ohne zusätzliche

Maßnahmen würde die Gehäusetemperatur im Volllastbetrieb rechnerisch Werte erreichen,

die weit über der Schmelztemperatur der verwendeten Isoliermaterialien liegen.

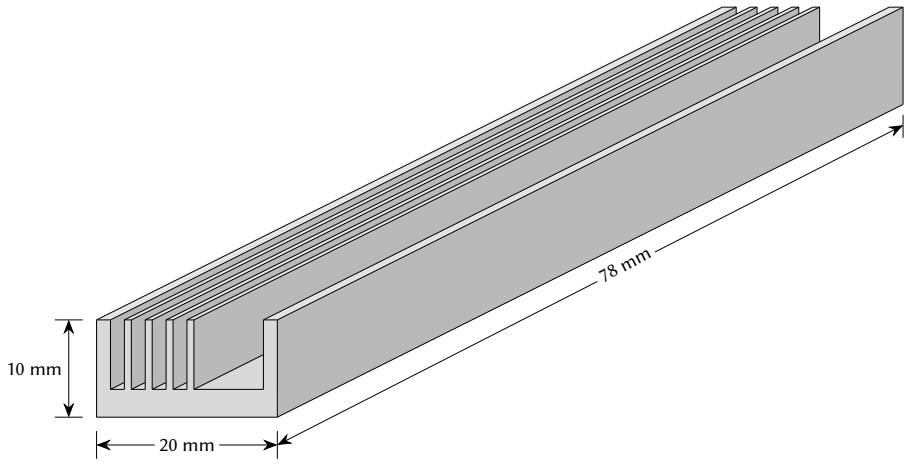
[picture p14: figure]

Abbildung 5.2: Technische Darstellung des Aluminium-Rippenkühlkörpers.

Dass sich das Gesamtsystem unter realen Betriebsbedingungen dennoch stabil betreiben lässt,

ist primär auf zwei wesentliche Faktoren zurückzuführen. Zum einen tritt die berechnete

maximale Verlustleistung ausschließlich bei Erreichen des aktiven Stromlimits von 42,4 A auf,

beispielsweise während eines Schweranlaufs oder im Falle einer mechanischen Blockade. In

diesen zeitlich begrenzten Intervallen wirkt die thermische Zeitkonstante des massiven Alu-

miniumblocks als Puffer, der den Temperaturanstieg über mehrere Sekunden verzögert. Zum

anderen erfährt der Motorcontroller eine signifikante thermische Entlastung durch parasitäre

Kühlpfade, die in der konservativen Rechnung unberücksichtigt blieben. So verteilt die großflä-

chige Anbindung der MOSFETs an die internen Masseflächen (GND-Planes) der Leiterplatte

die Abwärme effektiv, während die massiven Kupferquerschnitte der Motor- und Batteriezulei-

tungen als zusätzliche Kühlkörper fungieren. Um die Betriebssicherheit jedoch auch bei länger

anhaltenden Hochlastphasen zweifelsfrei zu garantieren, wurde im Rahmen dieser Evaluation

die Entscheidung getroffen, das Systemkonzept um eine aktive Belüftung mittels eines Axial-

lüfters zu ergänzen. Durch die erzwungene Konvektion sinkt der effektive Wärmewiderstand

des Kühlkörpers in Abhängigkeit von Lüfterleistung und Luftgeschwindigkeit auf den Zielwert

Rth,SA,aktiv ≈ 1,5 K/W, sodass die Sperrschichttemperaturen der Leistungshalbleiter sicher in

den geforderten Zielbereich geführt werden.

T3_3200 | Pascal Lauer | 5 Thermische Auslegung

# 5.4 Zusammenfassung der thermischen Analyse

Die thermische Analyse verdeutlicht, dass eine rein passive Kühlung für den theoretischen

Worst-Case-Betrieb bei der vorliegenden Baugröße physikalisch nicht haltbar ist. Die Realisier-

barkeit des Projekts wird stattdessen durch ein mehrstufiges Sicherheitskonzept ermöglicht,

welches erst durch die hier durchgeführte Evaluation finalisiert wurde. Die softwareseitige

Cycle-by-Cycle-Strombegrenzung limitiert die maximale elektrische Belastung primär, die

thermische Trägheit der Komponenten überbrückt transiente Lastspitzen, und die im Desi-

gnprozess ergänzte aktive Belüftung stellt die notwendige Wärmeabfuhr für den stationären

Betrieb sicher. Damit verbleiben die Leistungshalbleiter auch unter ungünstigen thermischen

Randbedingungen sicher innerhalb ihrer spezifizierten SOA.

# 6 Aufbau und Messungen

Dieses Kapitel dokumentiert die praktische Umsetzung und Verifikation des in den vorherigen

Kapiteln theoretisch ausgelegten Motorcontrollers.

# 6.1 Hardwareaufbau und iterative Prototypentwicklung

Die Entwicklung der Hardware erfolgte in zwei Phasen, um das Risiko von Beschädigungen

durch Softwarefehler zu minimieren.

# 6.1.1 Proof of Concept (Steckbrett-Aufbau)

Aufgrund von Verzögerungen im internen Beschaffungsprozess wurde der erste Prototyp

mit Komponenten aus einer alten Hoverboard-Endstufe realisiert, um den Zeitplan nicht zu

gefährden. Hierfür kamen N-Kanal-MOSFETs des Typs K4145 sowie Halbbrückentreiber vom

Typ FD2103S zum Einsatz, welche für den experimentellen Aufbau auf SMD-Adapterplatinen

gelötet wurden. Die Verdrahtung auf dem Steckbrett erfolgte strikt nach der in Kapitel 4

dimensionierten Topologie. Für die erste funktionale Validierung der Kommutierungslogik

wurde initial ein Arduino DUE als Mikrocontroller verwendet, bevor das System auf die

finale Architektur des STM32 (NUCLEO-G431RB) migriert wurde. Abbildung 6.1 zeigt diesen

Laboraufbau mit dem angeschlossenen BLDC-Motor.

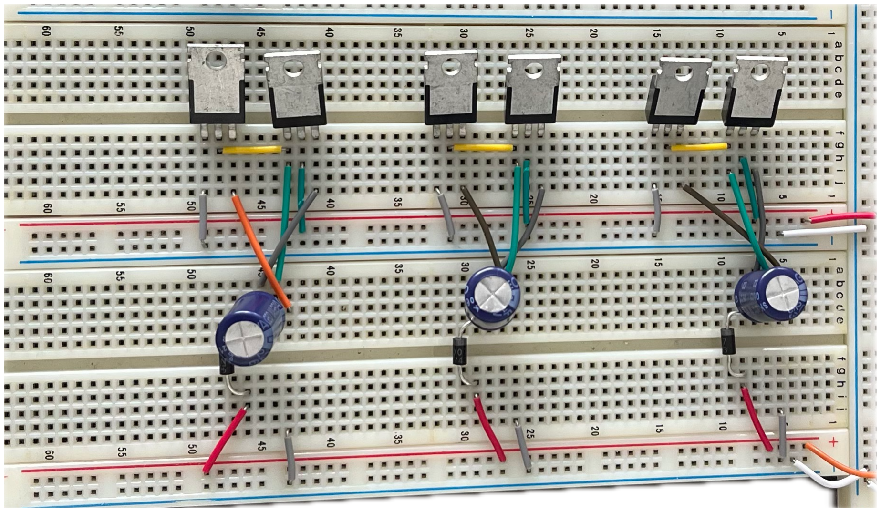
[picture p15: figure]

Abbildung 6.1: Steckbrett-Prototyp zur softwareseitigen Validierung des BLDC-Controllers.

T3_3200 | Pascal Lauer | 6 Aufbau und Messungen

Zur Vermeidung thermischer Überlastungen der limitierten Steckbrett-Kontakte erfolgten

sämtliche Tests zwingend an einem strombegrenzten Labornetzteil. Dies ermöglichte eine

gefahrlose Charakterisierung des Motorleerlaufstroms sowie die sichere Verifikation durch die

Strombegrenzung. Nachdem die finalen IR2104-Gate-Treiber zur Verfügung standen, wurde die

Hardware aktualisiert. Aufgrund anhaltender Lieferverzögerungen der IPP034N08N5-MOSFETs

wurden die ausgiebigen Softwaretests der Steuerlogik (vgl. Kapitel 3.3) jedoch weiterhin mit

den Bestandshalbleitern abgeschlossen. Der finale Code des STM32 ist zur vollständigen

Nachvollziehbarkeit in Anhang A.4 dokumentiert. Die erfolgreiche Inbetriebnahme dieses

Aufbaus bestätigte das theoretische Softwarekonzept in der Praxis. Eine strikte softwareseitige

Begrenzung des Tastverhältnisses auf 5 % bis 95 % stellte die kontinuierliche Umladung der

Bootstrap-Kondensatoren sicher und verhinderte Stottern beim Anlauf. Ein kritischer Fokus lag

auf der Überprüfung der internen Deadtime von 520 ns. Selbst bei hochdynamischen Last- und

Sollwertsprüngen traten keine unzulässigen Brückenkurzschlüsse auf. Bei einer Strombegren-

zung des Labornetzteils auf 5 A zeigte das System ein robustes Kommutierungsverhalten, ohne

dass die Schutzmechanismen ungewollt auslösten. Nach der erfolgreichen Validierung der

Gate-Signale und der Phasenströme am Steckbrett mit dem Oszilloskop wurde die Topologie

für den Hochstrombetrieb in einen verlöteten Lochrasterprototypen überführt, welcher im

nachfolgenden Abschnitt beschrieben wird.

# 6.1.2 Leistungsprototyp (Lochraster-Aufbau)

Zur Evaluierung des Systems unter höheren Lastbedingungen wurde die verifizierte Schal-

tungstopologie im nächsten Entwicklungsschritt auf eine Lochrasterplatine überführt. Auf-

grund anhaltender Lieferengpässe der spezifizierten IR2104-Gate-Treiber erfolgte die initiale

Bestückung ebenfalls mit den temporären FD2103S-Bausteinen auf SMD-Adaptern. Bei der ers-

ten Inbetriebnahme dieses Aufbaus führte eine fehlerhafte Lötverbindung zu einem parasitären

Brückenkurzschluss, was die sofortige thermische Zerstörung von zwei Treiberbausteinen zur

Folge hatte und den Testfortschritt mangels Ersatzteilen verzögerte. Nach dem Eintreffen der

finalen Komponenten wurde die Leistungsendstufe vollständig auf die in Kapitel 4 dimensio-

nierten IR2104-Treiber migriert. Um erneute Defekte auszuschließen, wurde die überarbeitete

Platine vor der erneuten Inbetriebnahme einer detaillierten optischen Inspektion sowie einer

elektrischen Durchgangsprüfung unterzogen. Da eine konventionelle Lochrasterplatine ther-

misch und elektrisch nicht für die anvisierten Phasenströme von bis zu 42,4 A ausgelegt ist,

wurden sämtliche Hochstrompfade auf der Unterseite mit Kupferdrahteinlagen und großflä-

chigen Lötzinnverbindungen verstärkt. Dies betrifft primär die Zwischenkreisversorgung sowie

die Phasenabgänge. Abbildung 6.2 zeigt den vollständigen Aufbau des Leistungsprototyps

in der Drauf- und Unteransicht. Die anschließende hardwarenahe Inbetriebnahme erfolgte

stufenweise an einem strombegrenzten Labornetzteil, um bei eventuellen Fehlkommutierungen

T3_3200 | Pascal Lauer | 6 Aufbau und Messungen

Folgeschäden abzuwenden, bevor der uneingeschränkte Betrieb am Akkumulator freigegeben

wurde. Umfassende Dauerlastversuche bei Nennstrom zur finalen Evaluierung des passiven

Kühlkonzepts konnten aus thermischen Gründen sowie im zeitlichen Rahmen des Projektum-

fangs nicht vollständig am Prüfstand durchgeführt werden. Aus diesem Grund beschränken

sich die nachfolgenden thermischen Validierungen auf reduzierte Lastprofile.

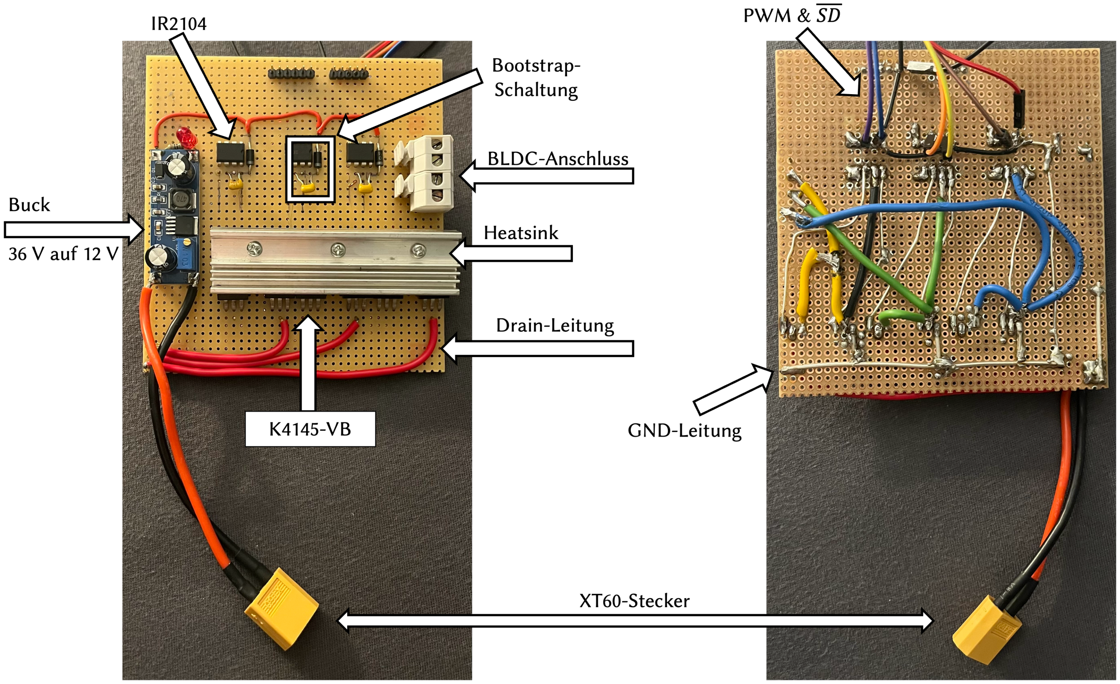
[picture p16: figure]

Abbildung 6.2: Der finale Leistungsprototyp auf Basis einer Lochrasterplatine.

# 6.2 Inbetriebnahme und Schutzfunktionen

Die erste Inbetriebnahme des Leistungsteils erfolgte iterativ und unter strikten Sicherheitsvor-

kehrungen, um Hardwareschäden durch unentdeckte Softwarefehler zu vermeiden. Zunächst

wurde der Zwischenkreis nicht mit dem nominellen 36 V-Akkumulator, sondern mit einem

auf 12 V und 2 A strombegrenzten Labornetzteil gespeist. In diesem sicheren Arbeitspunkt

konnte das grundsätzliche Kommutierungsverhalten der Brücke sowie die ordnungsgemäße

Stromaufnahme der Gate-Treiber im Leerlauf verifiziert werden. Ein essenzieller Teil der Inbe-

triebnahme war die Validierung der in Kapitel 3.3 beschriebenen Schutzfunktionen. Hierbei

wurde primär die Emergency-Stop-Routine getestet. Durch das softwareseitige Herabsetzen

des Sollwerts (Poti-Eingang < 5 %) wurden die Shutdown-Pins (SD) der IR2104-Treiber durch

den Mikrocontroller bestimmungsgemäß auf ein Low-Potenzial gezogen. Dies versetzte alle

MOSFETs unverzüglich in den hochohmigen Zustand und bewies die Funktionsfähigkeit des

implementierten Fail-Safe-Konzepts vor dem Anlegen hoher Lastströme.

T3_3200 | Pascal Lauer | 6 Aufbau und Messungen

# 6.3 Elektrische Charakterisierung

Zur Verifikation der Schaltvorgänge wurden Messungen mit einem Digitaloszilloskop im

laufenden Betrieb durchgeführt. Um Kurzschlüsse über erdbezogene Oszilloskop-Massen zu

vermeiden, erfolgten die Messungen massebezogen direkt am Gate-Ausgang (LO) des IR2104-

Treibers der Phase U. Anhand dieses Signals lassen sich sowohl das transiente Flankenverhalten

als auch die drei Zustände der Kommutierung präzise analysieren. Die im Gate-Treiber hard-

wareseitig integrierte Totzeit von 520 ns stellt den Kurzschlussschutz der Halbbrücke hierbei

konstruktiv sicher.

# 6.3.1 Transientes Schaltverhalten und Gate-Widerstand

Um das dynamische Schaltverhalten der MOSFETs und die korrekte Dimensionierung des

Gate-Vorwiderstands (RG = 10 Ω) zu validieren, wurde die steigende Schaltflanke hochauf-

lösend abgetastet. Um das Messrauschen für die Auswertung zu bereinigen, wurden die

Rohdaten exportiert und in Abbildung 6.3 dargestellt. Das entsprechende Oszillogramm ist zur

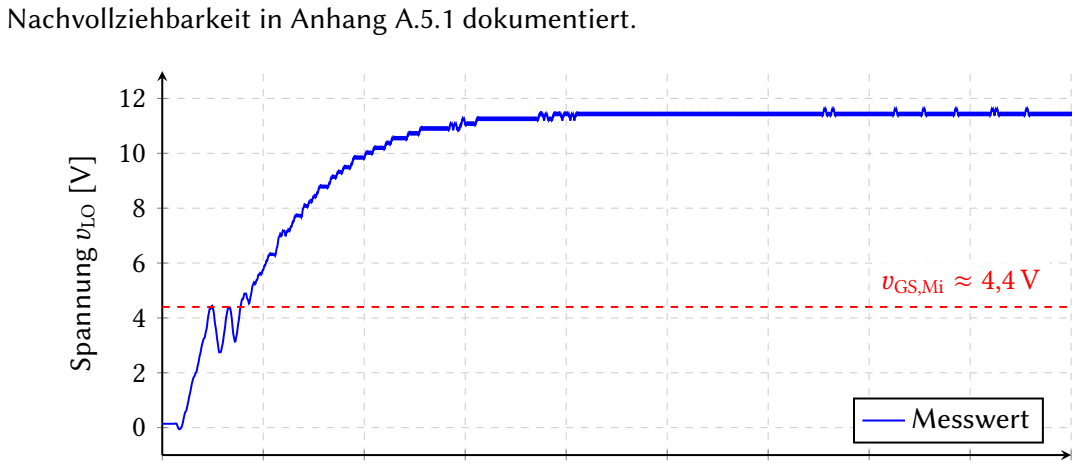
[picture p17: figure]
Nachvollziehbarkeit in Anhang A.5.1 dokumentiert.; vGS,Mi ≈ 4,4 V; Spannung vLO [V]; Messwert

−0.5 | 0 | 0.5 | 1 | 1.5 | 2 | 2.5 | 3 | 3.5 | 4

## Zeit t [μs]

Abbildung 6.3: Darstellung der steigenden Schaltflanke am LS-Gate.

Das Oszillogramm zeigt den stetigen Spannungsanstieg auf das Niveau der Treiberspannung.

Die erreichte Maximalspannung von ca. 11,5 V resultiert aus dem internen Spannungsabfall

der Treiber-Endstufe gegenüber der 12 V-Versorgung. Im dynamischen Umschaltbereich zwi-

schen t ≈ −0,3 μs und 0,1 μs wird das charakteristische Miller-Plateau durchlaufen. Wie in der

Verlustanalyse (vgl. Abschnitt 4.3.2) dargelegt, beträgt die theoretische Millerspannung gemäß

Spezifikation vGS,Mi = 5,0 V [6]. Im gemessenen Verlauf flacht der Spannungsanstieg jedoch be-

reits bei etwa 4,4 V ab. Diese Abweichung lässt sich physikalisch begründen. Der Datenblattwert

T3_3200 | Pascal Lauer | 6 Aufbau und Messungen

bezieht sich auf den vollen Nennstrom der Halbleiter. Da die Messung zur sicheren Inbetrieb-

nahme bei einem wesentlich geringeren Phasenstrom erfolgte, sinkt das Spannungsniveau, bei

dem der Transistor den Laststrom übernimmt, entsprechend ab. Zudem erfasst die Oszillo-

skopmessung gegen die zentrale Masse nicht ausschließlich die reine Gate-Source-Spannung,

sondern addiert den transienten induktiven Spannungsabfall der Source-Zuleitungen auf der

Lochrasterplatine, was die sichtbaren Schwingungen in der Umschaltphase verursacht. Trotz

des induktiven Prototypenaufbaus belegt der Kurvenverlauf die Wirksamkeit des gewählten

Gate-Widerstands. Die Flankensteilheit wird ausreichend begrenzt, sodass die auftretenden

Schwingungen stark gedämpft bleiben. Kritische Spannungsüberschwinger, die das Gate-Oxid

gefährden könnten, werden somit sicher vermieden.

# 6.3.2 Verifikation der Kommutierungszustände

Die korrekte Umsetzung der in Kapitel 3 definierten Firmware-Architektur lässt sich an den drei

zyklischen Betriebszuständen des LS-MOSFETs verifizieren. Um die drei aufeinanderfolgenden

120◦

-Sektoren eines elektrischen Umlaufs vergleichend zu analysieren, wurden die Oszilloskop-

Rohdaten vektorisiert und in Abbildung 6.4 übereinandergelegt. Die zugehörigen originalen

Oszillogramme sind zur vollständigen Dokumentation in Anhang A.5.2 hinterlegt.

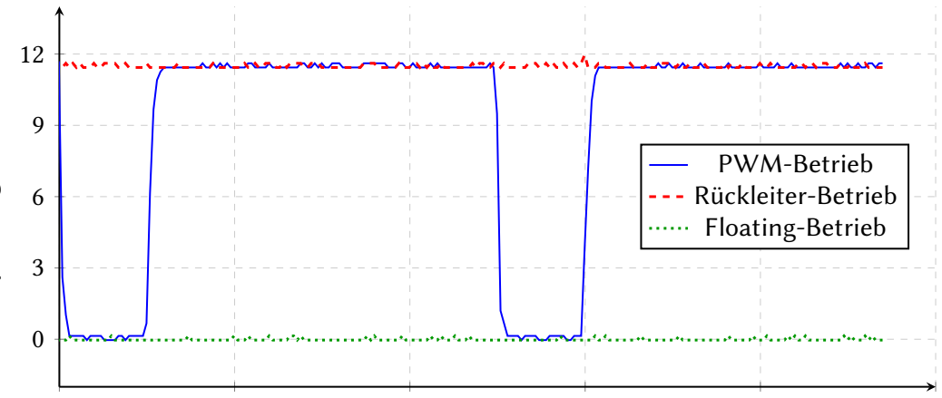
[picture p18: figure]
PWM-Betrieb Rückleiter-Betrieb; Floating-Betrieb

−10 | 10 | 30 | 50 | 70 | 90

## Zeit t [μs]

# Spannung vLO [V]

Abbildung 6.4: Gegenüberstellung der drei Kommutierungszustände am LS-Gate.

Die übereinandergelegten Messreihen belegen das einwandfreie Zusammenspiel zwischen

der STM32-Software und dem Gate-Treiber. Befindet sich die Phase im bestromten, positiven

Sektor (blaue Kurve), taktet der Mikrocontroller das PWM-Signal mit einer Frequenz von

exakt 20 kHz, was sich in der gemessenen Periodendauer von 50 μs widerspiegelt. Aufgrund

der komplementären Ansteuerlogik des IR2104-Treibers wird der LS-MOSFET in der PWM-

Ausschaltphase der HS aktiv durchgesteuert. Dadurch ist die in Abschnitt 4.3.1 geforderte

T3_3200 | Pascal Lauer | 6 Aufbau und Messungen

verlustarme Synchrongleichrichtung messtechnisch nachgewiesen. Wechselt die Motorphase in

den negativen Sektor (rote Kurve), fungiert sie als dedizierter Rückleiter für den Phasenstrom.

Die Software erzwingt in diesem Zustand zyklisch ein konstantes Tastverhältnis von 0 %.

Demnach steuert der Treiber den LS-MOSFET statisch mit der vollen Treiberspannung von

ca. 11,5 V durch, um die ohmschen Leitverluste im Halbleiter zu minimieren. Während der

antriebslosen BEMF-Messphase (grüne Kurve) wird die Halbbrücke schließlich vollständig

abgeschaltet. Der Mikrocontroller zieht den zugehörigen Shutdown-Pin (SD) auf ein Low-

Potenzial. Das Oszillogramm zeigt in diesem Sektor ein konstantes Massepotenzial (0 V) am

Gate, wodurch sichergestellt ist, dass die Phase sicher hochohmig (Floating) verbleibt und

keine unerwünschten brückeninternen Querströme fließen können.

# 6.4 Thermische Evaluation am Prototyp

Wie im thermischen Entwurf in Kapitel 5 berechnet, ist für den Volllastbetrieb zwingend eine

aktive Kühlung erforderlich, um die anfallende Verlustleistung von 28,56 W sicher abzuführen.

Aus zeitlichen Gründen und mangels eines geeigneten Prüfstands (wie beispielsweise eines

Leistungswiderstands) konnte eine vollständige thermische Validierung unter Nennlast nicht

physisch vollzogen werden. Um dennoch eine Aussage über die Güte des Kühldesigns treffen

zu können, wurde ein Leerlauftest durchgeführt. Ziel ist es, die thermische Erwärmung des

Systems zu messen und anhand der bestehenden theoretischen Verlustberechnungen auf den

Volllastbetrieb zu extrapolieren.

# 6.4.1 Messaufbau und Leerlauf-Dauertest

Für den Test wurde der BLDC-Motor ohne mechanische Last bei maximaler Drehzahl (Soll-

wertvorgabe 100 %) betrieben. Die Strommessung ergab hierbei einen konstanten stationären

Leerlaufstrom von IRMS ≈ 450 mA. Zur messtechnischen Erfassung des thermischen Verhaltens

wurde ein System auf Basis eines Arduino Nano implementiert. Als Sensor fungierte ein analo-

ger Temperatursensor vom Typ TMP36GT9Z, welcher mithilfe eines Silikonpads direkt auf dem

Aluminiumkühlkörper fixiert wurde. Der Mikrocontroller erfasste die Kühlkörpertemperatur

über einen Zeitraum von 10 Minuten. Um das Messrauschen zu reduzieren, wurde software-

seitig ein gleitender Mittelwert (Oversampling) über 10 Einzelmessungen angewendet. Der

vollständige Quellcode des Messsystems ist in Anhang A.6 dokumentiert. Abbildung 6.5 zeigt

den resultierenden Temperaturverlauf des Kühlkörpers. Auf eine mathematische Glättung der

Datenpunkte wurde bewusst verzichtet, um die reale Auflösung und das Quantisierungsver-

halten des Sensors abzubilden.

T3_3200 | Pascal Lauer | 6 Aufbau und Messungen

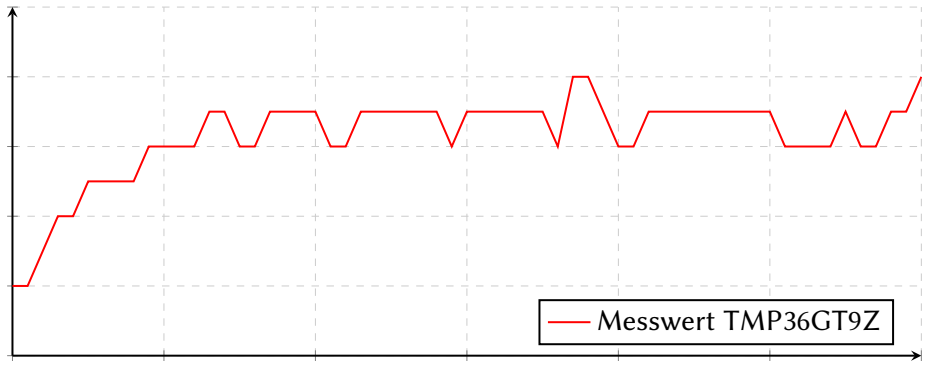
[picture p19: figure]
Messwert TMP36GT9Z

0 | 100 | 200 | 300 | 400 | 500 | 600

21.8

22.0

22.2

22.4

22.6

22.8

## Zeit t [s]

# Kühlkörpertemperatur

TS [

◦C]

Abbildung 6.5: Erwärmung des Kühlkörpers beim stationären Leerlaufstrom von 450 mA.

# 6.4.2 Hochrechnung auf den Lastbetrieb

Zu Beginn der Messung (t = 0 s) betrug die Umgebungstemperatur TA = 22,0

## ◦C. Nach 600 s

## geht das System bei TS ≈ 22,5

◦C in einen quasi-stationären Zustand über. Dies entspricht

einer minimalen Erwärmung von ΔT = 0,5 K. Analysiert man die Ursache dieser Erwärmung,

zeigt sich, dass die rein ohmschen Leitverluste im Leerlauf physikalisch vernachlässigbar klein

sind. Wie in den Gleichungen zur Verlustkalkulation (vgl. Kapitel 4) hergeleitet, betragen die

statischen Leitverluste für einen Phasenstrang PMOS,c = I

2
RMS ⋅ RDS(on)(TJ). Für den gesamten

dreiphasigen Umrichter ergibt sich daraus bei dem gemessenen Strom von 450 mA:

PMOS,c,total = 3 ⋅ PMOS,c = 3 ⋅ I

2
RMS ⋅ RDS(on)(22,3

## ◦C) = 3 ⋅ (0,45 A)² ⋅ 0,0034 Ω ≈ 2,1 mW (6.1)

Die gemessene Temperaturdifferenz resultiert folglich fast ausschließlich aus den Ruheströmen

der Steuerlogik sowie minimalen Schaltverlusten. Aus der gemessenen Erwärmung und dem

in Kapitel 5 spezifizierten passiven Wärmewiderstand des Kühlkörpers (Rth,SA = 12 K/W) lässt

sich die maximale Verlustleistung der Endstufe wie folgt abschätzen:

PMOS,max =

ΔT

Rth,SA

=

0,5 K
12 K/W ≈ 41,7 mW | (6.2)

Dieser Wert im Milliwatt-Bereich korreliert exzellent mit der zu erwartenden statischen Verlust-

leistung der verwendeten aktiven Bauelemente und plausibilisiert somit die korrekte Funktion

des thermischen Messaufbaus. Da das grundlegende thermische Koppelverhalten des passiven

Kühlkörpers hiermit bestätigt ist, lässt sich die Extrapolation auf den Leistungseinsatz durch-

führen. Wie im thermischen Entwurf detailliert hergeleitet wurde, resultiert der Nennbetrieb

unter Volllast in einer berechneten Gesamtverlustleistung von 28,56 W. Würde diese Leistung

stationär in den aktuell rein passiv gekühlten Prototypenaufbau fließen, ergäbe sich über den

T3_3200 | Pascal Lauer | 6 Aufbau und Messungen

statischen thermischen Widerstand des Kühlkörpers ein dramatischer Temperaturanstieg:

ΔTSA,max = 28,56 W ⋅ 12 K/W ≈ 342,7 K | (6.3)

Addiert man diese berechnete Erwärmung zur Umgebungstemperatur, würde die Kühlkör-

pertemperatur rein rechnerisch auf über 360◦C ansteigen. Selbst unter Berücksichtigung von

thermischen Nichtlinearitäten würde die maximal zulässige Sperrschichttemperatur der MOS-

FETs (TJ,max = 175◦C) nach kürzester Betriebszeit drastisch überschritten werden, was einen

Totalausfall der Endstufe durch Thermal Runaway zur Folge hätte. Die durchgeführte Mes-

sung und die direkte analytische Extrapolation auf den Arbeitspunkt verifizieren somit die

theoretische Auslegungsentscheidung aus Kapitel 5. Der passive Prototyp ist mechanisch und

thermisch ausschließlich für Leerlaufanalysen und geringe Ströme geeignet. Die Implemen-

tierung der aktiven Luftkühlung (Axiallüfter) zur signifikanten Reduktion des thermischen

Gesamtwiderstands ist für den sicheren Nennbetrieb physikalisch unumgänglich.

# 7 Fazit und Ausblick

Die vorliegende Studienarbeit behandelt die methodische Entwicklung und prototypische

Umsetzung eines sensorgestützten BLDC-Motorcontrollers. Der Hardwareentwurf, bestehend

aus einer B6-Wechselrichterbrücke mit IPP034N08N5-Leistungs-MOSFETs und IR2104-Gate-

Treibern, wurde sowohl theoretisch dimensioniert als auch experimentell verifiziert. Die auf

einem STM32G431RB-Mikrocontroller implementierte Softwarearchitektur realisiert eine zu-

verlässige 6-Step-Blockkommutierung, deren Phasensteuerung auf der kontinuierlichen Positi-

onsauswertung von drei integrierten Hall-Sensoren basiert. Oszilloskopische Messungen an

einem Lochraster-Prototyp bestätigen die korrekte Taktung der Gate-Signale, die Einhaltung

der erforderlichen Totzeit sowie die Funktionalität der Synchrongleichrichtung. Die prinzipielle

Funktionsfähigkeit des Systems konnte im Leerlauf- und Niederlastbereich nachgewiesen

werden, während die durchgeführten thermischen und elektrischen Analysen die Grenzen

des aktuellen Aufbaus für den Volllastbetrieb bei Phasenströmen über 30 A aufzeigen. Die

berechnete Verlustleistung von etwa 28,6 W kann durch die vorhandene passive Kühlung nicht

ausreichend abgeführt werden, sodass ein sicherer Dauerbetrieb unter diesen Bedingungen

nicht gewährleistet ist. Für den Einsatz im Hochstrombereich ist daher eine Weiterentwick-

lung der Hardware erforderlich, insbesondere durch die Umsetzung auf einer mehrlagigen

Leiterplatte mit angepassten Leiterbahnquerschnitten und thermischen Vias zur Reduktion

des thermischen Widerstands sowie zur Minimierung parasitärer Induktivitäten. Ergänzend ist

der Einsatz einer aktiven Luftkühlung zweckmäßig. Insgesamt stellt die entwickelte Hard- und

Softwarebasis eine geeignete Grundlage für die Weiterentwicklung zu einem leistungsfähigen

und robusten Motorcontroller dar.

# Literatur

[1] Monolithic Power Systems, Brushless DC Motor Fundamentals, AN047, Rev. 1.0, 2014. Adres-

# se: https://media.monolithicpower.com/document/Brushless_

DC_Motor_Fundamentals.pdf. (https://media.monolithicpower.com/document/Brushless_DC_Motor_Fundamentals.pdf)

[2] P. Pillay und R. Krishnan, „Application Characteristics of Permanent Magnet Synchronous
and Brushless DC Motors for Servo Drives,“ IEEE Transactions on Industry Applications, Jg. 27, Nr. 5, S. 986–996, 1991. doi: 10.1109/28.90357. (https://doi.org/10.1109/28.90357)
[3] ON Semiconductor, AN-6076: Design and Application Guide of Bootstrap Circuit for High-

# Voltage Gate-Drive IC, Rev. 3, 2021. Adresse: https : / / www . onsemi . com /

download/application-notes/pdf/and9674-d.pdf. (https://www.onsemi.com/download/application-notes/pdf/and9674-d.pdf)

[4] C.-l. Xia, Permanent Magnet Brushless DC Motor Drives and Controls. Wiley-IEEE Press,

2012, isbn: 978-1-118-18833-0.

# [5] D. Graovac, M. Pürschel und A. Kiep, MOSFET Power Losses Calculation Using the Data-

Sheet Parameters, Application Note, V 1.1, Infineon Technologies, 2006.

[6] Infineon Technologies, OptiMOS™ 5 Power-Transistor, 80 V: IPP034N08N5, Data Sheet, Rev.

2.0, 2014.

[7] Vishay, Power Metal Strip Resistors, WSLP25121L000FEA, Data Sheet No. 30122 - Rev.

09/2024.

# [8] Texas Instruments, INAx181 Bidirectional, Low- and High-Side Voltage Output, Current-

Sense Amplifiers, Data Sheet No. SBOS793H - Rev. 11/2023.

[9] International Rectifier, IR2104(S) & (PbF) Half-Bridge Driver, Data Sheet No. PD60046-S,

2001.

xi

# A Anhang

# A.1 Berechnung der Verlustleistungen

Dieser Anhang dokumentiert die mathematischen Zwischenschritte der in Abschnitt 4.3 durch-

geführten Verlustleistungsberechnungen. Alle Rechnungen basieren auf den identifizierten

Worst-Case-Szenarien (IBlock = 42,4 A, vi = 42 V).

# A.1.1 Leitverluste MOSFET (High-Side und Low-Side)

Es wird die Synchrongleichrichtung bei einer Sperrschichttemperatur von TJ,design = 100◦C

(RDS(on) = 0,0048 Ω) abgebildet.

# Worst-Case High-Side-Schalter (Maximale Aussteuerung d = 1):

I

2

HS,RMS = (42,4 A)²
⋅

1

3

⋅ 1 = 599,25 A²
(A.1)

## PHS,c = 599,25 A²

⋅ 0,0048 Ω ≈ 2,88 W | (A.2)

# Worst-Case Low-Side-Schalter (Maximaler Freilauf bei Anlauf d = 0):

I

2

LS,RMS = (42,4 A)²
⋅

1

3

⋅ (2 − 0) = 1797,76 A²
⋅

1

3

⋅ 2 ≈ 1138,58 A²
(A.3)

## PLS,c = 1138,58 A²

⋅ 0,0048 Ω ≈ 5,75 W | (A.4)

# A.1.2 Schaltverluste (High-Side)

Bestimmung der Gateströme in der Miller-Phase (vdr = 12 V, vGS,Mi = 5,0 V, RG = 10 Ω):

## iG,on =

12 V − 5,0 V

10 Ω

= 0,7 A | (A.5)

iG,off =

5,0 V − 0 V

10 Ω

= 0,5 A | (A.6)

## xii

T3_3200 | Pascal Lauer | A Anhang

Berechnung der Umschaltdauern mit der Umschaltladung Qsw = 26 nC:

## ton =

26 nC

0,7 A

≈ 37,14 ns | (A.7)

toff =

26 nC

0,5 A

= 52,0 ns | (A.8)

Berechnung der Schaltenergien (vi = 42 V, IBlock = 42,4 A):

EMOS,on =

1

2

⋅ 42,4 A ⋅ 42 V ⋅ 37,14 ns ≈ 33,07 μJ | (A.9)
Eon,rr = 332 nC ⋅ 42 V ≈ 13,94 μJ | (Reverse Recovery) | (A.10)
Eon,total = 33,07 μJ + 13,94 μJ = 47,01 μJ | (A.11)

EMOS,off =

1

2

⋅ 42,4 A ⋅ 42 V ⋅ 52,0 ns ≈ 46,30 μJ | (A.12)

Dynamische Verlustleistung (fsw = 20 kHz bei aktiven 120◦ pro Periode):

## PMOS,sw = (47,01 μJ + 46,30 μJ) ⋅ 20000 Hz ⋅

1

3

≈ 0,62 W | (A.13)

# A.1.3 Leitverluste Freilaufdiode (Totzeitverluste)

Die Diode leitet aus Sicherheitsgründen nur während der Treiber-Totzeit tdt = 520 ns.

dD = 2 ⋅ 520 ns ⋅ 20 kHz = 0,0208 | (A.14)

## iD = 42,4 A ⋅ 0,0208 ⋅

1

3

≈ 0,294 A | (A.15)

i

2

D,RMS = (42,4 A)²
⋅ 0,0208 ⋅

1

3

≈ 12,46 A²
(A.16)

Leitverlustleistung mit den grafisch ermittelten Parametern (vD,0 = 0,58 V, rD = 0,008 Ω):

PD,c = 0,58 V ⋅ 0,294 A + 0,008 Ω ⋅ 12,46 A² = 0,171 W + 0,100 W ≈ 0,27 W | (A.17)

## xiii

T3_3200 | Pascal Lauer | A Anhang

# A.2 Berechnung des Bootstrap-Kondensators

Dieser Anhang dokumentiert die schrittweise Berechnung des Bootstrap-Kondensators CBOOT

für die HS-Ansteuerung des MOSFETs IPP034N08N5 über den Treiber IR2104. Alle Werte

basieren auf den Datenblättern der Bauteile sowie der ON Semiconductor Applikationsschrift

AN-6076 [3].

# A.2.1 Festlegung der zu liefernden Gesamtladung

Die benötigte Gesamtladung Qtotal setzt sich primär aus drei Komponenten zusammen. Der

Gateladung des Transistors, dem Eigenbedarf des Treibers sowie den Leckstromverlusten:

Qtotal = QGate + QLS + QLeak | (A.18)

# Gateladung des MOSFETs

Aus dem Datenblatt des IPP034N08N5 entnehmen wir für eine Gate-Source-Spannung von

VGS = 10 V eine Gateladung von QG(10V) = 87 nC sowie eine Eingangskapazität von Ciss =

4800 pF. Da der verwendete Gate-Treiber mit einer Versorgungsspannung von VCC = 15 V

arbeitet, muss die benötigte Ladung um diese Spannungsdifferenz (ΔV = 5 V) extrapoliert

werden:

QGate = QG(10V) + Ciss ⋅ ΔV | (A.19)
QGate = 87 nC + (4800 ⋅ 10⁻¹² F) ⋅ 5 V | (A.20)
QGate = 87 nC + 24 nC ≈ 111 nC | (A.21)

# Level-Shifter-Ladung

Der typische Ladungsverbrauch des IR2104-Level-Shifters während einer einzelnen HS-Einschaltphase

beträgt:

QLS ≈ 3 nC | (A.22)

# Leckströme während der Einschaltzeit

Bei einer PWM-Schaltfrequenz von fsw = 20 kHz ergibt sich bei maximaler Aussteuerung eine

Worst-Case-Einschaltdauer von:

ton,max =

1

# fsw

= 50 μs | (A.23)

Die Summe der relevanten Leckströme (IDriver, IQBS, IGSS, IDIODE) beläuft sich nach Datenblatt-

angaben auf:

ILeak = 50 μA + 55 μA + 0,1 μA + 10 μA ≈ 115,1 μA | (A.24)

xiv

T3_3200 | Pascal Lauer | A Anhang

Daraus resultiert ein Ladungsverlust während der Einschaltdauer von:

QLeak = ILeak ⋅ ton,max = 115,1 ⋅ 10⁻⁶ A ⋅ 50 ⋅ 10⁻⁶ s ≈ 5,8 nC | (A.25)

# A.2.2 Gesamtkapazität und Bauteilauswahl

Die während einer Periode bereitzustellende Gesamtladung summiert sich folglich auf:

Qtotal = 111 nC + 3 nC + 5,8 nC ≈ 120 nC | (A.26)

Um sicherzustellen, dass die Bootstrap-Spannung nicht zu stark einbricht, wird ein maximal

zulässiger Spannungsabfall von ΔVBOOT = 1,0 V definiert. Daraus ergibt sich die minimal

erforderliche Kapazität zu:

CBOOT,min =

# Qtotal

## ΔVBOOT

=

120 nC

1,0 V

= 120 nF | (A.27)

Unter Berücksichtigung von Fertigungstoleranzen, dem typischen Kapazitätsverlust bei an-

liegender DC-Bias-Spannung sowie thermischen Alterungseffekten wird für die praktische

Umsetzung eine großzügige Sicherheitsreserve eingeplant. Gewählt wird ein 220 nF X7R-

Keramikkondensator.

xv

# A.3 Gesamtschaltplan

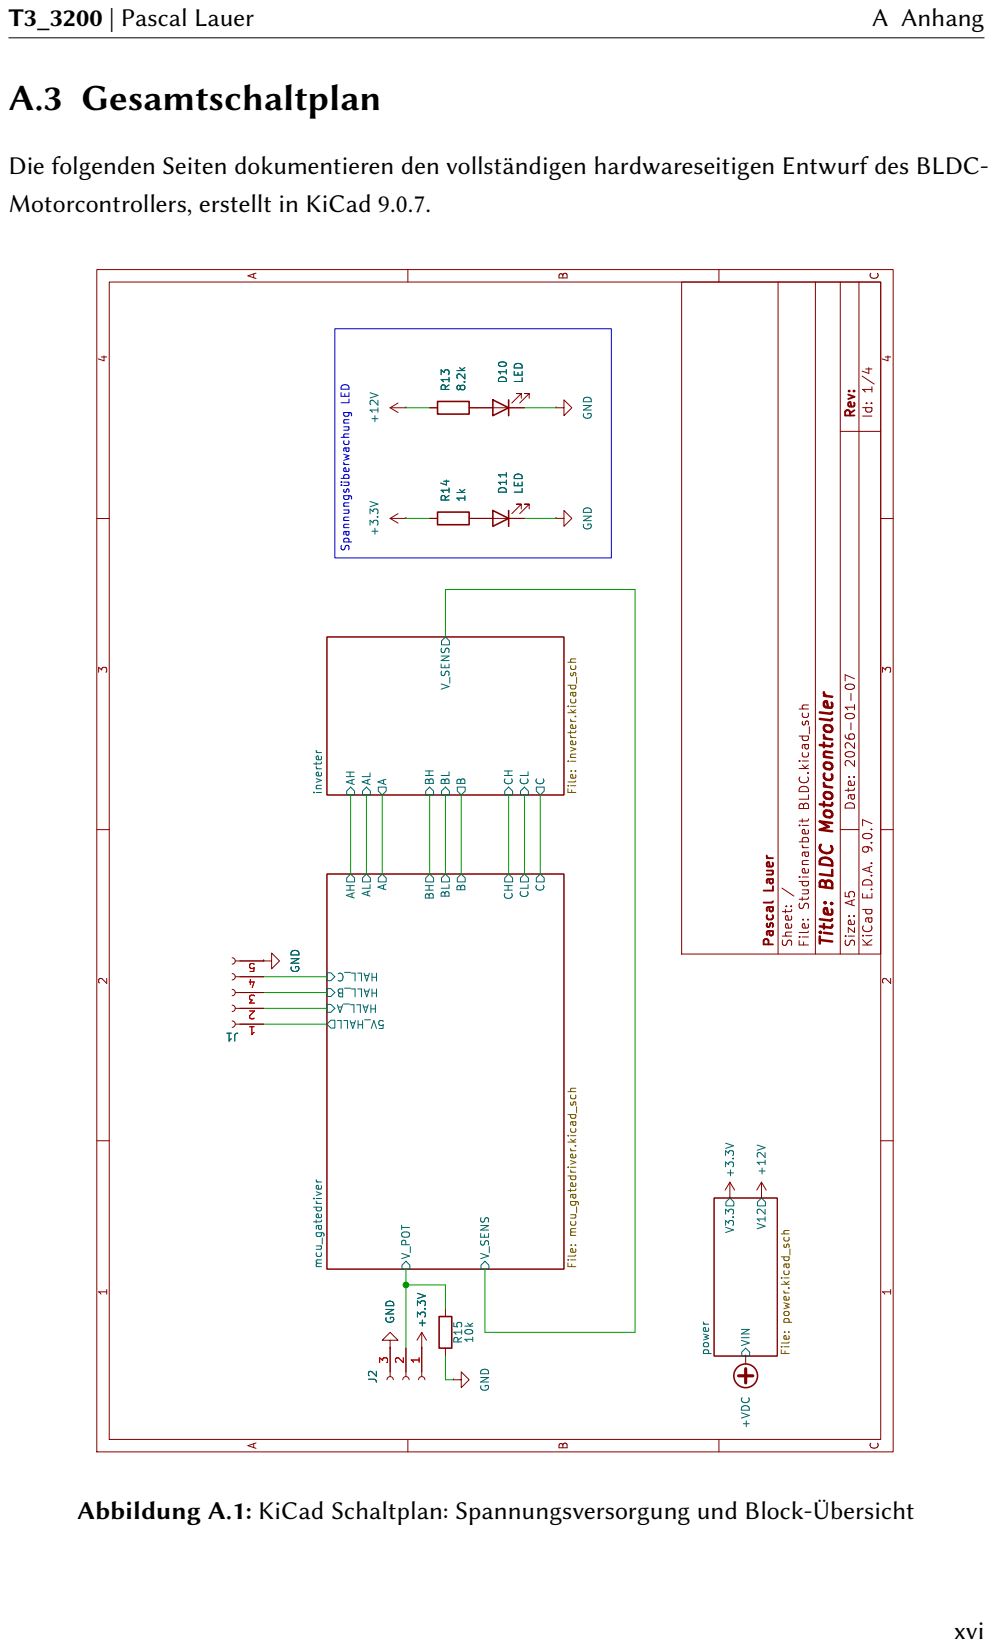
[picture p20: page 62]
T3_3200 | Pascal Lauer; A Anhang; Date: 2026-01-07; KiCad E.D.A. 9.0.7; Rev: Size: A5; Sheet: /; Pascal Lauer; V_SENS; inverter; File: inverter.kicad_sch; V_POT; mcu_gatedriver; File: mcu_gatedriver.kicad_sch; VIN; power; File: power.kicad_sch; LED; GND; +VDC; þÿ S p a n n u n g s ü b e r w a c h u n g LED; xvi

Die folgenden Seiten dokumentieren den vollständigen hardwareseitigen Entwurf des BLDC-

Motorcontrollers, erstellt in KiCad 9.0.7.

Title: BLDC Motorcontroller

File: Studienarbeit BLDC.kicad_sch

Abbildung A.1: KiCad Schaltplan: Spannungsversorgung und Block-Übersicht

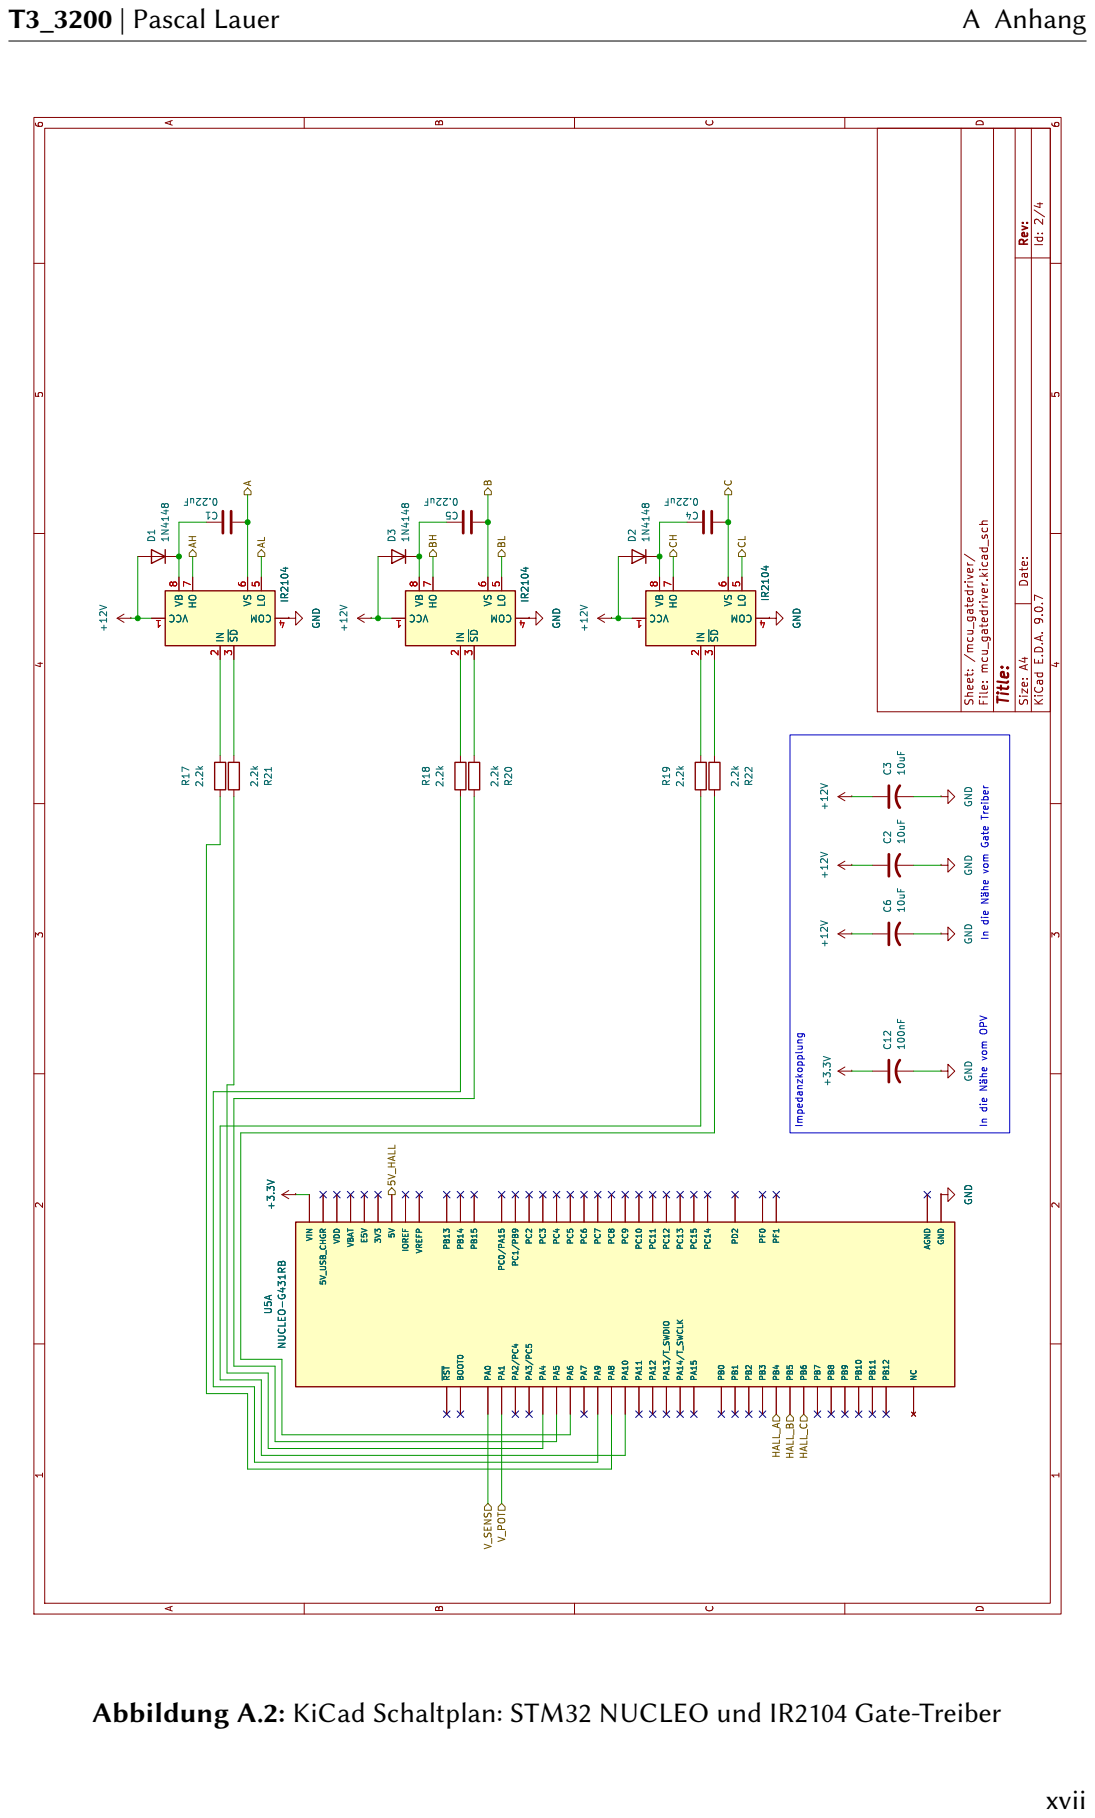
[picture p21: page 63]

In die þÿ N ä h evom OPV In die þÿ N ä h evom Gate Treiber

Abbildung A.2: KiCad Schaltplan: STM32 NUCLEO und IR2104 Gate-Treiber

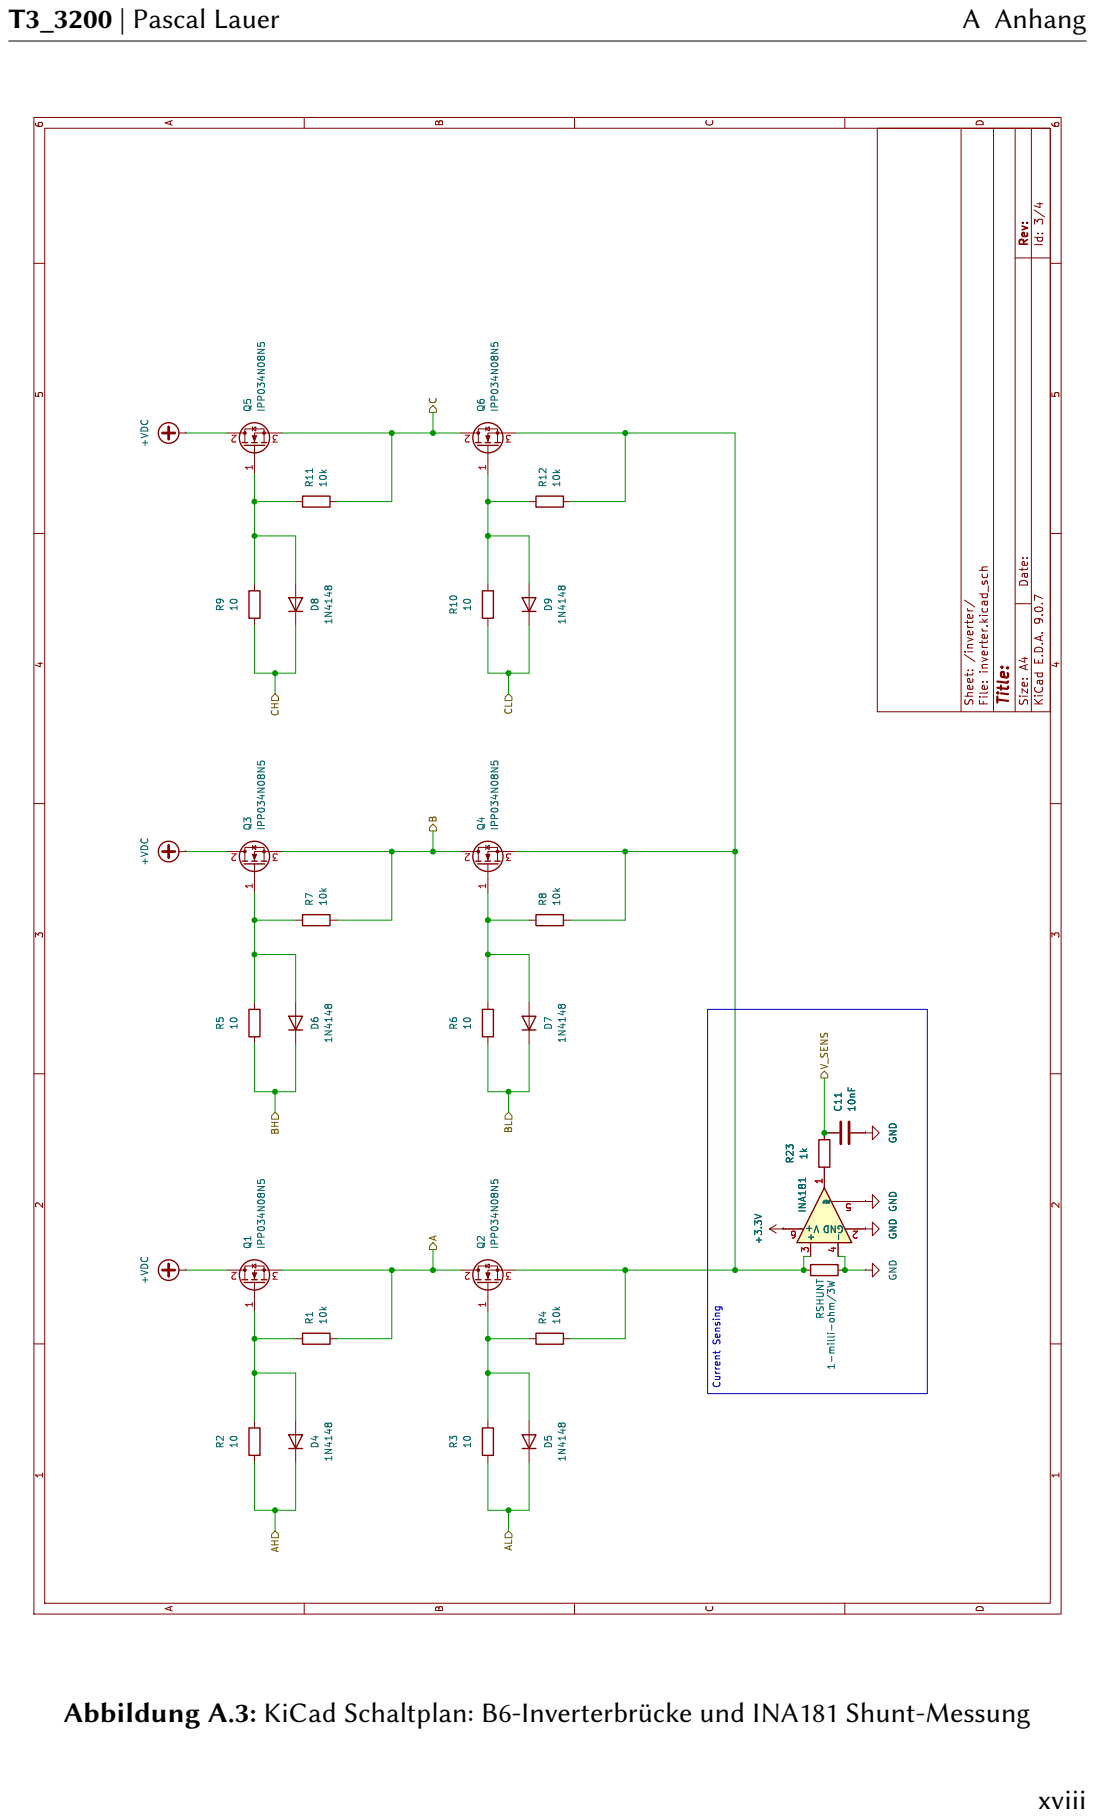
[picture p22: page 64]

Abbildung A.3: KiCad Schaltplan: B6-Inverterbrücke und INA181 Shunt-Messung

T3_3200 | Pascal Lauer | A Anhang

# A.4 STM32-Quellcode (Auszug)

Das folgende Listing dokumentiert die implementierte Kernlogik der Motorsteuerung in

der Programmiersprache C. Zur Steigerung der Übersichtlichkeit und Fokussierung auf die

eigenständig entwickelten Algorithmen wurden die mittels STM32CubeMX generierten Initiali-

sierungssequenzen (System Clock, GPIO-Peripherie) abstrahiert. Die Darstellung konzentriert

sich auf die softwareseitige Realisierung der 6-Schritt-Blockkommutierung, die Auswertung

der Hall-Sensorik sowie die zeitkritische ISR zur Strombegrenzung.

1 | /**
2 | * @file | main.c
3 | * @brief | BLDC 6−Step Commutation with Cycle−by−Cycle Current Limiting
4 | * @author | Pascal Lauer
5 | */

6

### 7 #include "main.h"

8
9 | /* −−− Configuration Macros −−− */
10 | #define PWM_MAX_LIMIT | 8075 | // Max 95% Duty Cycle (sichert Bootstrap−Umladung)
11 | #define PWM_MIN_THRESHOLD | 425 | // Min 5% Duty Cycle (Totzone / Abschaltung)
12 | #define PWM_CURRENT_LIMIT_DROP | 400 | // Aggressives Abregeln bei Ueberstrom
13 | #define PWM_RECOVERY_STEP | 10 | // Sanftes Nachfuehren nach Stromspitzen
14 | #define ADC_MAX_RAW_VALUE | 4095 | // 12−Bit ADC Aufloesung

15
16 | /* −−− Global Variables −−− */
17 | uint32_t pwm_current = 0;
18 | uint32_t pwm_target = 0;

19
20 | /* −−− Hardware Handles −−− */
21 | ADC_HandleTypeDef hadc1;
22 | TIM_HandleTypeDef htim1;

23
24 | /**
25 | * @brief Fuehrt die harte Blockkommutierung basierend auf dem Hall−Zustand durch.
26 | */
27 | void BLDC_UpdateCommutation(void)
28 | {
29 | // Sicherheitsabschaltung: Bei Sollwert unter Minimum treiben die Endstufen nicht
30 | if (pwm_current < PWM_MIN_THRESHOLD) {
31 | HAL_GPIO_WritePin(GPIOA, GPIO_PIN_4 | GPIO_PIN_5 | GPIO_PIN_6, GPIO_PIN_RESET);
32 | __HAL_TIM_SET_COMPARE(&htim1, TIM_CHANNEL_1, 0);
33 | __HAL_TIM_SET_COMPARE(&htim1, TIM_CHANNEL_2, 0);
34 | __HAL_TIM_SET_COMPARE(&htim1, TIM_CHANNEL_3, 0);
35 | return;
36 | }

37
38 | // Hall−Sensoren einlesen und Bit−Maske erstellen (PB4, PB5, PB6)
39 | uint8_t h1 = HAL_GPIO_ReadPin(GPIOB, GPIO_PIN_4);
40 | uint8_t h2 = HAL_GPIO_ReadPin(GPIOB, GPIO_PIN_5);
41 | uint8_t h3 = HAL_GPIO_ReadPin(GPIOB, GPIO_PIN_6);
42 | uint8_t hall_state = (h3 << 2) | (h2 << 1) | h1;

43
44 | // 6−Schritt Kommutierungslogik (SD−Pins aktivieren die Treiber)

xix

T3_3200 | Pascal Lauer | A Anhang
45 | switch (hall_state) {
46 | case 5: // Phase A: PWM (HS), Phase B: GND (LS), Phase C: Floating
47 | HAL_GPIO_WritePin(GPIOA, GPIO_PIN_6, GPIO_PIN_RESET);
48 | __HAL_TIM_SET_COMPARE(&htim1, TIM_CHANNEL_1, pwm_current);
49 | __HAL_TIM_SET_COMPARE(&htim1, TIM_CHANNEL_2, 0);
50 | HAL_GPIO_WritePin(GPIOA, GPIO_PIN_4 | GPIO_PIN_5, GPIO_PIN_SET);
51 | break;

52
53 | case 1: // Phase A: PWM (HS), Phase C: GND (LS), Phase B: Floating
54 | HAL_GPIO_WritePin(GPIOA, GPIO_PIN_5, GPIO_PIN_RESET);
55 | __HAL_TIM_SET_COMPARE(&htim1, TIM_CHANNEL_1, pwm_current);
56 | __HAL_TIM_SET_COMPARE(&htim1, TIM_CHANNEL_3, 0);
57 | HAL_GPIO_WritePin(GPIOA, GPIO_PIN_4 | GPIO_PIN_6, GPIO_PIN_SET);
58 | break;

59
60 | case 3: // Phase B: PWM (HS), Phase C: GND (LS), Phase A: Floating
61 | HAL_GPIO_WritePin(GPIOA, GPIO_PIN_4, GPIO_PIN_RESET);
62 | __HAL_TIM_SET_COMPARE(&htim1, TIM_CHANNEL_2, pwm_current);
63 | __HAL_TIM_SET_COMPARE(&htim1, TIM_CHANNEL_3, 0);
64 | HAL_GPIO_WritePin(GPIOA, GPIO_PIN_5 | GPIO_PIN_6, GPIO_PIN_SET);
65 | break;

66
67 | case 2: // Phase B: PWM (HS), Phase A: GND (LS), Phase C: Floating
68 | HAL_GPIO_WritePin(GPIOA, GPIO_PIN_6, GPIO_PIN_RESET);
69 | __HAL_TIM_SET_COMPARE(&htim1, TIM_CHANNEL_2, pwm_current);
70 | __HAL_TIM_SET_COMPARE(&htim1, TIM_CHANNEL_1, 0);
71 | HAL_GPIO_WritePin(GPIOA, GPIO_PIN_5 | GPIO_PIN_4, GPIO_PIN_SET);
72 | break;

73
74 | case 6: // Phase C: PWM (HS), Phase A: GND (LS), Phase B: Floating
75 | HAL_GPIO_WritePin(GPIOA, GPIO_PIN_5, GPIO_PIN_RESET);
76 | __HAL_TIM_SET_COMPARE(&htim1, TIM_CHANNEL_3, pwm_current);
77 | __HAL_TIM_SET_COMPARE(&htim1, TIM_CHANNEL_1, 0);
78 | HAL_GPIO_WritePin(GPIOA, GPIO_PIN_6 | GPIO_PIN_4, GPIO_PIN_SET);
79 | break;

80
81 | case 4: // Phase C: PWM (HS), Phase B: GND (LS), Phase A: Floating
82 | HAL_GPIO_WritePin(GPIOA, GPIO_PIN_4, GPIO_PIN_RESET);
83 | __HAL_TIM_SET_COMPARE(&htim1, TIM_CHANNEL_3, pwm_current);
84 | __HAL_TIM_SET_COMPARE(&htim1, TIM_CHANNEL_2, 0);
85 | HAL_GPIO_WritePin(GPIOA, GPIO_PIN_6 | GPIO_PIN_5, GPIO_PIN_SET);
86 | break;

87
88 | default:
89 | // Fehlerfall (z.B. Leitungsbruch): Emergency Stop erzwingen
90 | HAL_GPIO_WritePin(GPIOA, GPIO_PIN_4 | GPIO_PIN_5 | GPIO_PIN_6, GPIO_PIN_RESET);
91 | __HAL_TIM_SET_COMPARE(&htim1, TIM_CHANNEL_1, 0);
92 | __HAL_TIM_SET_COMPARE(&htim1, TIM_CHANNEL_2, 0);
93 | __HAL_TIM_SET_COMPARE(&htim1, TIM_CHANNEL_3, 0);
94 | break;
95 | }
96 | }

97
98 | /**
99 | * @brief Hardware−Interrupt: Wird bei Flankenwechsel eines Hall−Sensors getriggert.
100 | */
101 | void HAL_GPIO_EXTI_Callback(uint16_t GPIO_Pin)

xx

T3_3200 | Pascal Lauer | A Anhang
102 | {
103 | if (GPIO_Pin == GPIO_PIN_4 || GPIO_Pin == GPIO_PIN_5 || GPIO_Pin == GPIO_PIN_6) {
104 | BLDC_UpdateCommutation();
105 | }
106 | }

107

108 | /**
109 | * @brief Hardware−Interrupt: Analog Watchdog detektiert Uberstrom am Shunt.
110 | */
111 | void HAL_ADC_LevelOutOfWindowCallback(ADC_HandleTypeDef* hadc)
112 | {
113 | if (hadc−>Instance == ADC1) {
114 | // Cycle−by−Cycle Current Limiting: Duty Cycle aggressiv drosseln
115 | if (pwm_current > PWM_CURRENT_LIMIT_DROP) {
116 | pwm_current −= PWM_CURRENT_LIMIT_DROP;
117 | } else {
118 | pwm_current = 0;
119 | }
120 | // Direkter Hardware−Update zur Unterdrueckung der Stromspitze
121 | BLDC_UpdateCommutation();
122 | }
123 | }

124

125 | /**
126 | * @brief Main Control Loop
127 | */
128 | int main(void)
129 | {
130 | /* ... STM32 HAL Initialisierung & Clock Config ... */

131
132 | // Konfiguration des Analog Watchdogs fuer 42.4A Abschaltgrenze
133 | ADC_AnalogWDGConfTypeDef AnalogWDGConfig = {0};
134 | AnalogWDGConfig.WatchdogMode = ADC_ANALOGWATCHDOG_SINGLE_REG;
135 | AnalogWDGConfig.HighThreshold = 2630; // ADC Wert = 2.12V (am Shunt OPV)
136 | AnalogWDGConfig.LowThreshold = 0;
137 | AnalogWDGConfig.Channel = ADC_CHANNEL_1;
138 | AnalogWDGConfig.ITMode = ENABLE;
139 | HAL_ADC_AnalogWDGConfig(&hadc1, &AnalogWDGConfig);

140
141 | // Timer und ADC starten
142 | HAL_TIM_PWM_Start(&htim1, TIM_CHANNEL_1);
143 | HAL_TIM_PWM_Start(&htim1, TIM_CHANNEL_2);
144 | HAL_TIM_PWM_Start(&htim1, TIM_CHANNEL_3);
145 | __HAL_TIM_MOE_ENABLE(&htim1);
146 | HAL_ADC_Start_IT(&hadc1);

147
148 | while (1)
149 | {
150 | // Polling des analogen Throttle−Signals (Gaspedal)
151 | if (HAL_ADC_PollForConversion(&hadc1, 10) == HAL_OK) {
152 | uint32_t adc_throttle_raw = HAL_ADC_GetValue(&hadc1);

153
154 | // Skalierung auf maximal 95% Duty Cycle
155 | pwm_target = (adc_throttle_raw * PWM_MAX_LIMIT) / ADC_MAX_RAW_VALUE;

156
157 | // Soft−Recovery: PWM sanft an den Zielwert heranfuehren
158 | // (Verhindert Schwingen bei aktiver Strombegrenzung)

xxi

T3_3200 | Pascal Lauer | A Anhang
159 | if (pwm_current < pwm_target) {
160 | pwm_current += PWM_RECOVERY_STEP;
161 | } else {
162 | pwm_current = pwm_target;
163 | }

164
165 | BLDC_UpdateCommutation();
166 | }
167 | HAL_Delay(2); // ADC Zyklus entlasten
168 | }
169 | }

Listing A.1: Kernlogik der 6-Step Blockkommutierung und Strombegrenzung

xxii

T3_3200 | Pascal Lauer | A Anhang

# A.5 Oszillogramme der Inbetriebnahme

Die folgenden Abbildungen dokumentieren die Messdaten des verwendeten Digitaloszilloskops,

welche die Datengrundlage für die Auswertungen in Kapitel 6.3 bilden.

# A.5.1 Transientes Schaltverhalten

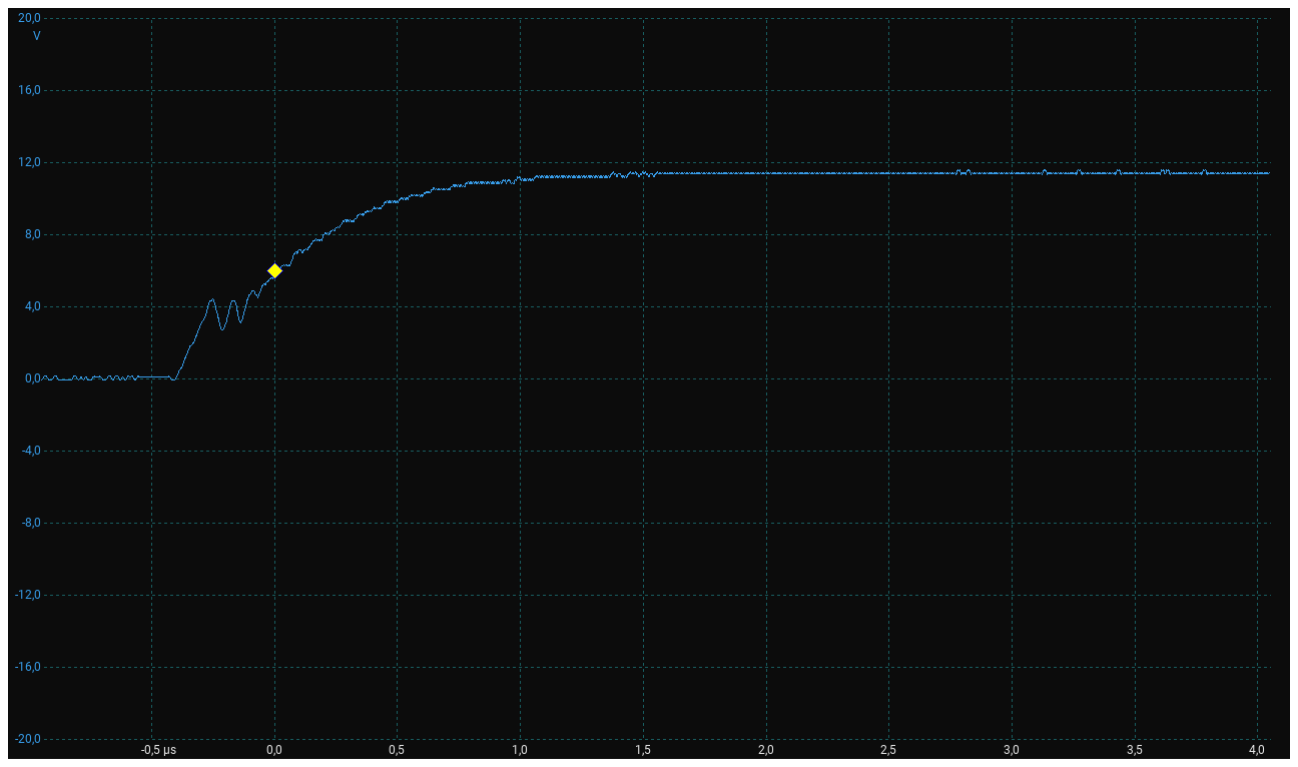
[picture p23: figure]

Abbildung A.4: Schaltflanke des LS-Gates (Phase U) zur Validierung des Miller-Plateaus und

des Gate-Widerstands.

Zeitbasis: 0,5 μs/div.

## xxiii

# A.5.2 Zyklische Kommutierungszustände

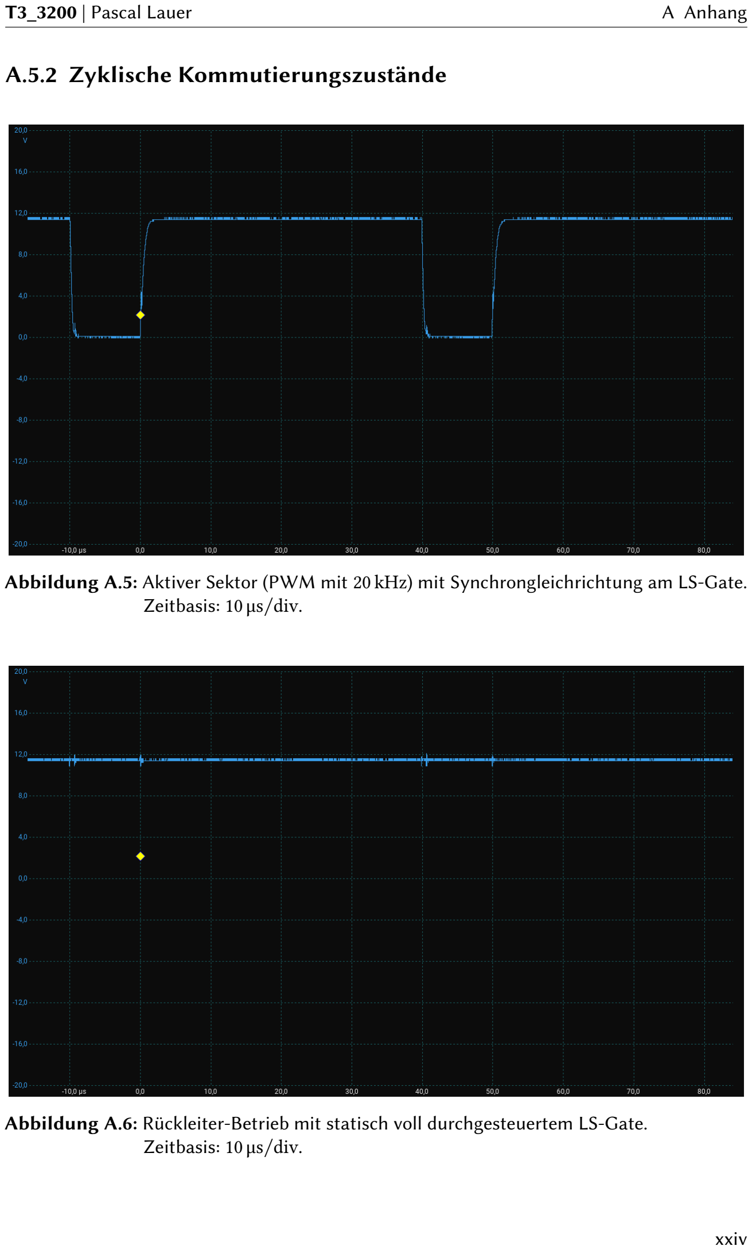
[picture p24: page 70]

T3_3200 | Pascal Lauer | A Anhang

Abbildung A.5: Aktiver Sektor (PWM mit 20 kHz) mit Synchrongleichrichtung am LS-Gate.

Zeitbasis: 10 μs/div.

Abbildung A.6: Rückleiter-Betrieb mit statisch voll durchgesteuertem LS-Gate.

Zeitbasis: 10 μs/div.

xxiv

T3_3200 | Pascal Lauer | A Anhang

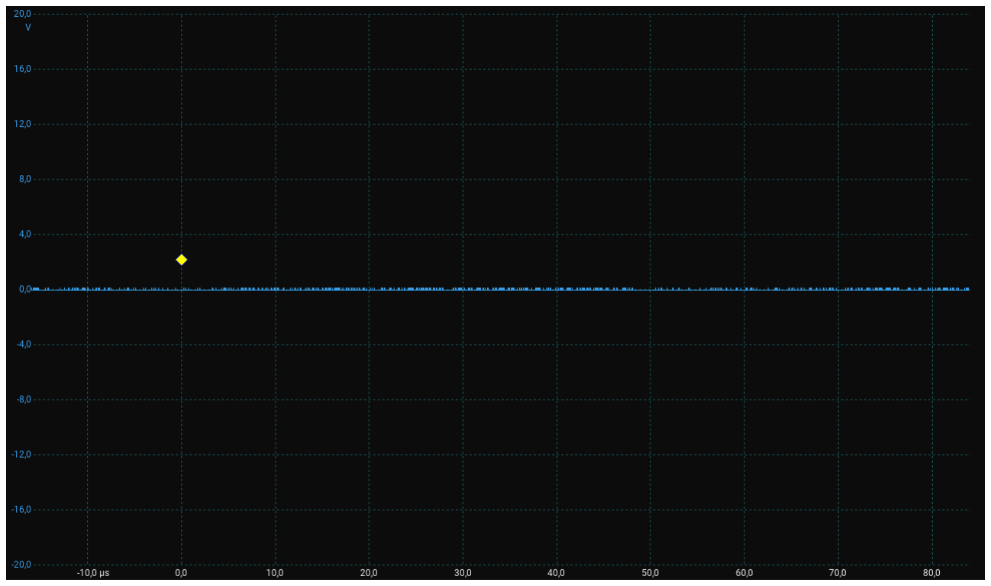
[picture p25: figure]

Abbildung A.7: Floating-Betrieb mit hardwareseitig abgeschaltetem Gate.

Zeitbasis: 10 μs/div.

xxv

T3_3200 | Pascal Lauer | A Anhang

# A.6 Arduino Software zur Temperaturerfassung

Das folgende Listing zeigt die in Abschnitt 6.4 verwendete Software zur Aufzeichnung der

Kühlkörpertemperatur. Der Code wandelt die analoge Spannung des TMP36GT9Z mittels

Oversampling in eine geglättete Temperatur in Grad Celsius um und formatiert die serielle

Ausgabe direkt als ‘.csv‘ Datenstrom.

const int sensorPin = A0;

unsigned long lastTime = 0;

### const unsigned long interval = 10000; // 10 Sekunden Intervalle

### void setup() {

Serial.begin(9600);

### // CSV Header

Serial.println("Zeit_s,Temperatur_C");

}

### void loop() {

unsigned long currentTime = millis();

### if (currentTime − lastTime >= interval) {

lastTime = currentTime;

### float time_s = currentTime / 1000.0; // Zeit in Sekunden

### // Oversampling zur Rauschunterdrueckung (10 Samples)

int samples = 10;

float sum = 0;

### for (int i = 0; i < samples; i++) {

sum += analogRead(sensorPin);

delay(5);

}

float adcValue = sum / samples;

### // ADC zu Spannung (5V Referenz) und Temperaturumrechnung

float voltage = adcValue * (5.0 / 1023.0);
float temperatureC = (voltage − 0.5) * 100.0;

### // Datenausgabe ueber die serielle Schnittstelle

Serial.print(time_s, 0);

Serial.print(",");

Serial.println(temperatureC, 2);

}

}

Listing A.2: Arduino Nano Firmware für den TMP36-Sensor

xxvi
