plauer03/T3_3200/main.tex

%! TeX root = main.tex

% ----------------------------------------------------------------
% main.tex
% ---------------------------------------------------------------
\documentclass[12pt,                      
               oneside,
               a4paper,                   
               BCOR=1.0cm,                
               headsepline,               
               toc = index,               
               bibliography=totoc,          
               numbers=noenddot,            
               ]{scrbook}
\input{settings}
\newcounter{savepage}

\begin{document}
\pagestyle{plain}
\pagenumbering{roman}
\input{flyleaf/deckblatt}
%\input{flyleaf/abstract} % er will kein Abstract!
\newpage
\input{disclaimer/disclaimers}
\cleardoublepage
\tableofcontents 
\listoffigures
%\addcontentsline{toc}{chapter}{Abbildungsverzeichnis}
\listoftables   
%\addcontentsline{toc}{chapter}{Tabellenverzeichnis}
\input{flyleaf/abkuerzungen}
\input{flyleaf/symbol_formel}
 
%\listoflistings             
\clearpage
\pagestyle{headings}
\setcounter{savepage}{\value{page}}
\pagenumbering{arabic}
\cleardoublepage

\input{chapters/01_einleitung}
\input{chapters/02_grundlagen}
\input{chapters/03_anforderungen}
\input{chapters/04_entwurf_leistung}
\input{chapters/05_thermik}
\input{chapters/06_aufbau_mess}
\input{chapters/07_fazit}

\clearpage
\pagenumbering{roman}
\setcounter{page}{\value{savepage}}
% --- VERZEICHNISSE & LITERATUR ---
\printbibliography

\newpage
% --- ANHANG ---
\appendix

\chapter{Anhang}

\input{appendix/loss_calc}

\clearpage

\input{appendix/bootstrap}

\clearpage

\input{appendix/schaltplan}

\clearpage

\input{appendix/software}

\clearpage

\input{appendix/messung}

\clearpage

\input{appendix/arduino_temp}

\end{document}
