plauer03/T3_3200/images/BEMF.png

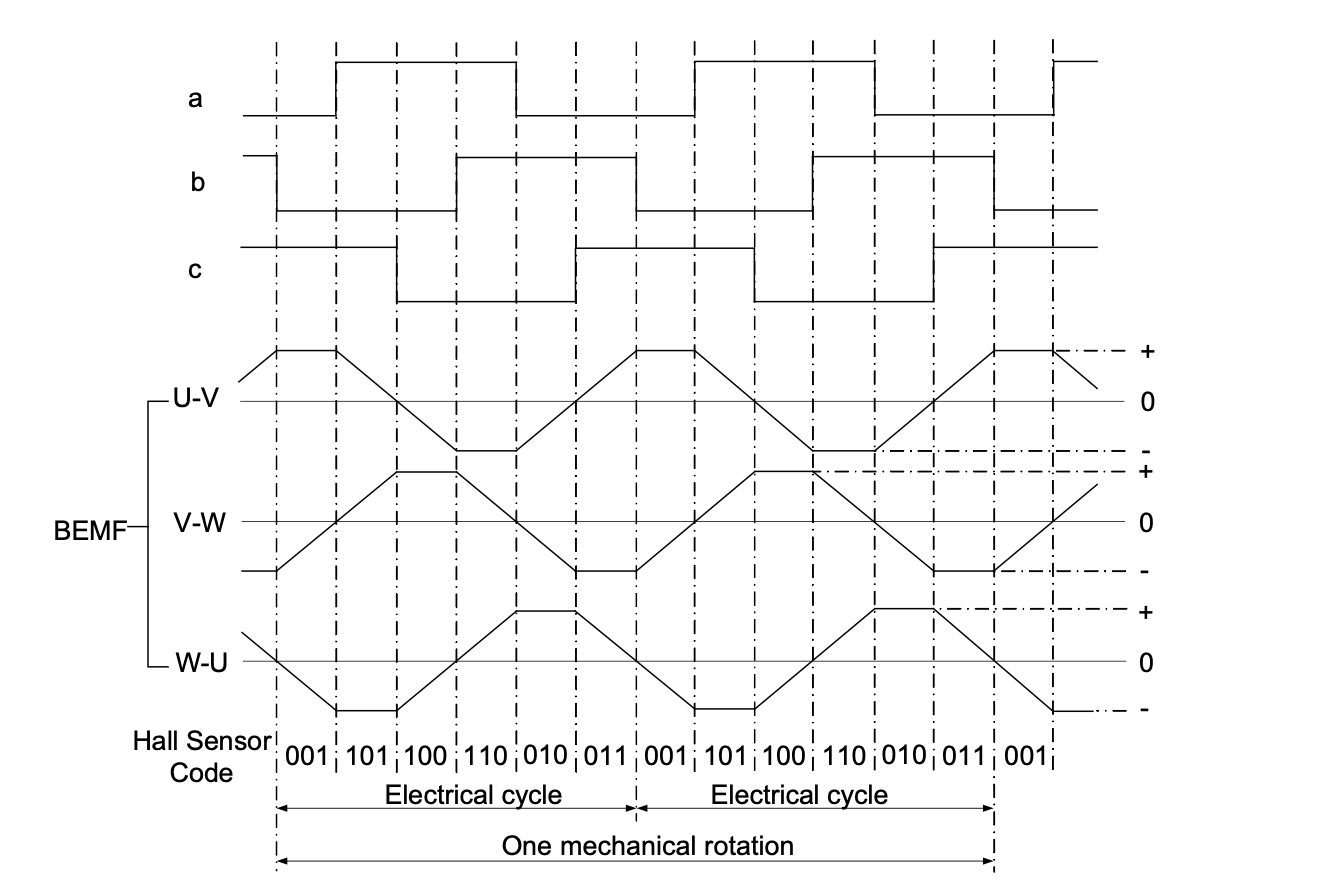
images/BEMF.png
