plauer03/T3_3200/images/clean_proto.png

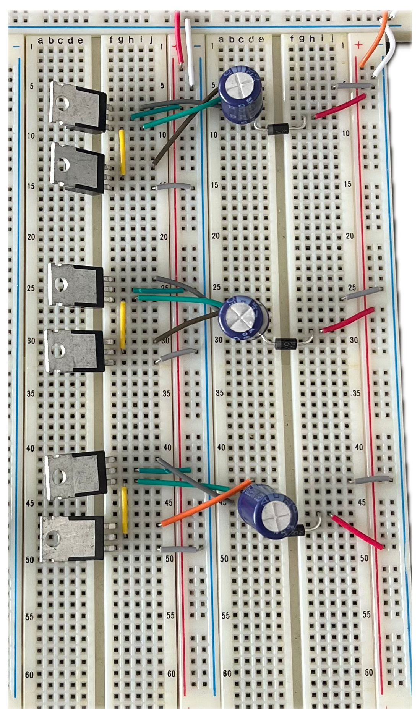
images/clean_proto.png
