plauer03/T3_3200/images/floating.png

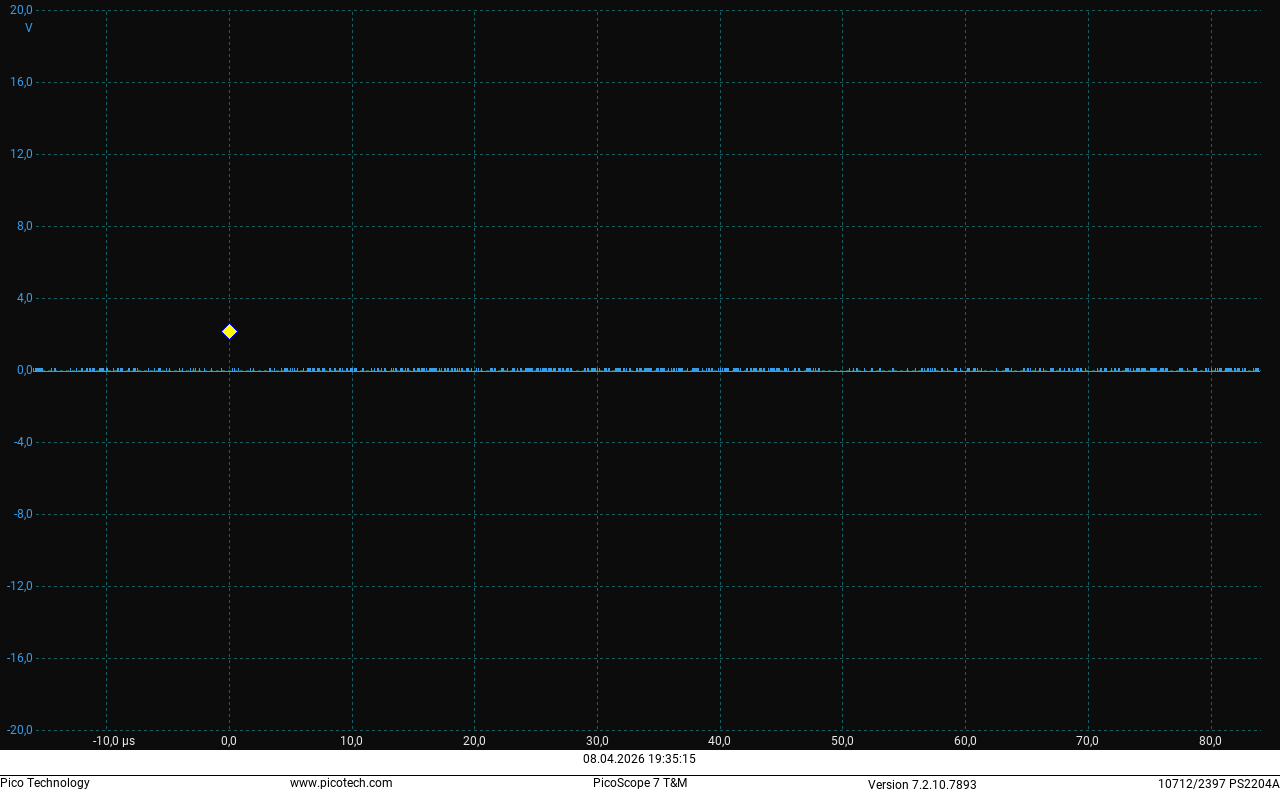
images/floating.png
