plauer03/T3_3200/images/Leitend.png

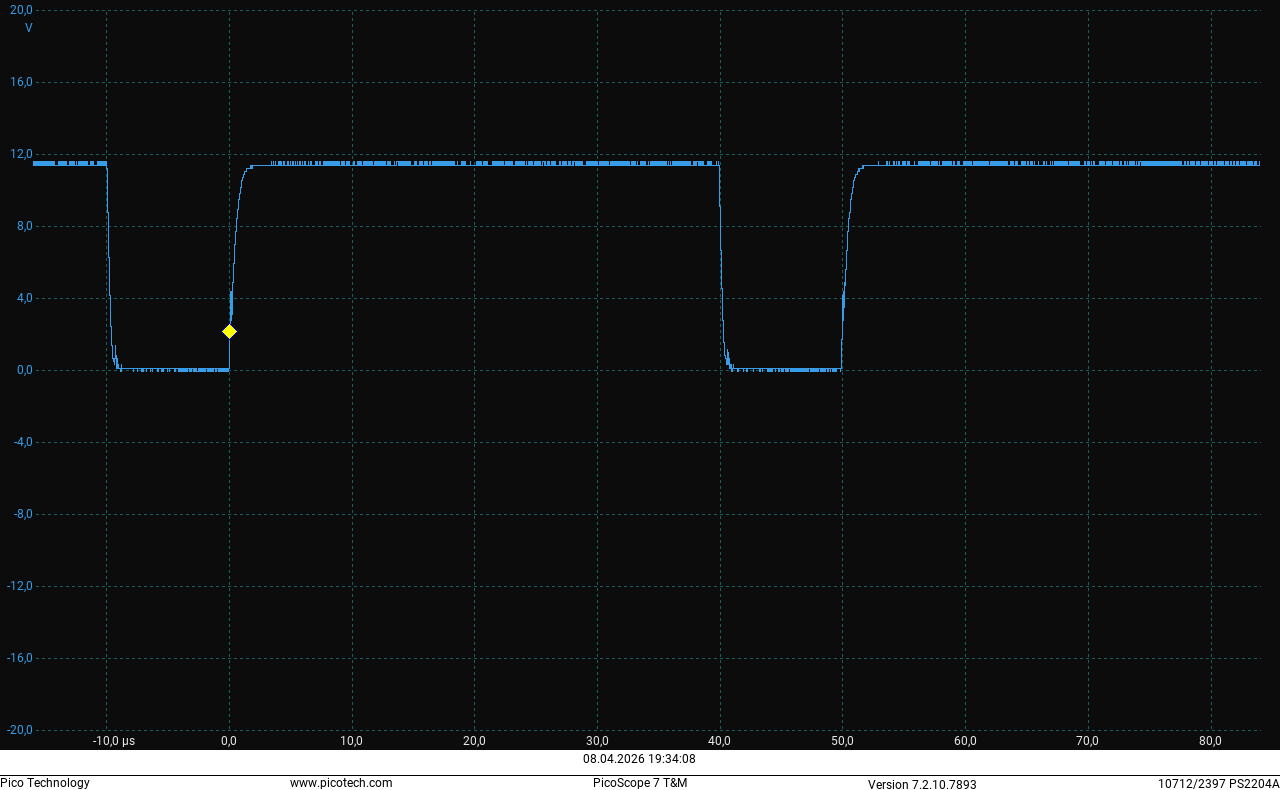
images/Leitend.png
