plauer03/T3_3200/images/leitend_oberschwinger.png

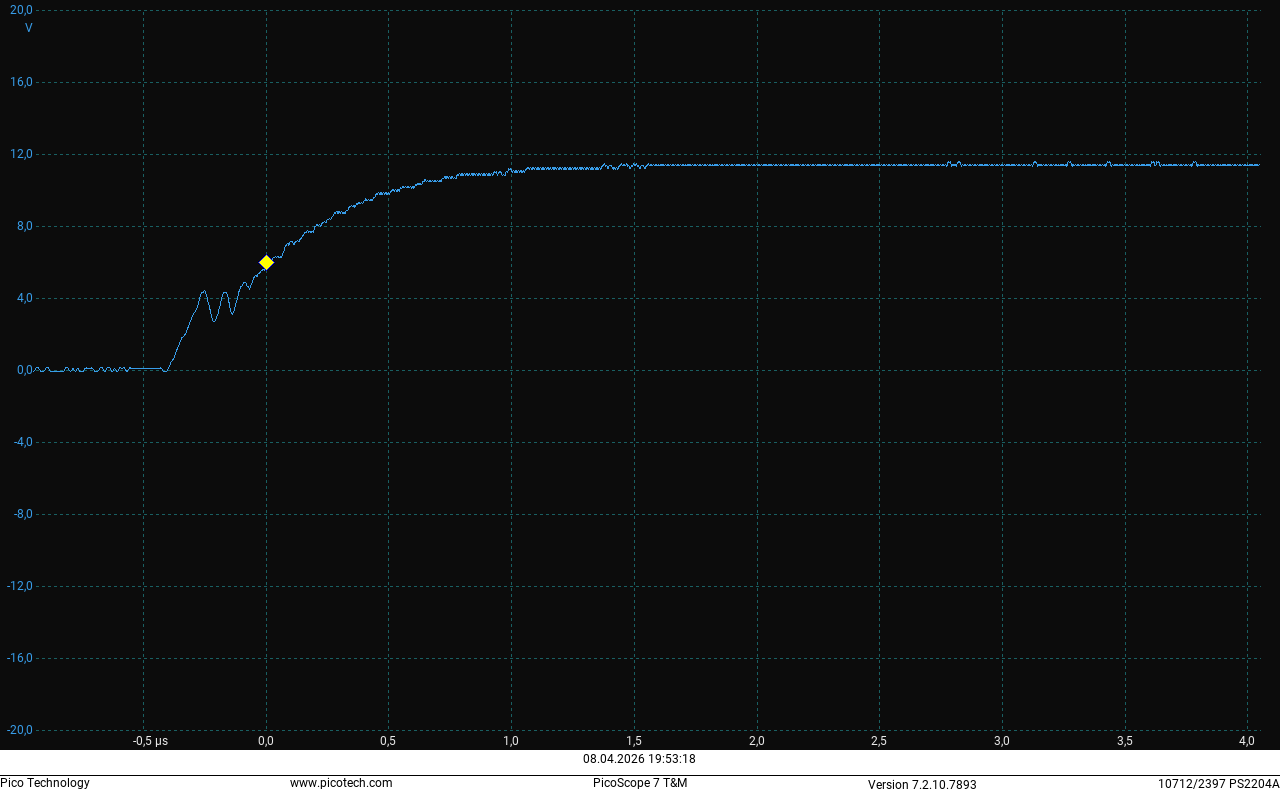
images/leitend_oberschwinger.png
