plauer03/T3_3200/images/lochraster.png

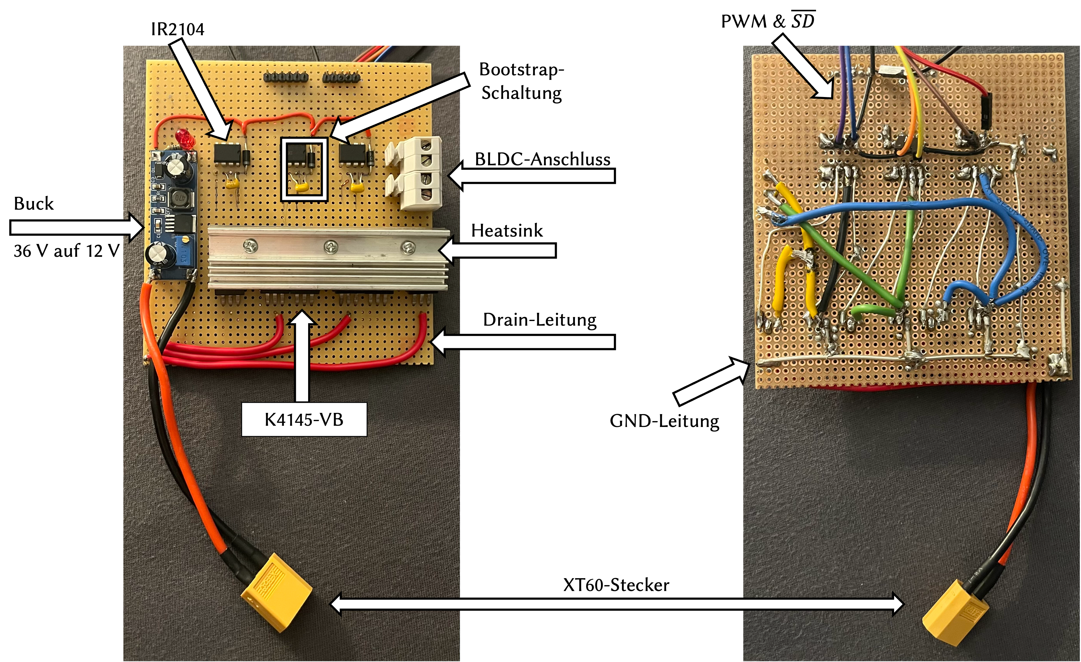
images/lochraster.png
