plauer03/T3_3200/images/steckbrett_motor.jpeg

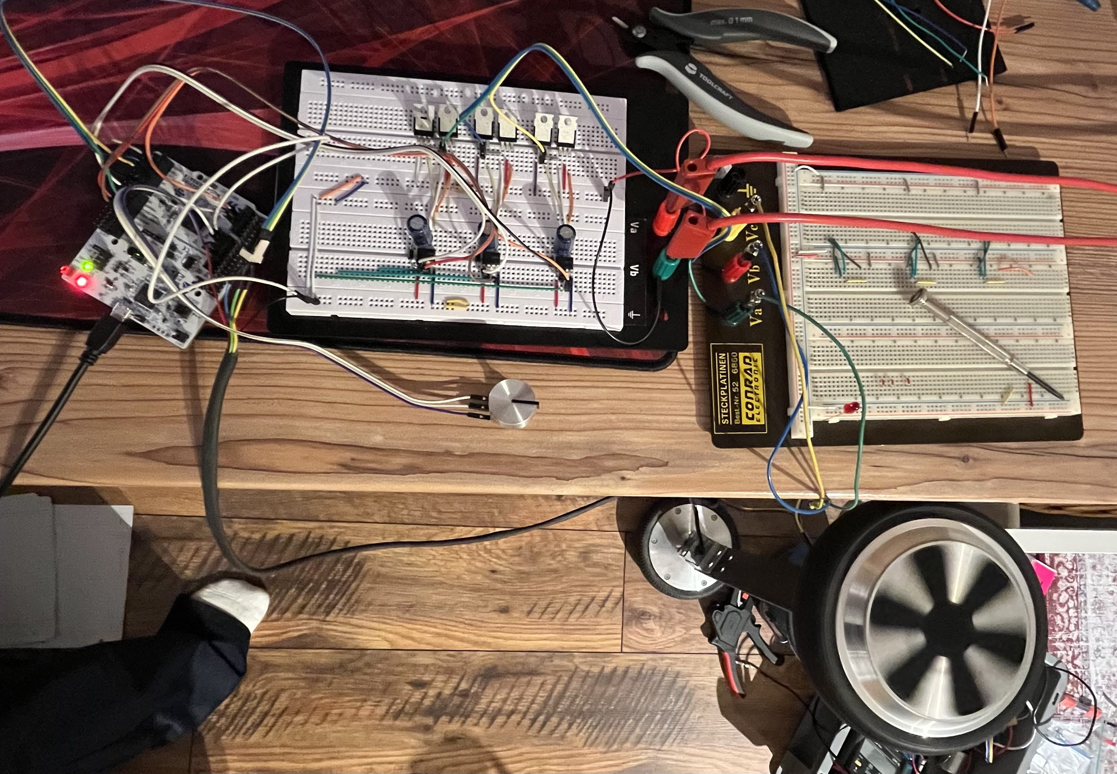
images/steckbrett_motor.jpeg
