plauer03/T3_3200/chapters/06_aufbau_mess.tex

\chapter{Aufbau und Messungen}
\label{chap:aufbau_messungen}

Dieses Kapitel dokumentiert die praktische Umsetzung und Verifikation des in den vorherigen Kapiteln theoretisch ausgelegten Motorcontrollers.

\section{Hardwareaufbau und iterative Prototypentwicklung}

Die Entwicklung der Hardware erfolgte in zwei Phasen, um das Risiko von Beschädigungen durch Softwarefehler zu minimieren. 

\subsection{Proof of Concept (Steckbrett-Aufbau)}

Aufgrund von Verzögerungen im internen Beschaffungsprozess wurde der erste Prototyp mit Komponenten aus einer alten Hoverboard-Endstufe realisiert, um den Zeitplan nicht zu gefährden. Hierfür kamen N-Kanal-MOSFETs des Typs K4145 sowie Halbbrückentreiber vom Typ FD2103S zum Einsatz, welche für den experimentellen Aufbau auf SMD-Adapterplatinen gelötet wurden. Die Verdrahtung auf dem Steckbrett erfolgte strikt nach der in Kapitel \ref{chap:entwurf_leistung} dimensionierten Topologie. 
Für die erste funktionale Validierung der Kommutierungslogik wurde initial ein Arduino DUE als Mikrocontroller verwendet, bevor das System auf die finale Architektur des STM32 (NUCLEO-G431RB) migriert wurde. Abbildung~\ref{fig:aufbau_breadboard} zeigt diesen Laboraufbau mit dem angeschlossenen BLDC-Motor.

\begin{figure}[htbp]
    \centering
     
    \caption{Steckbrett-Prototyp zur softwareseitigen Validierung des BLDC-Controllers.}
    \label{fig:aufbau_breadboard}
\end{figure}

Zur Vermeidung thermischer Überlastungen der limitierten Steckbrett-Kontakte erfolgten sämtliche Tests zwingend an einem strombegrenzten Labornetzteil. Dies ermöglichte eine gefahrlose Charakterisierung des Motorleerlaufstroms sowie die sichere Verifikation durch die Strombegrenzung. Nachdem die finalen IR2104-Gate-Treiber zur Verfügung standen, wurde die Hardware aktualisiert. Aufgrund anhaltender Lieferverzögerungen der IPP034N08N5-MOSFETs wurden die ausgiebigen Softwaretests der Steuerlogik (vgl. Kapitel \ref{sec:softwarekonzept}) jedoch weiterhin mit den Bestandshalbleitern abgeschlossen. Der finale Code des STM32 ist zur vollständigen Nachvollziehbarkeit in Anhang \ref{app:software} dokumentiert.
Die erfolgreiche Inbetriebnahme dieses Aufbaus bestätigte das theoretische Softwarekonzept in der Praxis. Eine strikte softwareseitige Begrenzung des Tastverhältnisses auf $5\,\%$ bis $95\,\%$ stellte die kontinuierliche Umladung der Bootstrap-Kondensatoren sicher und verhinderte Stottern beim Anlauf. Ein kritischer Fokus lag auf der Überprüfung der internen Deadtime von $520\,\mathrm{ns}$. Selbst bei hochdynamischen Last- und Sollwertsprüngen traten keine unzulässigen Brückenkurzschlüsse auf. 
Bei einer Strombegrenzung des Labornetzteils auf $5\,\mathrm{A}$ zeigte das System ein robustes Kommutierungsverhalten, ohne dass die Schutzmechanismen ungewollt auslösten. Nach der erfolgreichen Validierung der Gate-Signale und der Phasenströme am Steckbrett mit dem Oszilloskop wurde die Topologie für den Hochstrombetrieb in einen verlöteten Lochrasterprototypen überführt, welcher im nachfolgenden Abschnitt beschrieben wird.

\subsection{Leistungsprototyp (Lochraster-Aufbau)}

Zur Evaluierung des Systems unter höheren Lastbedingungen wurde die verifizierte Schaltungstopologie im nächsten Entwicklungsschritt auf eine Lochrasterplatine überführt. Aufgrund anhaltender Lieferengpässe der spezifizierten IR2104-Gate-Treiber erfolgte die initiale Bestückung ebenfalls mit den temporären FD2103S-Bausteinen auf SMD-Adaptern. Bei der ersten Inbetriebnahme dieses Aufbaus führte eine fehlerhafte Lötverbindung zu einem parasitären Brückenkurzschluss, was die sofortige thermische Zerstörung von zwei Treiberbausteinen zur Folge hatte und den Testfortschritt mangels Ersatzteilen verzögerte. Nach dem Eintreffen der finalen Komponenten wurde die Leistungsendstufe vollständig auf die in Kapitel \ref{chap:entwurf_leistung} dimensionierten IR2104-Treiber migriert. Um erneute Defekte auszuschließen, wurde die überarbeitete Platine vor der erneuten Inbetriebnahme einer detaillierten optischen Inspektion sowie einer elektrischen Durchgangsprüfung unterzogen. Da eine konventionelle Lochrasterplatine thermisch und elektrisch nicht für die anvisierten Phasenströme von bis zu $42{,}4\,\mathrm{A}$ ausgelegt ist, wurden sämtliche Hochstrompfade auf der Unterseite mit Kupferdrahteinlagen und großflächigen Lötzinnverbindungen verstärkt. Dies betrifft primär die Zwischenkreisversorgung sowie die Phasenabgänge. Abbildung \ref{fig:lochraster_proto} zeigt den vollständigen Aufbau des Leistungsprototyps in der Drauf- und Unteransicht. Die anschließende hardwarenahe Inbetriebnahme erfolgte stufenweise an einem strombegrenzten Labornetzteil, um bei eventuellen Fehlkommutierungen Folgeschäden abzuwenden, bevor der uneingeschränkte Betrieb am Akkumulator freigegeben wurde. Umfassende Dauerlastversuche bei Nennstrom zur finalen Evaluierung des passiven Kühlkonzepts konnten aus thermischen Gründen sowie im zeitlichen Rahmen des Projektumfangs nicht vollständig am Prüfstand durchgeführt werden. Aus diesem Grund beschränken sich die nachfolgenden thermischen Validierungen auf reduzierte Lastprofile.

\begin{figure}[htbp]
    \centering
    
    \caption{Der finale Leistungsprototyp auf Basis einer Lochrasterplatine.}
    \label{fig:lochraster_proto}
\end{figure}

\section{Inbetriebnahme und Schutzfunktionen}
\label{sec:inbetriebnahme}

Die erste Inbetriebnahme des Leistungsteils erfolgte iterativ und unter strikten Sicherheitsvorkehrungen, um Hardwareschäden durch unentdeckte Softwarefehler zu vermeiden. Zunächst wurde der Zwischenkreis nicht mit dem nominellen $36\,\mathrm{V}$-Akkumulator, sondern mit einem auf $12\,\mathrm{V}$ und $2\,\mathrm{A}$ strombegrenzten Labornetzteil gespeist. In diesem sicheren Arbeitspunkt konnte das grundsätzliche Kommutierungsverhalten der Brücke sowie die ordnungsgemäße Stromaufnahme der Gate-Treiber im Leerlauf verifiziert werden.
Ein essenzieller Teil der Inbetriebnahme war die Validierung der in Kapitel \ref{sec:softwarekonzept} beschriebenen Schutzfunktionen. Hierbei wurde primär die Emergency-Stop-Routine getestet. Durch das softwareseitige Herabsetzen des Sollwerts (Poti-Eingang $< 5\,\%$) wurden die Shutdown-Pins ($\overline{\mathrm{SD}}$) der IR2104-Treiber durch den Mikrocontroller bestimmungsgemäß auf ein Low-Potenzial gezogen. Dies versetzte alle MOSFETs unverzüglich in den hochohmigen Zustand und bewies die Funktionsfähigkeit des implementierten Fail-Safe-Konzepts vor dem Anlegen hoher Lastströme.
\section{Elektrische Charakterisierung}
\label{sec:elektrische_messungen}

Zur Verifikation der Schaltvorgänge wurden Messungen mit einem Digitaloszilloskop im laufenden Betrieb durchgeführt. Um Kurzschlüsse über erdbezogene Oszilloskop-Massen zu vermeiden, erfolgten die Messungen massebezogen direkt am Gate-Ausgang (LO) des IR2104-Treibers der Phase U. Anhand dieses Signals lassen sich sowohl das transiente Flankenverhalten als auch die drei Zustände der Kommutierung präzise analysieren. Die im Gate-Treiber hardwareseitig integrierte Totzeit von $520\,\mathrm{ns}$ stellt den Kurzschlussschutz der Halbbrücke hierbei konstruktiv sicher.

\subsection{Transientes Schaltverhalten und Gate-Widerstand}
\label{subsec:messung_schaltflanke}

Um das dynamische Schaltverhalten der MOSFETs und die korrekte Dimensionierung des Gate-Vorwiderstands ($R_{\mathrm{G}} = 10\,\Omega$) zu validieren, wurde die steigende Schaltflanke hochauflösend abgetastet. Um das Messrauschen für die Auswertung zu bereinigen, wurden die Rohdaten exportiert und in Abbildung \ref{fig:gate_flanke_csv} dargestellt. Das entsprechende Oszillogramm ist zur Nachvollziehbarkeit in Anhang \ref{app:transient} dokumentiert.

\begin{figure}[htbp]
    \centering
    \begin{tikzpicture}
        \begin{axis}[
            width=0.9\textwidth,
            height=7cm,
            grid=major,
            grid style={dashed, gray!40},
            xlabel={Zeit $t$ [$\mu\mathrm{s}$]},
            ylabel={Spannung $v_{\mathrm{LO}}$ [V]},
            xmin=-0.5, xmax=4.0,
            ymin=-1, ymax=13,
            xtick={-0.5, 0, 0.5, 1, 1.5, 2, 2.5, 3, 3.5, 4},
            ytick={0, 2, 4, 6, 8, 10, 12},
            legend pos=south east,
            axis lines=left,
            thick,
            scaled x ticks=false
        ]

        \addplot[
            color=blue, 
            thick, 
            mark=none
        ] 
        table[col sep=semicolon] {images/leitend_oberschwinger.csv};
        
        \addlegendentry{Messwert}

        % Markierung des theoretischen Plateaus lt. Kapitel 4
        \draw[dashed, color=red] (axis cs:-0.5, 4.4) -- (axis cs:4.0, 4.4);
        \node[color=red, anchor=south east, fill=white, fill opacity=0.85, text opacity=1] at (axis cs:3.9, 4.4) {$v_{\mathrm{GS,Mi}} \approx 4{,}4\,\mathrm{V}$};

        \end{axis}
    \end{tikzpicture}
    \caption{Darstellung der steigenden Schaltflanke am LS-Gate.}
    \label{fig:gate_flanke_csv}
\end{figure}

Das Oszillogramm zeigt den stetigen Spannungsanstieg auf das Niveau der Treiberspannung. Die erreichte Maximalspannung von ca. $11{,}5\,\mathrm{V}$ resultiert aus dem internen Spannungsabfall der Treiber-Endstufe gegenüber der $12\,\mathrm{V}$-Versorgung. 
Im dynamischen Umschaltbereich zwischen $t \approx -0{,}3\,\mathrm{\mu s}$ und $0{,}1\,\mathrm{\mu s}$ wird das charakteristische Miller-Plateau durchlaufen. Wie in der Verlustanalyse (vgl. Abschnitt \ref{subsec:schaltverluste}) dargelegt, beträgt die theoretische Millerspannung gemäß Spezifikation $v_{\mathrm{GS,Mi}} = 5{,}0\,\mathrm{V}$ \cite{DS_IPP034N08N5}. Im gemessenen Verlauf flacht der Spannungsanstieg jedoch bereits bei etwa $4{,}4\,\mathrm{V}$ ab. Diese Abweichung lässt sich physikalisch begründen. Der Datenblattwert bezieht sich auf den vollen Nennstrom der Halbleiter. Da die Messung zur sicheren Inbetriebnahme bei einem wesentlich geringeren Phasenstrom erfolgte, sinkt das Spannungsniveau, bei dem der Transistor den Laststrom übernimmt, entsprechend ab. Zudem erfasst die Oszilloskopmessung gegen die zentrale Masse nicht ausschließlich die reine Gate-Source-Spannung, sondern addiert den transienten induktiven Spannungsabfall der Source-Zuleitungen auf der Lochrasterplatine, was die sichtbaren Schwingungen in der Umschaltphase verursacht.
Trotz des induktiven Prototypenaufbaus belegt der Kurvenverlauf die Wirksamkeit des gewählten Gate-Widerstands. Die Flankensteilheit wird ausreichend begrenzt, sodass die auftretenden Schwingungen stark gedämpft bleiben. Kritische Spannungsüberschwinger, die das Gate-Oxid gefährden könnten, werden somit sicher vermieden.

\subsection{Verifikation der Kommutierungszustände}
\label{subsec:messung_kommutierung}

Die korrekte Umsetzung der in Kapitel 3 definierten Firmware-Architektur lässt sich an den drei zyklischen Betriebszuständen des LS-MOSFETs verifizieren. Um die drei aufeinanderfolgenden $120^\circ$-Sektoren eines elektrischen Umlaufs vergleichend zu analysieren, wurden die Oszilloskop-Rohdaten vektorisiert und in Abbildung \ref{fig:kommutierungs_zustaende_plot} übereinandergelegt. Die zugehörigen originalen Oszillogramme sind zur vollständigen Dokumentation in Anhang \ref{app:cyclic} hinterlegt.

\begin{figure}[htbp]
    \centering
    \begin{tikzpicture}
        \begin{axis}[
            width=0.95\textwidth,
            height=7.5cm,
            grid=major,
            grid style={dashed, gray!40},
            xlabel={Zeit $t$ [$\mu\mathrm{s}$]},
            ylabel={Spannung $v_{\mathrm{LO}}$ [V]},
            xmin=-10, xmax=90,     % Zeigt exakt 2 PWM Perioden (50µs = 20kHz)
            ymin=-2, ymax=14,
            xtick={-10, 10, 30, 50, 70, 90},
            ytick={0, 3, 6, 9, 12},
            legend style={
                at={(0.97,0.5)}, % Position: 97% der Breite, 50% der Höhe
                anchor=east      % Der "East"-Punkt der Legende liegt auf dieser Koordinate
            },
            axis lines=left,
            thick,
            scaled x ticks=false
        ]
        
        % 1. Aktiver PWM-Zustand (Blaue, durchgezogene Linie)
        \addplot[color=blue, thick, mark=none, each nth point=20] 
            table[col sep=semicolon] {images/Leitend_01.csv};
        \addlegendentry{PWM-Betrieb}

        % 2. Rückleiter-Zustand (Rote, gestrichelte Linie)
        \addplot[color=red, very thick, dashed, mark=none, each nth point=20] 
            table[col sep=semicolon] {images/full_leitend_01.csv};
        \addlegendentry{Rückleiter-Betrieb}

        % 3. Floating-Zustand (Grüne, gepunktete Linie)
        \addplot[color=green!60!black, very thick, dotted, mark=none, each nth point=20] 
            table[col sep=semicolon] {images/floating_01.csv};
        \addlegendentry{Floating-Betrieb}

        \end{axis}
    \end{tikzpicture}
    \caption{Gegenüberstellung der drei Kommutierungszustände am LS-Gate.}
    \label{fig:kommutierungs_zustaende_plot}
\end{figure}

Die übereinandergelegten Messreihen belegen das einwandfreie Zusammenspiel zwischen der STM32-Software und dem Gate-Treiber. Befindet sich die Phase im bestromten, positiven Sektor (blaue Kurve), taktet der Mikrocontroller das PWM-Signal mit einer Frequenz von exakt $20\,\mathrm{kHz}$, was sich in der gemessenen Periodendauer von $50\,\mathrm{\mu s}$ widerspiegelt. Aufgrund der komplementären Ansteuerlogik des IR2104-Treibers wird der LS-MOSFET in der PWM-Ausschaltphase der HS aktiv durchgesteuert. Dadurch ist die in Abschnitt \ref{subsec:leitverluste} geforderte verlustarme Synchrongleichrichtung messtechnisch nachgewiesen.
Wechselt die Motorphase in den negativen Sektor (rote Kurve), fungiert sie als dedizierter Rückleiter für den Phasenstrom. Die Software erzwingt in diesem Zustand zyklisch ein konstantes Tastverhältnis von $0\,\%$. Demnach steuert der Treiber den LS-MOSFET statisch mit der vollen Treiberspannung von ca. $11{,}5\,\mathrm{V}$ durch, um die ohmschen Leitverluste im Halbleiter zu minimieren.
Während der antriebslosen BEMF-Messphase (grüne Kurve) wird die Halbbrücke schließlich vollständig abgeschaltet. Der Mikrocontroller zieht den zugehörigen Shutdown-Pin ($\overline{\mathrm{SD}}$) auf ein Low-Potenzial. Das Oszillogramm zeigt in diesem Sektor ein konstantes Massepotenzial ($0\,\mathrm{V}$) am Gate, wodurch sichergestellt ist, dass die Phase sicher hochohmig (Floating) verbleibt und keine unerwünschten brückeninternen Querströme fließen können.

\section{Thermische Evaluation am Prototyp}
\label{sec:thermik_eval}

Wie im thermischen Entwurf in Kapitel \ref{chap:thermik} berechnet, ist für den Volllastbetrieb zwingend eine aktive Kühlung erforderlich, um die anfallende Verlustleistung von $28{,}56\,\mathrm{W}$ sicher abzuführen. Aus zeitlichen Gründen und mangels eines geeigneten Prüfstands (wie beispielsweise eines Leistungswiderstands) konnte eine vollständige thermische Validierung unter Nennlast nicht physisch vollzogen werden. Um dennoch eine Aussage über die Güte des Kühldesigns treffen zu können, wurde ein Leerlauftest durchgeführt. Ziel ist es, die thermische Erwärmung des Systems zu messen und anhand der bestehenden theoretischen Verlustberechnungen auf den Volllastbetrieb zu extrapolieren.

\subsection{Messaufbau und Leerlauf-Dauertest}

Für den Test wurde der BLDC-Motor ohne mechanische Last bei maximaler Drehzahl (Sollwertvorgabe $100\,\%$) betrieben. Die Strommessung ergab hierbei einen konstanten stationären Leerlaufstrom von $I_{\mathrm{RMS}} \approx 450\,\mathrm{mA}$. 
Zur messtechnischen Erfassung des thermischen Verhaltens wurde ein System auf Basis eines Arduino Nano implementiert. Als Sensor fungierte ein analoger Temperatursensor vom Typ TMP36GT9Z, welcher mithilfe eines Silikonpads direkt auf dem Aluminiumkühlkörper fixiert wurde. Der Mikrocontroller erfasste die Kühlkörpertemperatur über einen Zeitraum von 10 Minuten. Um das Messrauschen zu reduzieren, wurde softwareseitig ein gleitender Mittelwert (Oversampling) über 10 Einzelmessungen angewendet. Der vollständige Quellcode des Messsystems ist in Anhang \ref{app:arduino_code} dokumentiert.
Abbildung \ref{fig:thermik_plot} zeigt den resultierenden Temperaturverlauf des Kühlkörpers. Auf eine mathematische Glättung der Datenpunkte wurde bewusst verzichtet, um die reale Auflösung und das Quantisierungsverhalten des Sensors abzubilden.

\begin{figure}[htbp]
    \centering
    \begin{tikzpicture}
        \begin{axis}[
            width=0.9\textwidth,
            height=6.5cm,
            grid=major,
            grid style={dashed, gray!40},
            xlabel={Zeit $t$ [s]},
            ylabel={Kühlkörpertemperatur $T_{\mathrm{S}}$ [$^\circ\mathrm{C}$]},
            xmin=0, xmax=600,
            ymin=21.8, ymax=22.8,
            xtick={0, 100, 200, 300, 400, 500, 600},
            ytick={21.8, 22.0, 22.2, 22.4, 22.6, 22.8},
            legend pos=south east,
            axis lines=left,
            thick,
            y tick label style={
                /pgf/number format/.cd,
                fixed,
                fixed zerofill,
                precision=1,
                /tikz/.cd
            }
        ]
        
        \addplot[
            color=red, 
            thick, 
            mark=none
        ] coordinates {
            (0, 22.0) (10, 22.0) (20, 22.1) (30, 22.2) (40, 22.2) 
            (50, 22.3) (60, 22.3) (70, 22.3) (80, 22.3) (90, 22.4) 
            (100, 22.4) (110, 22.4) (120, 22.4) (130, 22.5) (140, 22.5) 
            (150, 22.4) (160, 22.4) (170, 22.5) (180, 22.5) (190, 22.5) 
            (200, 22.5) (210, 22.4) (220, 22.4) (230, 22.5) (240, 22.5) 
            (250, 22.5) (260, 22.5) (270, 22.5) (280, 22.5) (290, 22.4) 
            (300, 22.5) (310, 22.5) (320, 22.5) (330, 22.5) (340, 22.5) 
            (350, 22.5) (360, 22.4) (370, 22.6) (380, 22.6) (390, 22.5) 
            (400, 22.4) (410, 22.4) (420, 22.5) (430, 22.5) (440, 22.5) 
            (450, 22.5) (460, 22.5) (470, 22.5) (480, 22.5) (490, 22.5) 
            (500, 22.5) (510, 22.4) (520, 22.4) (530, 22.4) (540, 22.4) 
            (550, 22.5) (560, 22.4) (570, 22.4) (580, 22.5) (590, 22.5) 
            (600, 22.6)
        };
        \addlegendentry{Messwert TMP36GT9Z}

        \end{axis}
    \end{tikzpicture}
    \caption{Erwärmung des Kühlkörpers beim stationären Leerlaufstrom von $450\,\mathrm{mA}$.}
    \label{fig:thermik_plot}
\end{figure}

\subsection{Hochrechnung auf den Lastbetrieb}

Zu Beginn der Messung ($t=0\,\mathrm{s}$) betrug die Umgebungstemperatur $T_{\mathrm{A}} = 22{,}0^\circ\mathrm{C}$. Nach $600\,\mathrm{s}$ geht das System bei $T_{\mathrm{S}} \approx 22{,}5^\circ\mathrm{C}$ in einen quasi-stationären Zustand über. Dies entspricht einer minimalen Erwärmung von $\Delta T = 0{,}5\,\mathrm{K}$. 
Analysiert man die Ursache dieser Erwärmung, zeigt sich, dass die rein ohmschen Leitverluste im Leerlauf physikalisch vernachlässigbar klein sind.
Wie in den Gleichungen zur Verlustkalkulation (vgl. Kapitel \ref{chap:entwurf_leistung}) hergeleitet, betragen die statischen Leitverluste für einen Phasenstrang $P_{\mathrm{MOS,c}} = I_{\mathrm{RMS}}^2 \cdot R_{\mathrm{DS(on)}}(T_\mathrm{J})$. Für den gesamten dreiphasigen Umrichter ergibt sich daraus bei dem gemessenen Strom von $450\,\mathrm{mA}$:
\begin{equation}
    P_{\mathrm{MOS,c,total}} = 3 \cdot P_{\mathrm{MOS,c}} = 3 \cdot I_{\mathrm{RMS}}^2 \cdot R_{\mathrm{DS(on)}}(22{,}3^\circ\mathrm{C}) = 3 \cdot (0{,}45\,\mathrm{A})^2 \cdot 0{,}0034\,\Omega \approx 2{,}1\,\mathrm{mW}
\end{equation}
Die gemessene Temperaturdifferenz resultiert folglich fast ausschließlich aus den Ruheströmen der Steuerlogik sowie minimalen Schaltverlusten. Aus der gemessenen Erwärmung und dem in Kapitel \ref{chap:thermik} spezifizierten passiven Wärmewiderstand des Kühlkörpers ($R_{\mathrm{th,SA}} = 12\,\mathrm{K/W}$) lässt sich die maximale Verlustleistung der Endstufe wie folgt abschätzen:
\begin{equation}
    P_{\mathrm{MOS,max}} = \frac{\Delta T}{R_{\mathrm{th,SA}}} = \frac{0{,}5\,\mathrm{K}}{12\,\mathrm{K/W}} \approx 41{,}7\,\mathrm{mW}
\end{equation}
Dieser Wert im Milliwatt-Bereich korreliert exzellent mit der zu erwartenden statischen Verlustleistung der verwendeten aktiven Bauelemente und plausibilisiert somit die korrekte Funktion des thermischen Messaufbaus.
Da das grundlegende thermische Koppelverhalten des passiven Kühlkörpers hiermit bestätigt ist, lässt sich die Extrapolation auf den Leistungseinsatz durchführen. Wie im thermischen Entwurf detailliert hergeleitet wurde, resultiert der Nennbetrieb unter Volllast in einer berechneten Gesamtverlustleistung von $28{,}56\,\mathrm{W}$. 
Würde diese Leistung stationär in den aktuell rein passiv gekühlten Prototypenaufbau fließen, ergäbe sich über den statischen thermischen Widerstand des Kühlkörpers ein dramatischer Temperaturanstieg:
\begin{equation}
    \Delta T_{\mathrm{SA,max}} = 28{,}56\,\mathrm{W} \cdot 12\,\mathrm{K/W} \approx 342{,}7\,\mathrm{K}
\end{equation}
Addiert man diese berechnete Erwärmung zur Umgebungstemperatur, würde die Kühlkörpertemperatur rein rechnerisch auf über $360^\circ\mathrm{C}$ ansteigen. Selbst unter Berücksichtigung von thermischen Nichtlinearitäten würde die maximal zulässige Sperrschichttemperatur der MOSFETs ($T_{\mathrm{J,max}} = 175^\circ\mathrm{C}$) nach kürzester Betriebszeit drastisch überschritten werden, was einen Totalausfall der Endstufe durch Thermal Runaway zur Folge hätte.
Die durchgeführte Messung und die direkte analytische Extrapolation auf den Arbeitspunkt verifizieren somit die theoretische Auslegungsentscheidung aus Kapitel \ref{chap:thermik}. Der passive Prototyp ist mechanisch und thermisch ausschließlich für Leerlaufanalysen und geringe Ströme geeignet. Die Implementierung der aktiven Luftkühlung (Axiallüfter) zur signifikanten Reduktion des thermischen Gesamtwiderstands ist für den sicheren Nennbetrieb physikalisch unumgänglich.
