plauer03/T3_3200/images/endstufe.pdf

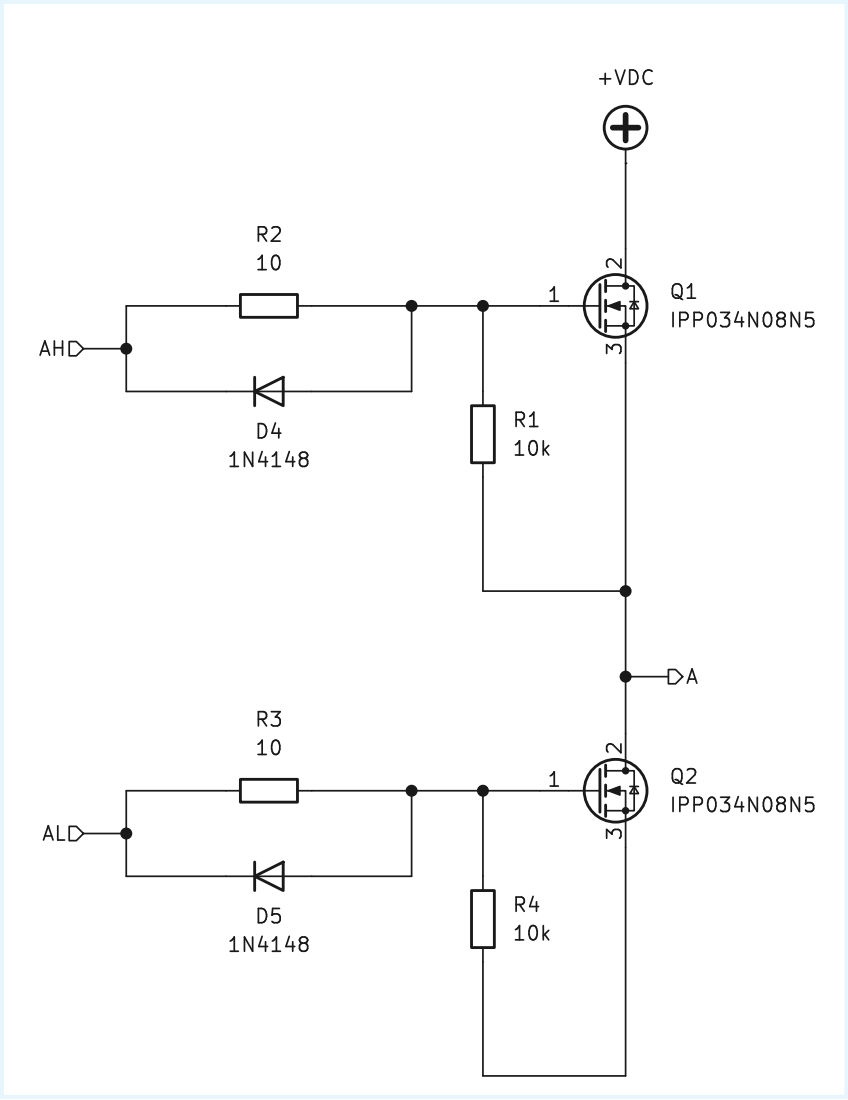
[picture p33: page 1]
