plauer03/T3_3200/images/gate-driver.pdf

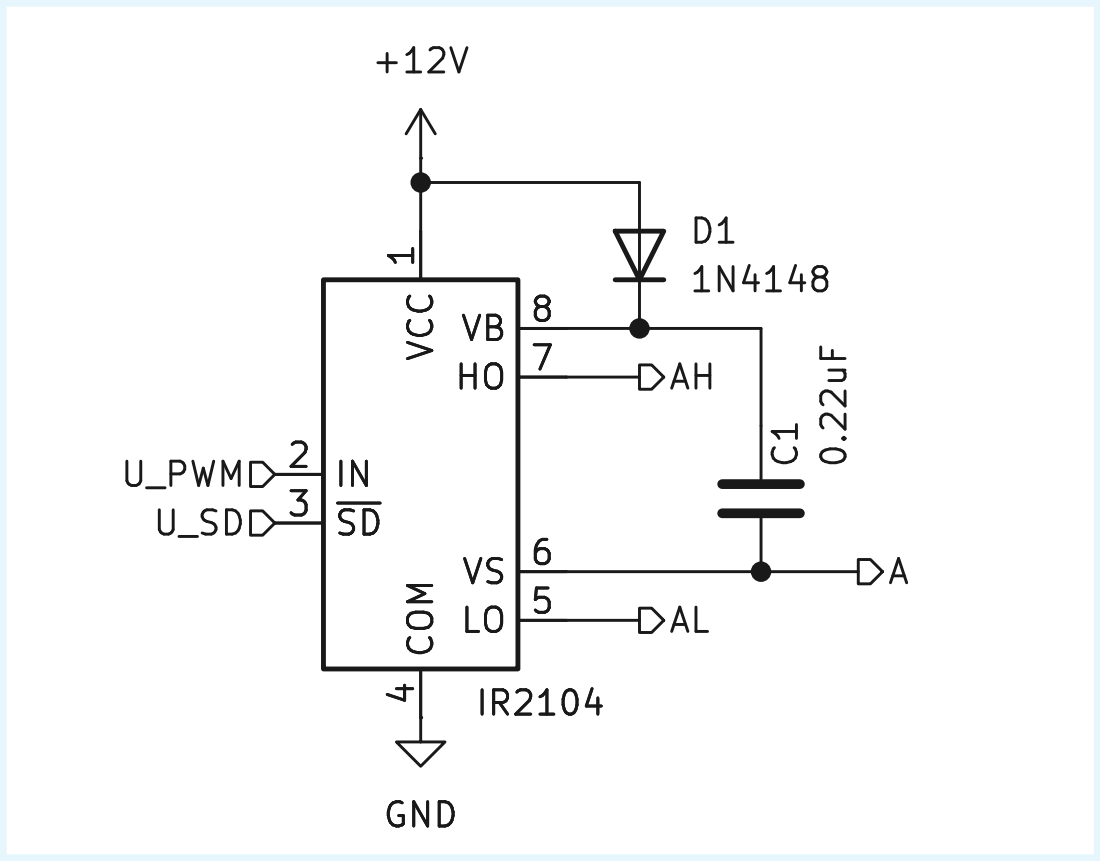
[picture p34: page 1]
