plauer03/T3_3200/images/kopplung.pdf

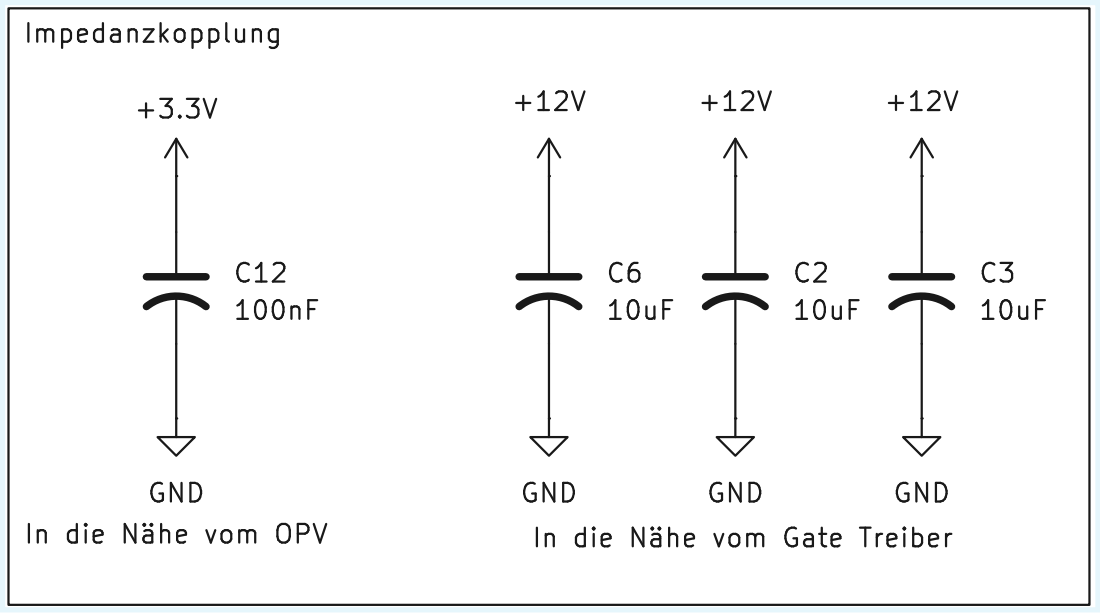
[picture p35: page 1]
