plauer03/T3_3200/images/shunt.pdf

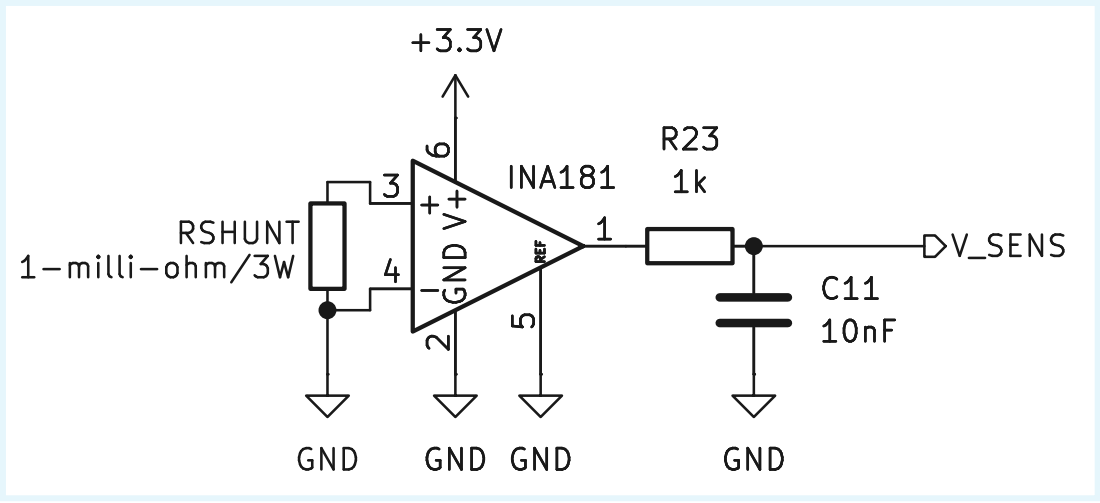
[picture p36: page 1]
