plauer03/T3_3200/images/schaltplan.pdf

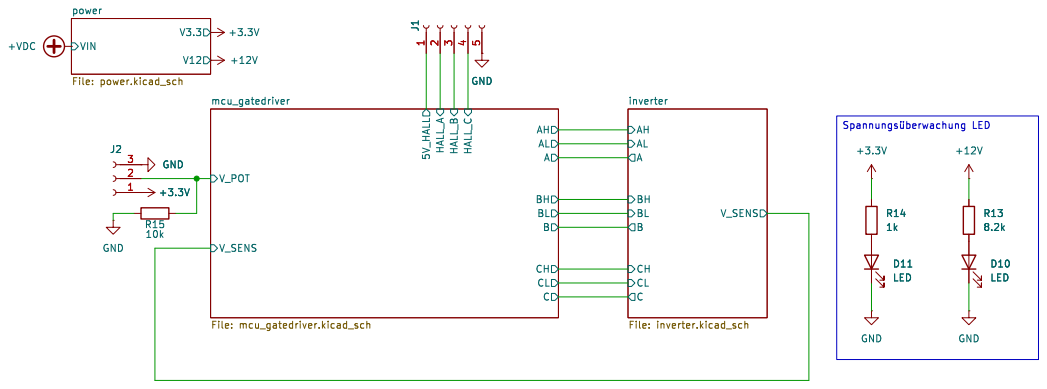
[picture p40: page 1]
