plauer03/T3_3200/(commit log)

2026-02-22 new diode chapter and plots
2026-03-19 komplett überarbeitet. rekuperation eingebaut und viele änderungen. six-step verlustrechnung hoffentlich fertig?! UNBEDINGT TODO: redundante baschnitte prüfen (vor allem aufgrund von rekuperation/cur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
2026-04-07 neue klarstellung über sinus ströme und kapitel syntax und layout überarbeitet
2026-04-08 new appendix and print test
2026-04-09 finaler commit, vstl endabgabe
    [Leitend_01.csv, floating_01.csv, full_leitend_01.csv, leitend_oberschwinger.csv]
